jeffmakes/tr20-badge-hw/docs/conn/USB-Connector-TYPE-B-SMT-1-9.jpg

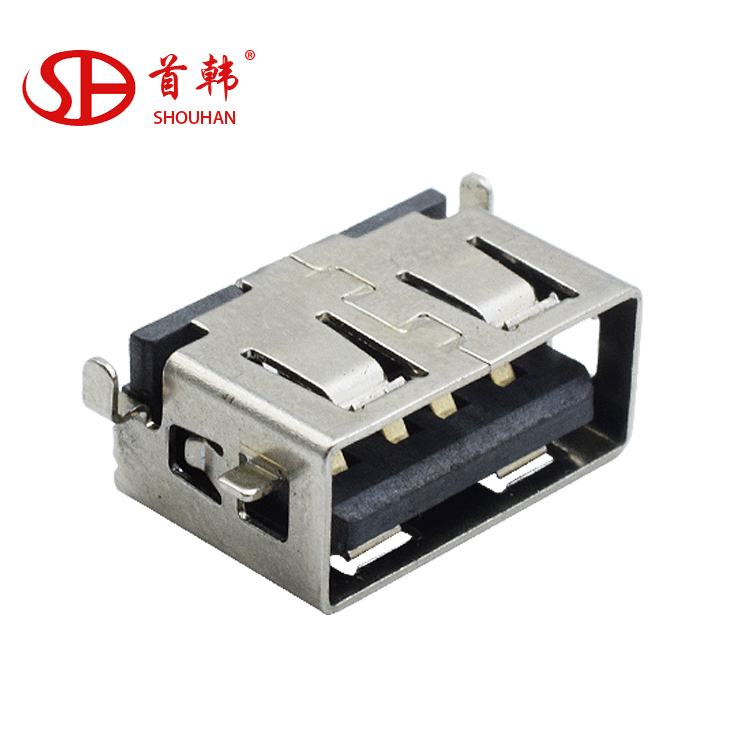
docs/conn/USB-Connector-TYPE-B-SMT-1-9.jpg
