jeffmakes/tr20-badge-hw/r1/graphics/tr20-3d-bottom.jpg

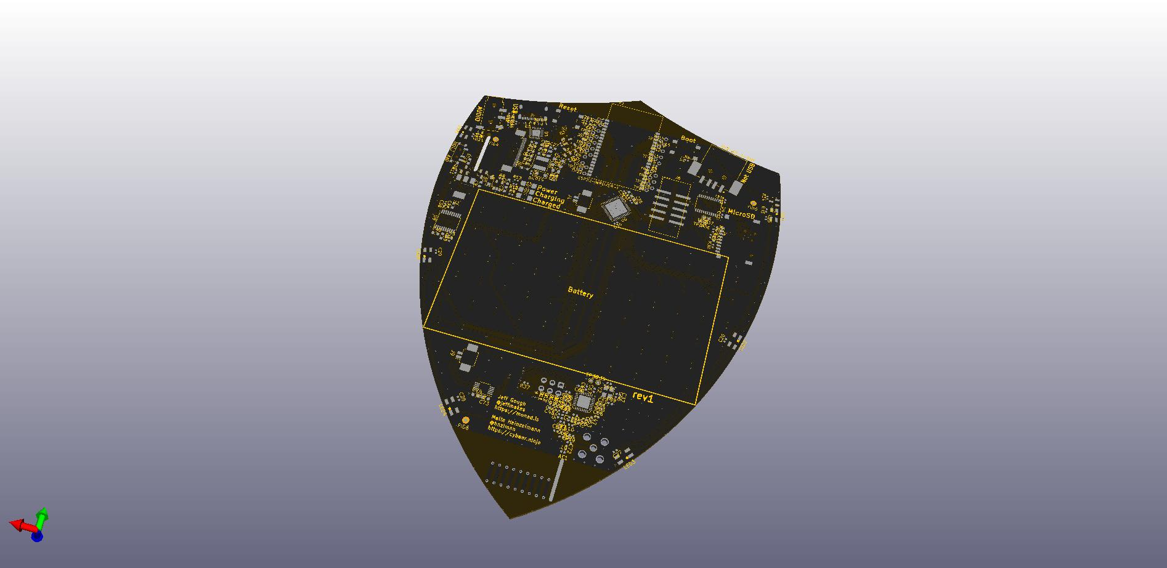
r1/graphics/tr20-3d-bottom.jpg
