jeffmakes/tr20-badge-hw/design/signals.ods

Sheet: ESP32 IO map
Subsystem | Device | Bus | Peripheral | TR20 Signal | ESP32 Signal | ESP32 Mux | GPIO | WROVER | Dir | Notes
External memory bus |  | SPI | SPI0 | nc |  | IO_MUX | 6
 |  | SPI | SPI0 | nc |  | IO_MUX | 7
 |  | SPI | SPI0 | nc |  | IO_MUX | 8
 |  | SPI | SPI0 | nc |  | IO_MUX | 9
 |  | SPI | SPI0 | nc |  | IO_MUX | 10
 |  | SPI | SPI0 | nc |  | IO_MUX | 11
Display | GDEH029A1 | SPI | SPI3 (VSPI) | MOSI | VSPID | IO_MUX | 23 | 37 | o
 |  | SPI | SPI3 (VSPI) | SCK | VSPICLK | IO_MUX | 18 | 30 | o
 |  |  | GPIO? | !DISP_CS | VSPICS0 | GPIO | 19 | 31 | o | Looks like we’re driving this manually in the display driver, not using the SPI peripheral
 |  |  | GPIO | !DC |  | GPIO | 27 | 12 | o
 |  |  | GPIO | DISP_BUSY |  | GPIO | 13 | 16 | i
 |  |  | GPIO | !DISP_RESET |  | GPIO | 0 | 25 | o | !RES reset line on display
Touch | IQS550 | I2C | I2C | SDA | I2CEXT0_SDA | GPIO | 4 | 26 | io
 |  | I2C | I2C | SCL | I2CEXT0_SCL | GPIO | 5 | 29 | o
 |  |  | GPIO | IQ_INT |  | GPIO | 36 | 4 | i
Haptic | ? | I2C
Shitty Add-On |  | I2C
Joystick / Buttons | PCA9555 | I2C | I2C | SDA |  | GPIO | 4 | 26 | io
 |  | I2C | I2C | SCL |  | GPIO | 5 | 29 | o
 |  |  | GPIO | BTN_INT |  | GPIO | 39 | 5 | i
USB-serial | CP2102N | UART | UART0 | TXD0 | U0TXD | IO_MUX | 1 | 35 | o
 |  | UART | UART0 | RXD0 | U0RXD | IO_MUX | 3 | 34 | i
Sound | PCM5100A | I2S | I2S0 | I2S_SD |  | GPIO | 25 | 10 | o | Any pin can be used, but let’s use 25 and 26 because they are the DAC1,2 outputs
 |  | I2S | I2S0 | I2S_SCK |  | GPIO | 26 | 11 | o | so we have the option of switching to internal DAC later…
 |  | I2S | I2S0 | I2S_WS |  | GPIO | 12 | 14 | o
Radio | CC1200 | SPI | SPI2 | MOSI | VSPID | IO_MUX | 23 | 37 | o | Connecting to the same SPI bus as the display, so we have enough pins free for SD card
 |  | SPI | SPI2 | MISO | VSPIQ | GPIO | 35 | 7 | i
 |  | SPI | SPI2 | SCK | VSPICLK | IO_MUX | 18 | 30 | o
 |  | SPI | SPI2 | !CC_CS | VSPICS1 | GPIO | 21 | 33 | o
 |  |  |  | CC_INT |  | GPIO | 34 | 6 | i
SD card |  | SD 1-bit | SD | SD_DAT0 | SD_DATA0 | IO_MUX | 2 | 24 | io
 |  | SD 1-bit | SD | SD_CMD | SD_CMD | IO_MUX | 15 | 23 | o
 |  | SD 1-bit | SD | SD_CLK | SD_CLK | IO_MUX | 14 | 13 | o
32kHz crystal |  | na | RTC | 32K_XN |  |  | 33 | 9 | a
 |  | na | RTC | 32K_XP |  |  | 32 | 8 | a
LED’s | WS2812? |  | ? | LED_DIN |  | GPIO | 22 | 36 | o
ESP usable GPIOS | Input only | Used by | WROVER pin
0 |  | !DISP_RESET | 25
1 |  | TXD0 | 35
2 |  | SD_DAT0 | 24
3 |  | RXD0 | 34
4 |  | SDA | 26
5 |  | SCL | 29
12 |  | I2S_WS | 14
13 |  | DISP_BUSY | 16
14 |  | SD_CLK | 13
15 |  | SD_CMD | 23
18 |  | SCK | 30
19 |  | !DISP_CS | 31
21 |  | !CC_CS | 33
22 |  | LED_DIN | 36
23 |  | MOSI | 37
25 |  | I2S_SD | 10
26 |  | I2S_SCK | 11
27 |  | !DC | 12
32 |  | 32K_XP | 8
33 |  | 32K_XN | 9
34 | y | CC_INT | 6
35 | y | MISO | 7
36 | y | IQ_INT | 4
39 | y | BTN_INT | 5

Sheet: PCA9555 IO map
PCA9555 | TR20 Signal | Notes
P0_0 | JOY_A
P0_1 | JOY_B
P0_2 | JOY_C
P0_3 | JOY_D
P0_4 | JOY_PUSH
P0_5 | BTN_A? | There may not be PCB space for buttons A and B because we need space for the CC1200 PCB antenna…
P0_6 | BTN_B? | There may not be PCB space for buttons A and B because we need space for the CC1200 PCB antenna…
P0_7 | BTN_START
P1_0 | CC_RESET | Hardware reset line for CC1200 is optional, since it supports reset over SPI, but this would be a bonus
P1_1 | IQ_RESET | Hardware reset line for the IQS550 – maybe useful for getting into the bootloader, though a software command exists
P1_2 | SD_DETECT | Presence of SD card
P1_3 | SAO_GPIO2 | Shitty addon GPIO2
P1_4
P1_5
P1_6
P1_7
