jeffmakes/tr20-badge-hw/r1/tr20-r1-mechanical/tr20-r1-coverlay.pdf

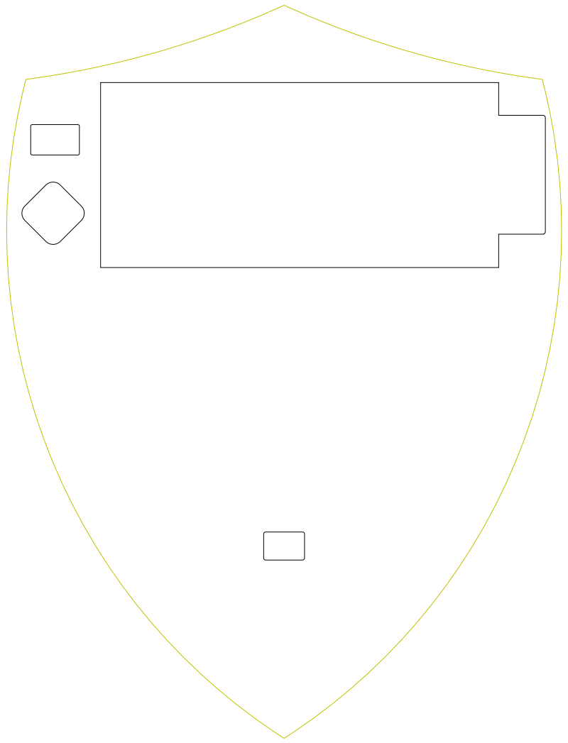
[picture p3: figure]
