jeffmakes/tr20-badge-hw/docs/display/Craft-Data-E-Paper-Product-List.pdf

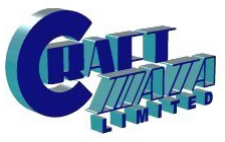
[picture p4: figure]

Craft Data Limited
- 01296 332000 01296 334625 Email: sales@craftdata.co.uk Web: www.craftdata.co.uk

# E-Paper Product List

Picture | Model | Specification

Mass
Production

Interface: SPI
GDEH154D27 Partial refresh | 1.54" (Dot Matrix EPD 200x200 dots) Outline Dimension: 31.8(H)x36.32(V)x1.05(D) mm | Yes
GDEP015OC1 Partial refresh | 1.54" (Dot Matrix EPD 200x200 dots) Outline Dimension: 31.8(H)x36.32(V)x1.05(D) m | Yes
GDEW0154Z17 | 1.54" 3‐color (Dot Matrix EPD 152x152 dots) Outline Dimension: 31.8(H)x37.32(V)x0.98(D) mm | Yes
GDEW154T8 Partial refresh | 1.54" (Dot Matrix EPD 152x152 dots) Outline Dimension: 31.8(H)x37.32(V)x0.98(D) mm | Yes
GDEW0154C39 | 1.54" 3‐color (Dot Matrix EPD 152x152 dots) Outline Dimension: 31.8(H)x37.32(V)x0.98(D) mm | Yes
1.54" Front Light | Outline Dimension: 36.32x31.8mm | Yes

GDE0213B1 Partial refresh | 2.13" (Dot Matrix EPD250x122dots) Outline Dimension: 29.20(H) x59.20 (V)x1.05(D)mm | Yes
GDEW0213Z16 | 2.13" 3‐color (Dot Matrix EPD 212x104 dots ) Outline Dimension: 59.2(H)×29.2 (V) ×0.98(D)mm | Yes
GDEW0213C38 | 2.13" 3‐color (Dot Matrix EPD 212x104 dots ) Outline Dimension: 59.2(H)×29.2 (V) ×0.98(D)mm | Yes
GDEW0213I5F Flexible | 2.13" (Dot Matrix EPD 212x104 dots) Outline Dimension: 59.2(H)×29.2 (V) ×0.3(D)mm | Yes
GDEW026T0 | 2.6" (Dot Matrix EPD 296x152dots) Outline Dimension: 36.30(H) x71.82 (V)x1.18(D)mm | Yes
GDEW027W3 | 2.7" (Dot Matrix EPD 264x176dots) Outline Dimension: 70.42(H) x45.8 (V)x0.98(D)mm | Yes
GDEW027C44 | 2.7" 3‐color(Dot Matrix EPD 264x176dots) Outline Dimension: 70.42(H) x45.8 (V)x0.98(D)mm | Yes
GDEH029A1 Partial refresh | 2.9" (Dot Matrix EPD 296x128 dots) Outline Dimension: 79.0 (H)×36.7 (V) ×1.05(D)mm | Yes

GDEW029Z10 | 2.9" 3‐color (Dot Matrix EPD 296x128 dots) Outline Dimension: 79.0 (H)x36.7 (V) x1.18(D)mm | Yes
GDEW029C32 | 2.9" 3‐color (Dot Matrix EPD 296x128 dots) Outline Dimension: 79.0 (H)x36.7 (V) x1.18(D)mm | Yes

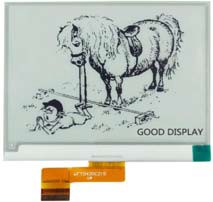
[picture p5: figure]

GDEW042T2 | 4.2" (Dot Matrix EPD 400x300 dots) Outline Dimension: 91.0(H)x77.0(V)x1.18(D)mm | Yes

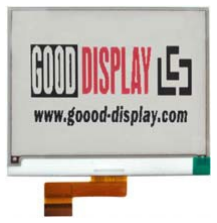
[picture p6: figure]

GDEW042Z15 | 4.2" 3‐color(Dot Matrix EPD 400x300 dots) Outline Dimension: 91.0(H)x77.0(V)x1.18(D)mm | Yes

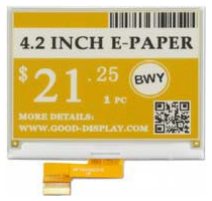
[picture p7: figure]

GDEW042C37 | 4.2" 3‐color(Dot Matrix EPD 400x300 dots) Outline Dimension: 91.0(H)x77.0(V)x1.18(D)mm | Yes

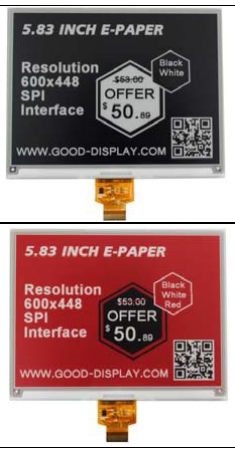
[picture p8: figure]

GDEW0583T7 | 5.83" (Dot Matrix EPD 600x488 dots) Outline Dimension: 125.40(H)*99.50(V)*1.18(D） | Yes
GDEW0583Z21 | 5.83" (Dot Matrix EPD 600x488 dots) Outline Dimension: 125.40(H)*99.50(V)*1.18(D） | Yes

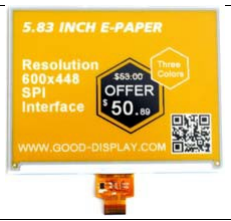
[picture p9: figure]

GDEW0583C64 | 5.83" (Dot Matrix EPD 600x448 dots) Outline Dimension: 125.40(H)*99.50(V)*1.18(D ） | Yes

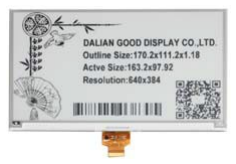
[picture p10: figure]

GDEW075T8 | 7.5" (Dot Matrix EPD 640x384 dots) Outline Dimension: 170.2(W)x111.2(H)x1.18(D)mm | Yes

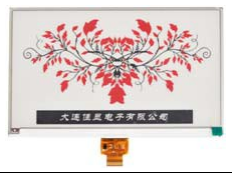
[picture p11: figure]

GDEW075Z09 | 7.5" 3‐color(Dot Matrix EPD 640x384 dots) Outline Dimension: 170.2(W)x111.2(H)x1.18(D)mm | Yes

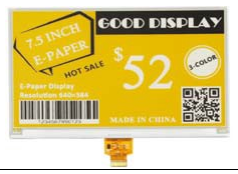
[picture p12: figure]

GDEW075C21 | 7.5" 3‐color(Dot Matrix EPD 640x384 dots) Outline Dimension: 170.2(W)x111.2(H)x1.18(D)mm | Yes
DESPI | Demo kit for above SPI interface E‐paper Matched type: 1.54", 2.13", 2.7", 2.9", 4.2", 7.5" B&W, B&W&R and B&W&Y e‐paper Fuction: normal refresh & fast refresh | N/A

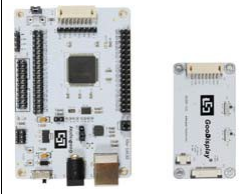
[picture p13: figure]

Interface：8 bits Parallel

GDE043A2 Parallel Grayscales | 4.3" HD interface (Dot Matrix EPD 800x600 dots) Outline Dimension: 74.6(W)x126.5(H)x1.17(D)m | Yes

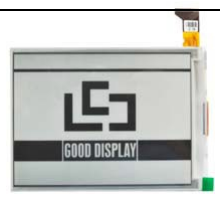
[picture p14: figure]

GDE060BA Parallel Grayscales | 6.0" HD interface (Dot Matrix EPD 800x600 dots) Outline Dimension: 101.8(W)x138.4(H)x2.7(D)mm | Yes

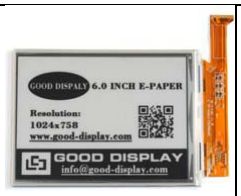
[picture p15: figure]

GDE060F3 High Resolution | 6.0" HD interface (Dot Matrix EPD 1024x758 dots) Outline Dimension: 101.8(W)x138.4(H)x1.18(D)m | Yes

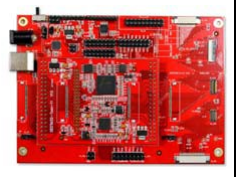
[picture p16: figure]

DESTM32-Tcon | Demo kit for above parallel interface E‐paper Matched type: 4.3" and 6" B&W e‐paper Function: fast refresh | N/A

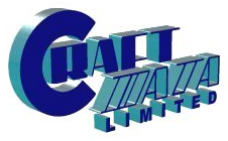
[picture p17: figure]

Craft Data Limited
Unit 4, Carrera House
Merlin Courtyard, Gatehouse Close Gatehouse Ind. Area
Aylesbury, Bucks, HP19 8DP
- 01296 332000 01296 334625
- sales@craftdata.co.uk
- www.craftdata.co.uk
