jeffmakes/tr20-badge-hw/docs/conn/SOFNG-TF-15-15_C111196.pdf

SOFNG-产品技术服务中心（技术支持）Tec nic | Ser ic | nter
內存卡連接器 | MICR SD-CARD SOCKETS

特点

- 按压式带复位 适用于小型机器的单向式；
- LCP 耐熱塑膠可滿足 次回流工藝；
用途
- 应用于移动、视听、汽车电子、多媒体、电器等各类
相关产品。

## SO F N G

開關、連接器

█ 523710 | 中国 • 广东 • 东莞 • 塘厦 • 塘厦大道中 136 号 | phon 40 628 780 | 網址 ww .ci din com (http://www.ciodin.com) Acknowl dgment[承認

# 東莞市碩方電子科技有限公司

「 NGGU | FN | ECTR NI | CHNO OG | o. | TD」
樣 品 承 認 專項 [Sampl Approv | Drawi g]
客戶判定[Custom | Determi e]：

说明[Remnrk]

客戶名稱[Custom r] | 客戶料號[Custom | P/N]
部品型號[Part Model] | TF - 15×15A | 技術參數[Paramet rs] | 環境に優しい材料

承認單位[3 Rese rc Institu e]

工程部 [R＆D] | 品保部 | C] | 采购部 Purchase]
工程部 [R＆D] | 品保部 C] | 采购部 Purchase]
章 承] | [章 承] | [章 承

S O F N G

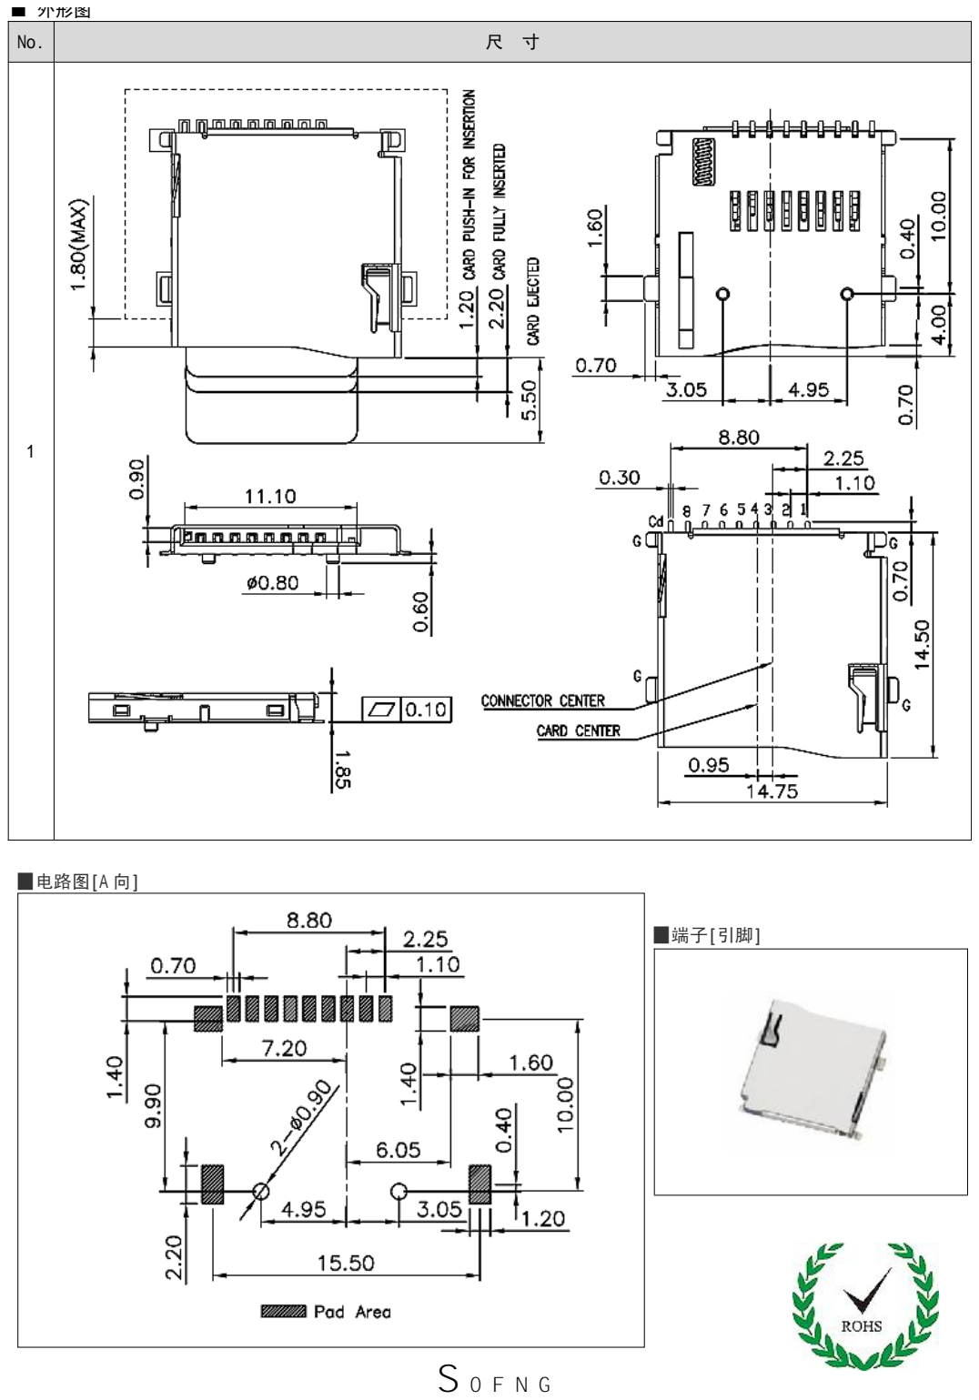
[picture p18: page 3]

S O F NG

No. | 尺寸

▉电路图[A 向

▉端子 引脚

■ 外形图

▉使用参数
╲ 等级 项目 ╲ | 级 产品 | 级 产品 | 级 产品
电气 性能 | 初期接触电阻 | 50mΩ max | 30mΩ max | 30mΩ max.
| 绝缘电阻 | 100mΩ min. 00 Skey/PD：50mΩ min.100 DC
| 耐电压 | 300 fo 1mi | 25 fo 1min
机械 性能 | 端子强度 | fo min | fo 1min.
操作 强度 | 工作方向 | 1200gf ± 2.0N.
| 回弹方向 | Push: 1000gf ±[200gf±0.5N.]
耐振性能 | 10 | N[条件：全振幅 1.5mmX, ,Z 方向 2H]
焊接 耐热 | 手工焊接 | 350±10℃ ﹢¹ | 300±10℃ ﹢¹
浸焊 | 270±10℃ 10﹢³ | 260± ℃ 10﹢³
回流 | 260℃ ma 20 ma | 255℃ ma 10 max
最大额定 电阻负荷 | 50 20m | 30 0.2A
使用温度范围 | -10℃ +60℃
耐久性 能 | 无负荷寿命 | 10,000 Cycles | 6,500 Cycles | 無數據
| 负荷寿命 额定负荷 | 8,500 Cycles 50mΩ max. | 5,000 Cycles 30mΩ max. | 無數據
耐环境 性能 | 耐寒性能 | -40± ℃ fo 96 | -20± ℃ fo 96h
| 耐热性能 | 85± ℃ fo 96 | 75± ℃ fo 96h
| 耐湿性能 | 40± ℃,9 95 fo 96h

▉焊接条件
手焊式

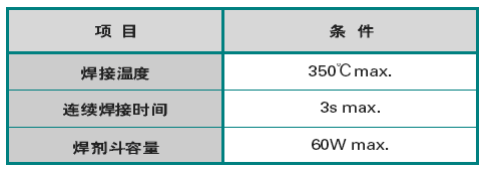
[picture p19: figure]

回流焊
适用表面贴装型产品
1. 加热方式 | 以远红外线上下加热方式。
2. 温度测量 | 用Φ0.1~0.2 的 CA（ ）或 CC（ ）测量位置在焊接连接部（锡 铜箔面）。
3. 固定方式 | 采用耐热胶带。
4. 温度分布 | （图 2.15）

S O F NG

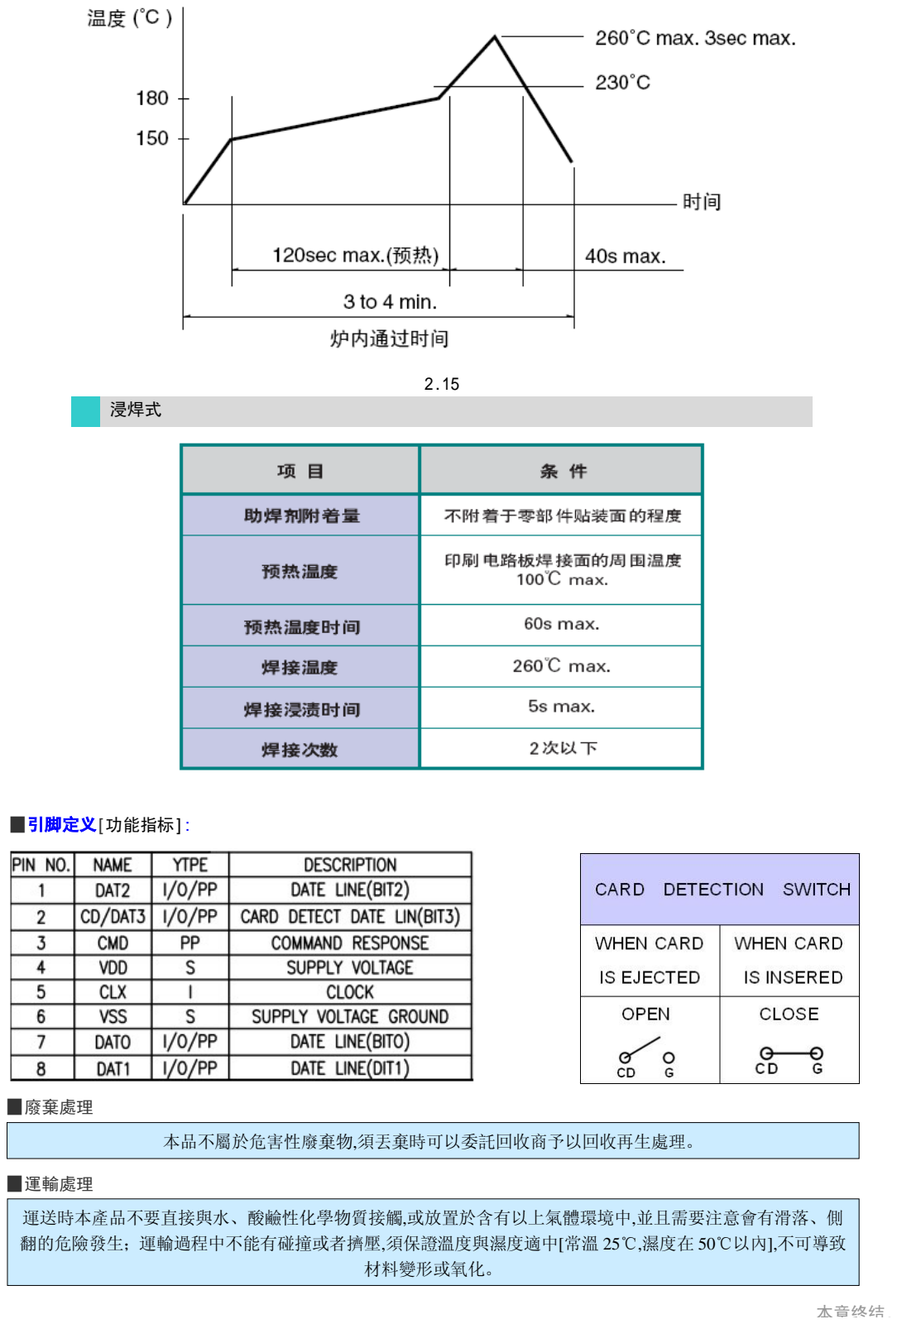
[picture p20: page 5]

2.15
浸焊式

▉引脚定义 功能指标

▉廢棄處理

▉運輸處理

本章终结

本品不屬於危害性廢棄物,須丟棄時可以委託回收商予以回收再生處理。

運送時本產品不要直接與水、酸鹼性化學物質接觸,或放置於含有以上氣體環境中,並且需要注意會有滑落、側 翻的危險發生；運輸過程中不能有碰撞或者擠壓,須保證溫度與濕度適中[常溫 25℃,濕度在 50℃以內],不可導致 材料變形或氧化。
