jeffmakes/tr20-badge-hw/r1/graphics/tr20-3d-top.png

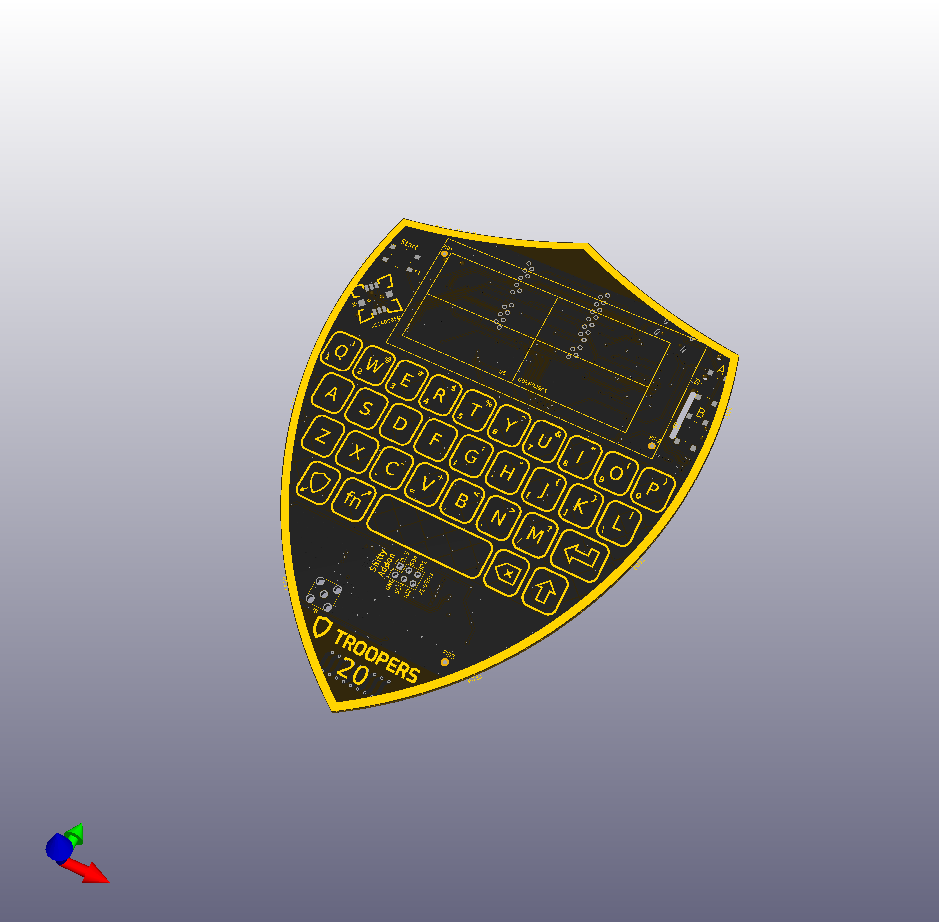
r1/graphics/tr20-3d-top.png
