jeffmakes/tr20-badge-hw/r1/graphics/tr20-silk.kicad_pcb/.svg2shenzhen-cache/images/B.Silk_g6244.png

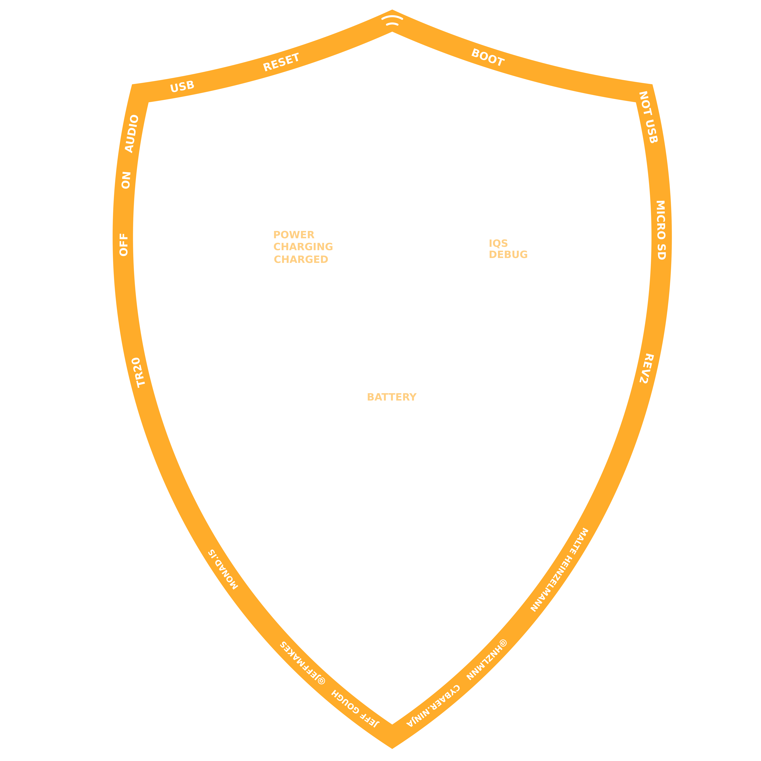
r1/graphics/tr20-silk.kicad_pcb/.svg2shenzhen-cache/images/B.Silk_g6244.png
