jeffmakes/tr20-badge-hw/r1/graphics/tr20-silk.kicad_pcb/.svg2shenzhen-cache/images/F.Cu_g16822.png

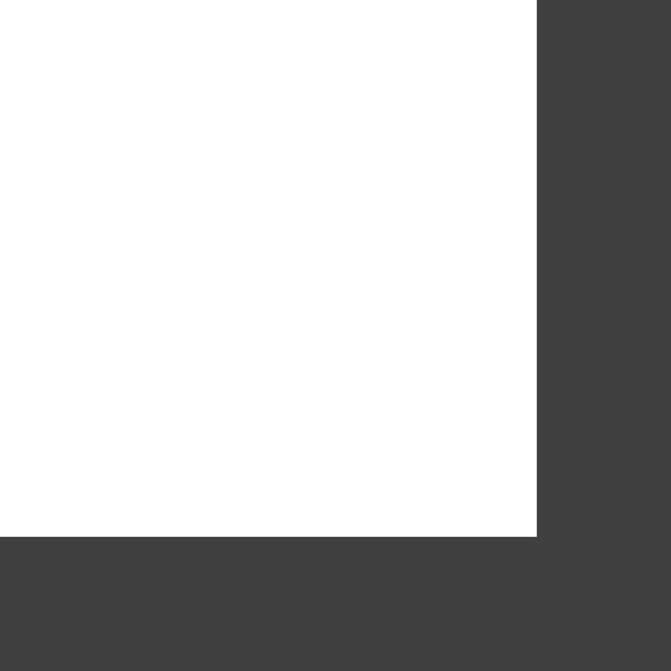
r1/graphics/tr20-silk.kicad_pcb/.svg2shenzhen-cache/images/F.Cu_g16822.png
