jeffmakes/tr20-badge-hw/r1/graphics/tr20-silk.kicad_pcb/.svg2shenzhen-cache/images/F.Silk_g16826.png

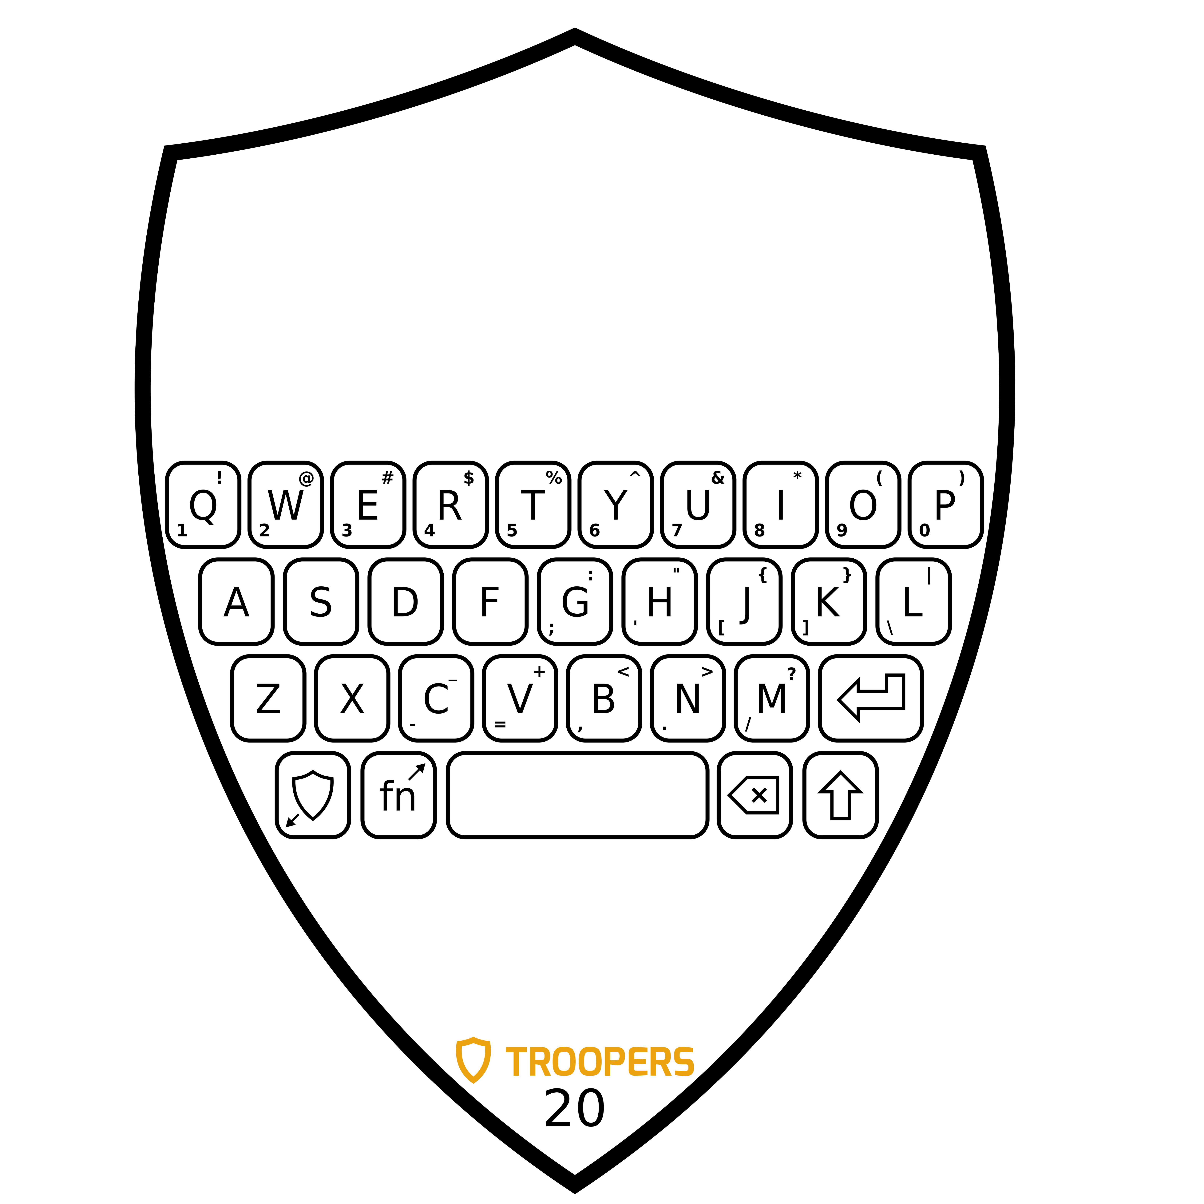
r1/graphics/tr20-silk.kicad_pcb/.svg2shenzhen-cache/images/F.Silk_g16826.png
