jeffmakes/tr20-badge-hw/r1/bom/tr20 (2) materials price.xlsx

Designator | Qty | Value | Manufacturer | Part number | LCSC | Digikey | Price USD | Line price | Substitute | Description | Notes / TODO | Footprint | RMB |  | Exchange rate | 0.14
A1, | 1 | ESP32-WROVER-I | Espressif | ESP32-WROVER-I |  |  | 4.200 | 4.20 |  |  | Expensive | jeffmakes-footprints:ESP32-WROVER-I | 22.425
AE1, | 1 | DNP |  |  |  |  |  |  |  |  |  | jeffmakes-footprints:Antenna_TI_DN038 | 0
C1, C2, C45, C46, C52, | 5 | 15pF |  |  |  |  |  | 0.00 |  | C0G/NP0, 15pF, 50V, -5%/+5% | Critical |  | 0.010925 | 10k/reel
C13, C14, | 2 | 4.7uF |  |  |  |  |  | 0.00 |  |  | 50V Critical | Capacitor_SMD:C_0805_2012Metric | 0.207 | 3k/reel
C3, C5, C11, C25, C26, C27, C28, C29, C30, C31, C34, C41, C42, | 13 | 100nF |  |  |  |  |  |  |  |  |  | Capacitor_SMD:C_0402_1005Metric | 0.010925 | 10k/reel
C32, C35, C49, | 3 | 100pF |  |  |  |  |  | 0.00 |  | C0G/NP0, 100pF, 50V, -5%/+5% | Critical | Capacitor_SMD:C_0402_1005Metric | 0.010925 | 10k/reel
C37, C64, C70, | 3 | DNP |  |  |  |  |  |  |  |  |  | Capacitor_SMD:C_0402_1005Metric | 0
C4, C12, | 2 | 22uF |  |  |  |  |  | 0.00 |  | 10V |  | Capacitor_SMD:C_0603_1608Metric | 0.1127 | 4k/reel
C47, | 1 | 1.5nF |  | GRM1557U1A152JA01D | C162143 |  |  | 0.00 |  | U2J, 1.5nF, 10V, -5%/+5% | Critical – U2J, UJ, C0G only. (X7R is not suitable) | Capacitor_SMD:C_0402_1005Metric | 0.0874 | 10k/reel
C48, C66, | 2 | 10nF |  |  |  |  |  | 0.00 |  | X7R, 10nF, 25V, -10%/+10% |  | Capacitor_SMD:C_0402_1005Metric | 0.010925 | 10k/reel
C50, | 1 | 33pF |  |  |  |  |  | 0.00 |  | C0G/NP0, 33pF, 50V, -5%/+5% | Critical | Capacitor_SMD:C_0402_1005Metric | 0.010925 | 10k/reel
C51, C53, C56, C58, C59, C62, C63, C65, C67, C69, C71, | 11 | 47nF |  |  |  |  |  | 0.00 |  | X5R, 47nF, 25V, -10%/+10% | Critical | Capacitor_SMD:C_0402_1005Metric | 0.0207 | 10k/reel
C54, C60, | 2 | 3.3pF |  |  |  |  |  | 0.00 |  | C0G/NP0, 3.3pF, 50V, -0.25pF/+0.25pF | Critical | Capacitor_SMD:C_0402_1005Metric | 0.010925 | 10k/reel
C55, C72, | 2 | 1pF |  |  |  |  |  | 0.00 |  | C0G/NP0, 1pF, 50V, -0.1pF/+0.1pF | Critical | Capacitor_SMD:C_0402_1005Metric | 0.010925 | 10k/reel
C57, | 1 | 2.2pF |  |  |  |  |  | 0.00 |  | C0G/NP0, 2.2pF, 50V, -0.25pF/+0.25pF | Critical | Capacitor_SMD:C_0402_1005Metric | 0.010925 | 10k/reel
C6, C7, C8, C9, C10, C15, C16, C17, C18, C19, C20, C21, C22, C23, C24, C33, C36, C39, C40, C43, C44, C73, C74, | 23 | 1uF |  |  |  |  |  | 0.00 |  | X5R, 1uF, 50V, -10%/+10% | 50V Critical | Capacitor_SMD:C_0603_1608Metric | 0.04485 | 10k/reel
C61, | 1 | 3pF |  |  |  |  |  | 0.00 |  | C0G/NP0, 3pF, 50V, -0.25pF/+0.25pF | Critical | Capacitor_SMD:C_0402_1005Metric | 0.010925 | 10k/reel
C68, | 1 | 220nF |  |  |  |  |  | 0.00 |  | X5R, 220nF, 10V, -15%/+15% |  | Capacitor_SMD:C_0402_1005Metric | 0.023 | 10k/reel
D1, | 1 | Green |  |  |  |  |  | 0.00 | Y | LED GREEN CLEAR 1206 SMD |  | digikey-footprints:1206 | 0.0368 | 3k/reel
D2, | 1 | Orange |  |  |  |  |  | 0.00 | Y | LED ORANGE CLEAR 1206 SMD |  | digikey-footprints:1206 | 0.0368 | 3k/reel
D3, D8, D9, D10, | 4 | SS13FL | On Semi | SS13FL |  |  | 0.090 | 0.36 | C | Schottky 30V 1A |  | Diode_SMD:D_SOD-123F | 0.4025 | 3k/reel
D4, | 1 | Yellow |  |  |  |  |  | 0.00 | Y | LED YELLOW CLEAR 1206 SMD |  | digikey-footprints:1206 | 0.0368 | 3k/reel
D5, D6, D7, D17, D18, D19, D20, D21, | 8 | ESD5Z6.0T5G |  |  |  |  |  |  |  |  |  | jeffmakes-footprints:SOD-523-numbered-pads | 0.207 | 3k/reel
J1, J9, | 2 | 532610271 | Molex |  |  |  |  |  |  |  |  | Connector_Molex:Molex_PicoBlade_53261-0271_1x02-1MP_P1.25mm_Horizontal | 0.092 | 1.5k/reel
J10, | 1 | PJ-320D | Korean Hroparts | PJ-320D | C95562 |  | 0.050 | 0.05 | C | Audio Jack, 3.5mm SMD |  | Connector_Audio:Jack_3.5mm_PJ320D_Horizontal | 0.23
J2, | 1 | USB-C-12 | Korean Hroparts | TYPE-C-31-M-17 | C283540 |  | 0.012 | 0.01 | C | USB-C connector, 12 pin |  | jeffmakes-footprints:jing-usb-c-lcsc-C167321 | 0.4025
J3, | 1 | UJ2-AH-1-SMT | Jing |  | C46400 |  | 0.025 | 0.03 | C | USB-A connector SMD | Low stock at LCSC | jeffmakes-footprints:jing-lcsc-C46400 | 0.207
J4, | 1 | TF-15x15 | SOFNG |  | C111196 |  | 0.092 | 0.09 | C | MicroSD connector, ejector |  | jeffmakes-footprints:microSD_HC_Sofng_TF-15 | 0.345
J6, | 1 | DNP |  |  |  |  |  |  |  |  |  | Connector_PinHeader_2.54mm:PinHeader_1x05_P2.54mm_Vertical
J7, | 1 | M20-7870246 | Connfly | DS1023-2*2SF11 | C92273 |  | 0.034 | 0.03 | Y |  | Change to 2x3? | jeffmakes-footprints:PinSocket_2x02_P2.54mm_Vertical_mirror_numbering | 0.207
J8, | 1 | DNP |  |  |  |  |  |  |  |  |  | Connector_Coaxial:SMA_Amphenol_132134-10_Vertical
JP1, | 1 | DNP |  |  |  |  |  |  |  |  |  | Connector_PinHeader_2.54mm:PinHeader_1x02_P2.54mm_Vertical
L1, | 1 | 10uH 1A | SXN | SMNR5020-100MT | C135285 |  | 0.050 | 0.05 | Y | 10uH, 1A, 5x5x2mm |  | Inductor_SMD:L_Taiyo-Yuden_MD-5050 | 0.161
L2, | 1 | 10nH | Murata | LQW15AN10NJ00D |  |  | 0.020 | 0.02 | N | Inductor | Critical | Inductor_SMD:L_0402_1005Metric | 0.1495 | 10k/reel
L3, L6, L8, L9, L10, | 5 | 12nH | Murata | LQW15AN12NJ00D |  |  | 0.020 | 0.10 | N | Inductor | Critical | Inductor_SMD:L_0402_1005Metric | 0.1495 | 10k/reel
L4, | 1 | 15nH | Murata | LQW15AN15NJ00D |  |  | 0.020 | 0.02 | N | Inductor | Critical | Inductor_SMD:L_0402_1005Metric | 0.1495 | 10k/reel
L5, | 1 | 7.5nH | Murata | LQW15AN7N5G00D |  |  | 0.020 | 0.02 | N | Inductor | Critical | Inductor_SMD:L_0402_1005Metric | 0.1495 | 10k/reel
L7, | 1 | 18nH | Murata | LQW15AN18NJ00D |  |  | 0.020 | 0.02 | N | Inductor | Critical | Inductor_SMD:L_0402_1005Metric | 0.1495 | 10k/reel
LED1, LED2, LED3, LED4, LED5, LED6, | 6 | SK6812 |  | SK6812 | C114583 |  | 0.0675 | 0.405 | Y | RGB LED with integrated controller |  | jeffmakes-footprints:LED_SK6812MINI_PLCC4_3.5x3.5mm_P1.75mm_no_silk | 0.299
Q1, Q2, Q3, Q7, | 4 | MMBT3904-TP | generic | MMBT3904 | C181119 |  | 0.004 | 0.02 | Y | TRANS NPN 40V 0.2A SOT23 |  | digikey-footprints:SOT-23-3 | 0.0345 | 3k/reel
Q4, Q5, | 2 | DMG2305UX-13 | Diodes Inc. | DMG2305UX-13 | C144153 |  | 0.004 | 0.01 | C | MOSFET P-CH 20V 4.2A SOT23 |  | digikey-footprints:SOT-23-3 | 0.207 | 3k/reel
Q6, | 1 | SSM3K376R | Toshiba | SSM3K376R |  |  | 0.11 | 0.11 | Y | MOSFET N-CH 30V 56mOhm @ 2A, 4.5V |  | Package_TO_SOT_SMD:SOT-23 | 0.345 | 3k/reel
R1, R2, R3, R6, R7, R11, R12, R14, R15, R16, R19, R28, R29, R30, R31, R32, R37, | 17 | 10k |  |  |  |  |  |  |  | +/- 10% |  | Resistor_SMD:R_0402_1005Metric | 0.00184 | 15k/reel
R33, | 1 | 3R |  |  |  |  |  |  |  | +/- 5% |  | Resistor_SMD:R_0402_1005Metric | 0.00253 | 15k/reel
R36, | 1 | 56k |  |  |  |  |  |  |  | +/- 1% |  | Resistor_SMD:R_0402_1005Metric | 0.00184 | 15k/reel
R38, | 1 | 10R |  |  |  |  |  |  |  | +/- 5% |  | Resistor_SMD:R_0402_1005Metric | 0.00184 | 15k/reel
R39, | 1 | DNP |  |  |  |  |  |  |  |  |  | Resistor_SMD:R_0402_1005Metric | 0
R4, R5, R8, R9, R10, R13, R17, R34, R35, | 9 | 1k |  |  |  |  |  |  |  | +/- 10% |  | Resistor_SMD:R_0402_1005Metric | 0.00184 | 15k/reel
R40, | 1 | 0R |  |  |  |  |  |  |  | +/- 10% |  | Resistor_SMD:R_0402_1005Metric | 0.00184 | 15k/reel
S1, S2, S4, S5, S7, | 5 | PTS645SM43SMTR92_LFS |  |  |  |  |  |  |  | SWITCH TACTILE 6x6 SMD | Yellow possible? Pantone 1375C | digikey-footprints:Switch_Tactile_SMD_6x6mm_PTS645 | 0.1725
S3, | 1 | K3-1296S-E1 | Korean Hroparts | K3-1296S-E1 | C128955 |  | 0.050 | 0.05 | Y | SWITCH SLIDE SMD |  | jeffmakes-footprints:SW_JS102011SAQN | 0.207
S6, | 1 | K1-5202UA-03 | Korean Hroparts | K1-5202UA-03 | C145899 |  | 0.277 | 0.28 | C | 5-position tactile switch | Zhejiang Jianfu cheaper? | jeffmakes-footprints:SW_JS1400BFQ-arrows | 1.38
TP1, TP2, TP3, TP4, TP5, TP6, TP7, TP8, TP9, TP10, TP11, TP12, TP13, TP14, TP15, TP16, TP17, TP18, TP19, TP20, TP21, TP22, TP23, TP24, TP25, TP26, TP27, TP28, TP29, TP30, TP31, TP32, TP33, TP33, TP38, TP39, | 36 | DNP |  |  |  |  |  |  |  |  |  | jeffmakes-footprints:test-pad-1.4-TH | 0
U1, | 1 | MCP73831T-2ACI_OT | Microchip Semi | MCP73831T-3ACI/OT | C14879 | MCP73831T-3ACI/OTCT-ND | 0.34 | 0.34 | Y | IC CONTROLLR LI-ION 4.2V SOT23-5 | Is there a Chinese version? | digikey-footprints:SOT-753 | 3.22
U10, | 1 | DRV2605LDGS | Texas Instuments | DRV2605LDGS |  | 296-40032-1-ND | 1.65 | 1.65 | C |  | Expensive | Package_SO:VSSOP-10_3x3mm_P0.5mm | 14.375
U2, | 1 | AP2114H-3_3TRG1 | Diodes Inc. | AP2114H | C150716 |  | 0.060 | 0.06 | C | IC REG LINEAR 3.3V 1A SOT223 |  | digikey-footprints:SOT-223 | 0.6325
U3, | 1 | CP2102N-A01-GQFN24 | Si Labs | CP2102N-A01-GQFN24 |  | 336-4737-1-ND | 1.250 | 1.25 | C | USB to UART master bridge, QFN-24 | Is QFN20 variant easier to get? | Package_DFN_QFN:QFN-24-1EP_4x4mm_P0.5mm_EP2.6x2.6mm | 7.0725
U4, | 1 | PCA9555 | Texas Instuments | PCA9555PW |  | 568-3986-5-ND | 0.98 | 0.98 | C | I2C IO Expander, with internal pull-ups | Is there a Chinese version? | Package_SO:TSSOP-24_4.4x7.8mm_P0.65mm | 3.0475
U5, | 1 | 8.02a0.024200 | Dianwei | 8.02A0.024200 |  |  | 0.15 | 0.15 | Y | Display connector – FFC, 24 pos, 0.5mm pitch |  | jeffmakes-footprints:GDEH029A1 | 0.483
U6, | 1 | IQS550 | Azoteq | IQS550-BL-QNR |  | 1790-1046-1-ND | 1.560 | 1.56 | N |  | Expensive | Package_DFN_QFN:QFN-48-1EP_7x7mm_P0.5mm_EP5.45x5.45mm | 13.8
U8, | 1 | PCM5100A | Texas Instuments | PCM5100APW | C131154 |  | 0.54 | 0.54 | C | 2VRMS DirectPath, 100dB Audio Stereo DAC with 32-bit, 384kHz PCM Interface, TSSOP-20 |  | Package_SO:TSSOP-20_4.4x6.5mm_P0.65mm | 3.5995
U9, | 1 | CC1200 | Texas Instuments | CC1200 |  |  | 3.220 | 3.22 | N | Low-Power, High-Performance RF Transceiver, QFN-32 | Expensive | Package_DFN_QFN:QFN-32-1EP_5x5mm_P0.5mm_EP3.45x3.45mm | 12.075
XY1, | 1 | DNP |  |  |  |  |  |  |  |  |  | jeffmakes-footprints:Touch_Array_TR20 | 0
Y1, | 1 | 32.768kHz | Seiko Epson | Q13FC1350000200 | C48615 |  | 0.095 | 0.10 | C | 32.768kHz, 7pF |  | Crystal:Crystal_SMD_3215-2Pin_3.2x1.5mm | 0.69
Y2, | 1 | 40Mhz | Seiko Epson | X1E000021017700 | C255943 |  | 0.120 | 0.12 | C | 40Mhz, 10ppm, 10ppm, 7pF, 40ohm | Critical | Crystal:Crystal_SMD_3225-4Pin_3.2x2.5mm | 0.69
Linear Resonant Actuator | 1 | 0832 | Ineed Youngsun Technology Co., Ltd. | C0832BE03L15 |  |  | 1.200 | 1.20 |  | Linear Resonant Actuator Ø8x3.2T, 235Hz, 1.8Vrms AC |  |  | 4.14
Batt | 1 | 1500mAh | Blue Taiyang | LP375080 |  |  | 3.1 | 3.1 | C | 1500mAh Lipo with Molex 510210200, 50mm wire length | Expensive |  | 17.94
Earbuds | 1 |  |  |  |  |  | 1 | 1 |  |  |  |  | 0
Display | 1 | GDEH029A1 | Good Display | GDEH029A1 |  |  | 6.000 | 6 | N |  | Expensive |  | 55.2
USB-C cable | 1 |  | San Guan Siyuan |  |  |  | 0.600 | 0.6 |  | Custom, 0.75m
PCB Assembly | 1 |  |  |  |  |  | 15 | 15
PCB Fabrication | 1 |  |  |  |  |  | 5 | 5
 |  |  |  |  |  |  | Total USD | 47.73
 |  |  |  |  |  |  |  |  | Y | Substitution desired
 |  |  |  |  |  |  |  |  | C | Check before substituting
 |  |  |  |  |  |  |  |  | N | Do not substitute
