jeffmakes/tr20-badge-hw/r1/bom/tr20-omg.xlsx

References | Quantity Per PCB | Value | Rating | Manufacturer | MPN | LCSC equiv. | Reel | Reels | Qty | Unit RMB an | Unit USD an | Unit USD jeff | Line RMB | Line USD | Substitute | Description | Package | Notes
A1 | 1 | ESP32-WROVER |  | Espressif | ESP32-WROVER | C129145 |  |  | 550 | 22.425 | 3.14 | 4.20 | 12333.75 | 1726.725 |  |  | ESP32-WROVER | Expensive
C47 | 1 | 1.5nF |  | Murata | GRM1557U1A152JA01D | C162143 | 10000 | 1 | 10000 | 0.0874 | 0.01 |  | 874.00 | 122.36 | C | U2J, 1.5nF, 10V, -5%/+5% | C_0402_1005Metric | Critical – U2J, UJ, C0G only. (X7R is not suitable)
C3 C5 C11 C25 C26 C27 C28 C29 C30 C31 C34 C38 C41 C42 C75 | 15 | 100nF |  | Samsung | CL05B104KO5NNNC |  | 10000 | 1 | 10000 | 0.010925 | 0.0015295 |  | 109.25 | 15.295 |  |  | C_0402_1005Metric
C32 C35 C49 | 3 | 100pF |  | Murata | GRM1555C1H101JA01D |  | 10000 | 1 | 10000 | 0.010925 | 0.0015295 |  | 109.25 | 15.295 |  | C0G/NP0, 100pF, 50V, -5%/+5% | C_0402_1005Metric | Critical
C48 C66 | 2 | 10nF |  | Murata | GRM155R71E103KA01D |  | 10000 | 1 | 10000 | 0.010925 | 0.0015295 |  | 109.25 | 15.295 |  | X7R, 10nF, 25V, -10%/+10% | C_0402_1005Metric
C1 C2 C45 C46 C52 | 5 | 15pF |  | Murata | GRM1555C1H150JA01D |  | 10000 | 1 | 10000 | 0.010925 | 0.0015295 |  | 109.25 | 15.295 |  | C0G/NP0, 15pF, 50V, -5%/+5% | C_0402_1005Metric | Critical
C55 C72 | 2 | 1pF |  | Murata | GRM1555C1H1R0BA01D |  | 10000 | 1 | 10000 | 0.010925 | 0.0015295 |  | 109.25 | 15.295 |  | C0G/NP0, 1pF, 50V, -0.1pF/+0.1pF | C_0402_1005Metric | Critical
C6 C7 C8 C9 C10 C15 C16 C17 C18 C19 C20 C21 C22 C23 C24 C33 C36 C39 C40 C43 C44 C73 C74 | 23 | 1uF | 50V | Samsung | CL10A105KB8NNNC |  | 10000 | 2 | 20000 | 0.04485 | 0.01 |  | 897.00 | 125.58 |  | X5R, 1uF, 50V, -10%/+10% | C_0603_1608Metric | 50V Critical
C57 | 1 | 2.2pF |  | Murata | GRM1555C1H2R2CA01D |  | 10000 | 1 | 10000 | 0.010925 | 0.0015295 |  | 109.25 | 15.295 |  | C0G/NP0, 2.2pF, 50V, -0.25pF/+0.25pF | C_0402_1005Metric | Critical
C68 | 1 | 220nF |  | Samsung | CL05A224KP5NNNC |  | 10000 | 1 | 10000 | 0.023 | 0.00322 |  | 230.00 | 32.2 |  | X5R, 220nF, 10V, -15%/+15% | C_0402_1005Metric
C4 C12 | 2 | 22uF | 10V | Samsung | CL10A226MP8NUNE |  | 4000 | 1 | 4000 | 0.1127 | 0.02 |  | 450.80 | 63.112 |  | X5R, 22uF,10V, 0603, -20%/+20% | C_0603_1608Metric
C54 C60 | 2 | 3.3pF |  | Murata | GRM1555C1H3R3WA01D |  | 10000 | 1 | 10000 | 0.010925 | 0.0015295 |  | 109.25 | 15.295 |  | C0G/NP0, 3.3pF, 50V, -0.25pF/+0.25pF | C_0402_1005Metric | Critical
C50 | 1 | 33pF |  | Murata | GRM1555C1H330JA01D |  | 10000 | 1 | 10000 | 0.010925 | 0.0015295 |  | 109.25 | 15.295 |  | C0G/NP0, 33pF, 50V, -5%/+5% | C_0402_1005Metric | Critical
C61 | 1 | 3pF |  | Murata | GRM1555C1H3R0BA01D |  | 10000 | 1 | 10000 | 0.010925 | 0.0015295 |  | 109.25 | 15.295 |  | C0G/NP0, 3pF, 50V, -0.25pF/+0.25pF | C_0402_1005Metric | Critical
C13 C14 | 2 | 4.7uF | 50V | Samsung | CL21A475KBQNNNE |  | 3000 | 1 | 3000 | 0.207 | 0.03 |  | 621.00 | 86.94 |  | X5R, 4.7uF, 50V, 0805, -10%/+10% | C_0805_2012Metric | 50V Critical
C51 C53 C56 C58 C59 C62 C63 C65 C67 C69 C71 | 11 | 47nF |  | Murata | GRM155R71E473KA88D |  | 10000 | 1 | 10000 | 0.0207 | 0.002898 |  | 207.00 | 28.98 |  | X5R, 47nF, 25V, -10%/+10% | C_0402_1005Metric | Critical
D5 D6 D7 D11 D12 D17 D18 D19 D20 D21 | 10 | ESD5Z6.0T5G | 6V | On Semi | ESD5Z6.0T5G | C261278 | 3000 | 2 | 6000 | 0.207 | 0.03 |  | 1242.00 | 173.88 | Y | Bidirectional transient-voltage-suppression diode 6V | SOD-523-numbered-pads
D1 | 1 | Green |  | Lite-On Inc. | LTST-C150KGKT | C99881 | 3000 | 1 | 3000 | 0.0368 | 0.01 |  | 110.40 | 15.456 | Y | LED GREEN CLEAR 1206 SMD | 1206
D2 | 1 | Orange |  | Lite-On Inc. | LTST-C150KSKT | C130716 | 3000 | 1 | 3000 | 0.0368 | 0.01 |  | 110.40 | 15.456 | Y | LED ORANGE CLEAR 1206 SMD | 1206
D3 D8 D9 D10 | 4 | SS13FL |  | On Semi. | SS13FL | C190475 | 3000 | 1 | 3000 | 0.4025 | 0.06 |  | 1207.50 | 169.05 | Y | Schottky diode 30V, 1A, 500ns | D_SOD-123F
D4 | 1 | Yellow |  | Lite-On Inc. | LTST-C150KSKT | C93094 | 3000 | 1 | 3000 | 0.0368 | 0.01 |  | 110.40 | 15.456 | Y | LED YELLOW CLEAR 1206 SMD | 1206
J6 | 1 | 3020-10-0300-00 |  | CNC Tech | 3020-10-0300-00 |  |  |  | 550 |  | 0.00 |  | 0.00 | 0 | Y |  | IDC-Header_2x05_P2.54mm_Vertical_SMD | Urgent: source for rev1
J1 J9 | 2 | 532610271 |  | Molex | 532610271 | C132528 | 1500 | 1 | 1500 | 0.092 | 0.01 |  | 138.00 | 19.32 | C |  | Molex_PicoBlade_53261-0271_1x02-1MP_P1.25mm_Horizontal
J5 | 1 | AFC07-S24ECA-00 |  | Jushuo | AFC07-S24ECA-00 | C262643 |  |  | 550 | 0.483 | 0.07 |  | 265.65 | 37.191 | C | FFC connector, top contact, 24pos, 0.5mm pitch
J7 | 1 | M20-7870246 |  | Connfly | DS1023-2*3SF11 | C92272 |  |  | 550 | 0.207 | 0.03 | 0.03 | 113.85 | 15.939 | Y |  | PinSocket_2x03_P2.54mm_Vertical
J10 | 1 | PJ-320D |  | Korean Hroparts | PJ-320D-A | C431535 |  |  | 550 | 0.23 | 0.03 | 0.05 | 126.50 | 17.71 | C | Audio Jack, 3.5mm SMD | Jack_3.5mm_PJ320D_Horizontal
J4 | 1 | TF-15x15 |  | SOFNG | TF-15x15 | C111196 |  |  | 550 | 0.345 | 0.05 | 0.09 | 189.75 | 26.565 | C | MicroSD connector, ejector | microSD_HC_Sofng_TF-15
J3 | 1 | U-A-24SS-W-1 |  | Korean Hroparts |  | C283549 |  |  | 550 |  | 0.00 | 0.09 | 0.00 | 0 | C | USB-A connector SMD | jing-lcsc-C46400 | Changed part
J2 | 1 | USB-C-12 |  | Jing | C167321 | C283540 |  |  | 550 | 0.4025 | 0.06 | 0.21 | 221.38 | 30.9925 | C | USB-C connector, 12 pin | jing-usb-c-lcsc-C167321
L2 | 1 | 10nH |  | Murata | LQW15AN10NJ00D | C184029 | 10000 | 1 | 10000 | 0.1495 | 0.02 | 0.02 | 1495.00 | 209.3 | N | Inductor | L_0402_1005Metric | Critical
L1 | 1 | 10uH 1A |  | SXN | SMNR5020-100MT | C135285 |  |  | 550 | 0.161 | 0.02 | 0.05 | 88.55 | 12.397 | Y | 10uH, 1A, 5x5x2mm | L_Taiyo-Yuden_MD-5050
L3 L6 L8 L9 L10 | 5 | 12nH |  | Murata | LQW15AN12NJ00D | C82920 | 10000 | 1 | 10000 | 0.1495 | 0.02 | 0.02 | 1495.00 | 209.3 | N | Inductor | L_0402_1005Metric | Critical
L4 | 1 | 15nH |  | Murata | LQW15AN15NJ00D | C94079 | 10000 | 1 | 10000 | 0.1495 | 0.02 | 0.02 | 1495.00 | 209.3 | N | Inductor | L_0402_1005Metric | Critical
L7 | 1 | 18nH |  | Murata | LQW15AN18NJ00D | C82917 | 10000 | 1 | 10000 | 0.1495 | 0.02 | 0.02 | 1495.00 | 209.3 | N | Inductor | L_0402_1005Metric | Critical
L5 | 1 | 7.5nH |  | Murata | LQW15AN7N5G00D | C82918 | 10000 | 1 | 10000 | 0.1495 | 0.02 | 0.02 | 1495.00 | 209.3 | N | Inductor | L_0402_1005Metric | Critical
LED1 LED2 LED3 LED4 LED5 LED6 | 6 | WS2812B-3535 |  |  | SK6812/WS2812B-Mini | C114583 |  |  | 550 | 0.299 | 0.04 | 0.07 | 164.45 | 23.023 | Y | RGB LED with integrated controller | LED_SK6812MINI_PLCC4_3.5x3.5mm_P1.75mm_no_silk
Q4 Q5 | 2 | DMG2305UX-13 |  | Diodes Incorporated | DMG2305UX-13 | C144153 | 3000 | 1 | 3000 | 0.207 | 0.03 |  | 621.00 | 86.94 |  | MOSFET P-CH 20V 4.2A SOT23 | SOT-23-3
Q1 Q2 Q3 Q7 | 4 | MMBT3904-TP |  | Micro Commercial Co | MMBT3904-TP | C77991 | 3000 | 1 | 3000 | 0.0345 | 0.00483 |  | 103.50 | 14.49 |  | TRANS NPN 40V 0.2A SOT23 | SOT-23-3
Q6 | 1 | SSM3K376R |  | Toshiba | SSM3K376R | C113202 | 3000 | 1 | 3000 | 0.345 | 0.05 | 0.11 | 1035.00 | 144.9 | Y | MOSFET N-CH 30V 56mOhm @ 2A, 4.5V | SOT-23
R40 | 1 | 0R |  |  |  |  | 15000 | 1 | 15000 |  | 0.00 |  | 0.00 | 0 |  | +/- 1% | R_0402_1005Metric | Changed to 1% tolerance
R38 | 1 | 10R |  |  |  |  | 15000 | 1 | 15000 | 0.00184 | 0.0002576 |  | 27.60 | 3.864 |  | +/- 5% | R_0402_1005Metric
R1 R2 R3 R6 R7 R11 R12 R14 R15 R16 R19 R28 R29 R30 R31 R32 R37 | 17 | 10k |  |  |  |  | 15000 | 1 | 15000 | 0.00184 | 0.0002576 |  | 27.60 | 3.864 |  | +/- 10% | R_0402_1005Metric
R4 R5 R8 R9 R10 R13 R17 R34 R35 | 9 | 1k |  |  |  |  | 15000 | 1 | 15000 | 0.00184 | 0.0002576 |  | 27.60 | 3.864 |  | +/- 10% | R_0402_1005Metric
R33 | 1 | 3R |  |  |  |  | 15000 | 1 | 15000 | 0.00253 | 0.0003542 |  | 37.95 | 5.313 |  | +/- 1% | R_0402_1005Metric
R36 | 1 | 56k |  |  |  |  | 15000 | 1 | 15000 | 0.00184 | 0.0002576 |  | 27.60 | 3.864 |  | +/- 1% | R_0402_1005Metric
S6 | 1 | K1-5202UA-03 |  | Korean Hroparts | K1-5202UA-03 | C136710 |  |  | 550 | 1.38 | 0.19 | 0.28 | 759.00 | 106.26 | C | 5-position tactile switch | SW_JS1400BFQ-arrows | Zhejiang Jianfu cheaper?
S3 | 1 | K3-1296S-J1 |  | Korean Hroparts | K3-1296S-J1 | C223848 |  |  | 550 | 0.207 | 0.03 | 0.05 | 113.85 | 15.939 | Y |  | SW_SPDT_PCM12
S1 S2 S4 S5 S7 | 5 | DNP, top side |  | C&K | PTS645SM43SMTR92 LFS | C393947 |  |  | 550 |  | 0.00 |  | 0.00 | 0 | Y | SWITCH TACTILE SPST-NO 0.05A 12V | Switch_Tactile_SMD_6x6mm_PTS645 | Yellow possible? Pantone 1375C
U2 | 1 | AP2114H-3_3TRG1 |  | Diodes Inc. | AP2114H-3.3TRG1 | C150716 |  |  | 550 | 0.632 | 0.09 | 0.06 | 347.88 | 48.7025 | C | IC REG LINEAR 3.3V 1A SOT223 | SOT-223
U9 | 1 | CC1200 |  | Texas Instruments | CC1200 |  |  |  | 550 | 12.075 | 1.69 | 3.22 | 6641.25 | 929.775 | N | Low-Power, High-Performance RF Transceiver, QFN-32 | QFN-32-1EP_5x5mm_P0.5mm_EP3.45x3.45mm
U3 | 1 | CP2102N-A01-GQFN24 |  | Si Labs | CP2102N-A01-GQFN24 |  |  |  | 550 | 7.0725 | 0.99 | 1.25 | 3889.88 | 544.5825 | C | USB to UART master bridge, QFN-24 | QFN-24-1EP_4x4mm_P0.5mm_EP2.6x2.6mm
U10 | 1 | DRV2605LDGS |  | Texas Instruments | DRV2605LDGS |  |  |  | 550 | 14.375 | 2.01 | 1.65 | 7906.25 | 1106.875 | C | I2C haptic driver | VSSOP-10_3x3mm_P0.5mm | HQB source?
U5 | 1 | GDEH029A1 |  | Good Display | GDEH029A1 |  |  |  | 550 | 55.2 | 7.73 | 6.00 | 30360.00 | 4250.4 | N | 2.9” e-paper display |  | Jeff source – HQB seller or factory?
U6 | 1 | IQS550 |  | Azoteq | IQS550-BL-QNR |  |  |  | 550 | 13.8 | 1.93 | 1.12 | 7590.00 | 1062.6 | N | Capacitive touch controller | QFN-48-1EP_7x7mm_P0.5mm_EP5.45x5.45mm | Jeff source – HQB supplier selected
U1 | 1 | MCP73831T-2ACI_OT |  | Microchip Semi | MCP73831T-3ACI/OT | C14879 |  |  | 550 | 3.22 | 0.45 | 0.34 | 1771.00 | 247.94 | Y | IC CONTROLLR LI-ION 4.2V SOT23-5 | SOT-753 | Is there a Chinese version?
U4 | 1 | PCA9555 |  | Texas Instruments | PCA9555PW,112 |  |  |  | 550 | 3.0475 | 0.43 | 0.98 | 1676.12 | 234.6575 | C | I2C IO Expander, with internal pull-ups | TSSOP-24_4.4x7.8mm_P0.65mm | Is there a Chinese version?
U8 | 1 | PCM5100A |  | Texas Instruments | PCM5100APWR | C131154 |  |  | 550 | 3.5995 | 0.50 | 0.54 | 1979.72 | 277.1615 | C | 2VRMS DirectPath, 100dB Audio Stereo DAC with 32-bit, 384kHz PCM Interface, TSSOP-20 | TSSOP-20_4.4x6.5mm_P0.65mm
Y1 | 1 | 32.768kHz |  | Seiko Epson | Q13FC1350000200 | C48615 |  |  | 550 | 0.69 | 0.10 | 0.10 | 379.50 | 53.13 | C | 32.768kHz, 7pF | Crystal_SMD_3215-2Pin_3.2x1.5mm
Y2 | 1 | 40Mhz |  | Seiko Epson | X1E000021017700 | C255943 |  |  | 550 | 0.69 | 0.10 | 0.12 | 379.50 | 53.13 | C | 40Mhz, 10ppm, 10ppm, 7pF, 40ohm | Crystal_SMD_3225-4Pin_3.2x2.5mm | Critical
 |  |  |  |  |  |  |  |  | 550 |  | 0.00 |  | 0.00 | 0
Linear Resonant Actuator | 1 | DNP, user supplied |  | Ineed Youngsun Technology Co., Ltd. | C0832BE03L15 |  |  |  | 550 | 4.14 | 0.58 | 1.30 | 2277.00 | 318.78 | C | Linear Resonant Actuator Ø8x3.2T, 235Hz, 1.8Vrms AC |  | Sample check required
Batt | 1 | DNP, user supplied |  | Blue Taiyang | LP375080 |  |  |  | 550 | 17.94 | 2.51 | 3.10 | 9867.00 | 1381.38 | C | 1500mAh Lipo with Molex 510210200, 50mm wire length |  | Jeff source
Earbuds | 1 | DNP, user supplied |  |  |  |  |  |  | 550 |  | 0.00 | 1.00 | 0.00 | 0
USB-C cable | 1 | DNP, user supplied |  | San Guan Siyuan |  |  |  |  | 550 |  | 0.00 | 0.60 | 0.00 | 0 |  | Custom, 0.75m |  | Yellow possible? Pantone 1375C
Inkjet printing | 1 |  |  |  |  |  |  |  | 550 |  | 0.00 |  | 0.00 | 0
Laser cut coverlay | 1 |  |  | SZ Chong Ming | tr20-coverlay |  | 600 | 1 | 600 | 5.000 | 0.70 |  | 3000.00 | 420
PCB Assembly | 1 |  |  |  |  |  |  |  | 550 | 12.035 | 1.68 |  | 6619.00 | 926.66
PCB Fabrication | 1 |  |  |  |  |  |  |  | 550 | 100.000 | 14.00 |  | 55000.00 | 7700
 |  |  |  |  |  |  |  |  |  |  |  | Total | 170625.425 | 23887.5595
 |  |  |  |  |  |  |  |  |  |  |  | Unit | 310.23 | 43.43
Total parts | 178
 |  |  |  |  |  |  |  |  |  |  |  |  |  |  | Y | Substitution OK
 |  |  |  |  |  |  |  |  | Exchange | 0.14 |  |  |  |  | C | Check before substituting
 |  |  |  |  |  |  |  |  |  |  |  |  |  |  | N | Do not substitute
 |  |  |  |  |  |  |  |  |  |  |  |  |  |  | 550 | Units to build
Attention Allnet
Attention Jeff
Custom colour specification
