jeffmakes/tr20-badge-hw/r1/bom/tr20_materials price.xlsx

Designator | Qty | Value | Manufacturer | Part number | LCSC | Digikey | Price USD | Line price | Substitute | Description | Notes / TODO | Footprint
PCB Assembly | 1 |  |  |  |  |  | 15.000 | 15.00 |  | Two side SMD placement, one THT part (J7) | Placeholder guess
PCB Fabrication | 1 |  |  |  |  |  | 5.000 | 5.00 |  | 4 layer, 1.6mm, 110x150mm, custom legend/resist colour? | Placeholder guess
Earbuds | 1 |  |  |  |  |  | 1.000 | 1.00
USB-C cable | 1 |  |  |  |  |  | 0.600 | 0.60 |  | Custom, 0.75m
DISP1 | 1 | GDEH029A1 | Good Display | GDEH029A1 |  |  | 6.000 | 6.00 | N |  | Negotiate price?
A1, | 1 | ESP32-WROVER-I | Espressif | ESP32-WROVER-I |  |  | 4.200 | 4.20 |  |  | Sponsored part? | jeffmakes-footprints:ESP32-WROVER-I
Batt | 1 | 1500mAh | Blue Taiyang | LP375080 |  |  | 3.100 | 3.10 | C |  | Check supply / substitute?
U9, | 1 | CC1200 | Texas Instuments | CC1200 |  |  | 3.220 | 3.22 | N | Low-Power, High-Performance RF Transceiver, QFN-32 |  | Package_DFN_QFN:QFN-32-1EP_5x5mm_P0.5mm_EP3.45x3.45mm
LRA1 | 1 |  |  |  |  |  | 2.000 | 2.00 |  | Linear Resonant Actuator | Find a supplier, decide mounting and connector
U10, | 1 | DRV2605LDGS | Texas Instuments | DRV2605LDGS |  | 296-40032-1-ND | 1.650 | 1.65 | N |  |  | Package_SO:VSSOP-10_3x3mm_P0.5mm
U6, | 1 | IQS550 | Azoteq | IQS550-BL-QNR |  | 1790-1046-1-ND | 1.560 | 1.56 | N |  |  | Package_DFN_QFN:QFN-48-1EP_7x7mm_P0.5mm_EP5.45x5.45mm
U3, | 1 | CP2102N-A01-GQFN24 | Si Labs | CP2102N-A01-GQFN24 |  | 336-4737-1-ND | 1.250 | 1.25 | C | USB to UART master bridge, QFN-24 | Is QFN20 variant cheaper? | Package_DFN_QFN:QFN-24-1EP_4x4mm_P0.5mm_EP2.6x2.6mm
U4, | 1 | PCA9555 | Texas Instuments | PCA9555PW |  | 568-3986-5-ND | 0.980 | 0.98 | C | I2C IO Expander, with internal pull-ups |  | Package_SO:TSSOP-24_4.4x7.8mm_P0.65mm
U8, | 1 | PCM5100A | Texas Instuments | PCM5100APW | C131154 |  | 0.540 | 0.54 | C | 2VRMS DirectPath, 100dB Audio Stereo DAC with 32-bit, 384kHz PCM Interface, TSSOP-20 |  | Package_SO:TSSOP-20_4.4x6.5mm_P0.65mm
D11, D12, D14, D15, D16, D13, | 6 | WS2812B-3535 |  | WS2812B-Mini / SK6812 | C114583 |  | 0.068 | 0.41 | Y | RGB LED with integrated controller | Substitute SK6812? | jeffmakes-footprints:LED_SK6812MINI_PLCC4_3.5x3.5mm_P1.75mm_no_silk
D3, D10, D9, D8, | 4 | SS13FL | On Semi |  |  |  | 0.090 | 0.36 | C | Schottky 30V 1A |  | Diode_SMD:D_SOD-123F
U1, | 1 | MCP73831T-2ACI_OT | Microchip Semi | MCP73831T-3ACI/OT | C14879 | MCP73831T-3ACI/OTCT-ND | 0.340 | 0.34 | Y | IC CONTROLLR LI-ION 4.2V SOT23-5 | Consider Chinese equivalent | digikey-footprints:SOT-753
S6, | 1 | K1-5202UA-03 | Korean Hroparts | K1-5202UA-03 | C145899 |  | 0.277 | 0.28 | C | 5-position tactile switch | Zhejiang Jianfu cheaper? | jeffmakes-footprints:SW_JS1400BFQ-arrows
Y2, | 1 | 40MHz | Seiko Epson | X1E000021017700 | C255943 |  | 0.120 | 0.12 | C | 40Mhz, 10ppm, 10ppm, 7pF, 40ohm |  | Crystal:Crystal_SMD_3225-4Pin_3.2x2.5mm
Q6, | 1 | SSM3K376R | Toshiba | SSM3K376R |  |  | 0.110 | 0.11 | Y | MOSFET N-CH 30V 56mOhm @ 2A, 4.5V |  | Package_TO_SOT_SMD:SOT-23
J1, | 1 | S2B-PH-SM4-TB | JST | S2B-PH-SM4-TB |  |  | 0.100 | 0.10 | Y | Battery connector |  | Connector_JST:JST_PH_S2B-PH-SM4-TB_1x02-1MP_P2.00mm_Horizontal
U5, | 1 | 8.02a0.024200 | Dianwei | 8.02A0.024200 |  |  | 0.150 | 0.15 | Y | Display connector – FFC, 24 pos, 0.5mm pitch | FPC0.5-XP | jeffmakes-footprints:GDEH029A1
Y1, | 1 | 32.768kHz | Seiko Epson | Q13FC1350000200 | C48615 |  | 0.095 | 0.10 | C | 32.768kHz, 7pF |  | Crystal:Crystal_SMD_3215-2Pin_3.2x1.5mm
L3, L6, L8, L9, | 4 | 12nH | Murata | LQW15AN12NJ00D |  |  | 0.020 | 0.08 | N | Inductor |  | Inductor_SMD:L_0402_1005Metric
U2, | 1 | AP2114H-3_3TRG1 | Diodes Inc. | AP2114H | C150716 |  | 0.060 | 0.06 | C | IC REG LINEAR 3.3V 1A SOT223 |  | digikey-footprints:SOT-223
J10, | 1 | PJ-320D | Korean Hroparts | PJ-320D | C95562 |  | 0.050 | 0.05 | C | Audio Jack, 3.5mm SMD |  | Connector_Audio:Jack_3.5mm_PJ320D_Horizontal
L1, | 1 | 10uH 1A | SXN | SMNR5020-100MT | C135285 |  | 0.050 | 0.05 | Y | 10uH, 1A, 5x5x2mm |  | Inductor_SMD:L_Taiyo-Yuden_MD-5050
S2, S1, S4, S5, S7, | 5 |  |  |  |  |  | 0.010 | 0.05 | Y | SWITCH TACTILE 6x6 SMD | Yellow actuator desired | digikey-footprints:Switch_Tactile_SMD_6x6mm_PTS645 6*6*4.3 black
S3, | 1 |  | Korean Hroparts | K3-1296S-E1 | C128955 |  | 0.050 | 0.05 | Y | SWITCH SLIDE SMD |  | jeffmakes-footprints:SW_JS102011SAQN
J7, | 1 |  | Connfly | DS1023-2*2SF11 | C92273 |  | 0.034 | 0.03 | Y | 2x2 2.54mm pitch female pin socket |  | jeffmakes-footprints:PinSocket_2x02_P2.54mm_Vertical_mirror_numbering
L2, | 1 | 10nH | Murata | LQW15AN10NJ00D |  |  | 0.020 | 0.02 | N | Inductor |  | Inductor_SMD:L_0402_1005Metric
L4, | 1 | 15nH | Murata | LQW15AN15NJ00D |  |  | 0.020 | 0.02 | N | Inductor |  | Inductor_SMD:L_0402_1005Metric
L5, | 1 | 7.5nH | Murata | LQW15AN7N5G00D |  |  | 0.020 | 0.02 | N | Inductor |  | Inductor_SMD:L_0402_1005Metric
L7, | 1 | 18nH | Murata | LQW15AN18NJ00D |  |  | 0.020 | 0.02 | N | Inductor |  | Inductor_SMD:L_0402_1005Metric
Q1, Q2, Q3, Q7, | 4 | MMBT3904-TP | generic | MMBT3904 | C181119 |  | 0.004 | 0.02 | Y | TRANS NPN 40V 0.2A SOT23 |  | digikey-footprints:SOT-23-3
J2, | 1 | USB-C-12 | Korean Hroparts | TYPE-C-31-M-17 | C283540 |  | 0.012 | 0.01 | C | USB-C connector, 12 pin |  | jeffmakes-footprints:jing-usb-c-lcsc-C167321
Q4, Q5, | 2 | DMG2305UX-13 | Diodes Inc. | DMG2305UX-13 | C144153 |  | 0.004 | 0.01 | C | MOSFET P-CH 20V 4.2A SOT23 |  | digikey-footprints:SOT-23-3
C4, C12, | 2 | 22uF （10V） |  |  |  |  |  | 0.00 |  |  |  | Capacitor_SMD:C_0603_1608Metric
C5, C3, C11, C25, C27, C28, C29, C30, C26, C34, C31, C42, C41, | 13 | 100nF |  |  |  |  |  | 0.00 |  |  |  | Capacitor_SMD:C_0603_1608Metric
C13, C14, | 2 | 4.7uF 50V |  |  |  |  |  | 0.00 |  |  | 50V Critical | Capacitor_SMD:C_0805_2012Metric
C7, C9, C6, C8, C10, C33, C36, C44, C43, C40, C39, C74, C73, C16, C17, C18, C19, C20, C21, C22, C23, C24, C15, | 23 | 1uF 50V |  |  |  |  |  | 0.00 |  | X5R, 1uF, 50V, -10%/+10% | 50V Critical | Capacitor_SMD:C_0603_1608Metric
C47, | 1 | 1.5nF |  |  |  |  |  | 0.00 |  | U2J, 1.5nF, 10V, -5%/+5% X7R（no U2J） | Critical | Capacitor_SMD:C_0402_1005Metric
C32, C35, C49, | 3 | 100pF |  |  |  |  |  | 0.00 |  | C0G/NP0, 100pF, 50V, -5%/+5% | Critical | Capacitor_SMD:C_0402_1005Metric
C50, | 1 | 33pF |  |  |  |  |  | 0.00 |  | C0G/NP0, 33pF, 50V, -5%/+5% | Critical | Capacitor_SMD:C_0402_1005Metric
C51, C53, C56, C58, C62, C65, C67, C69, C71, C59, C63, | 11 | 47nF |  |  |  |  |  | 0.00 |  | X5R, 47nF, 25V, -10%/+10% | Critical | Capacitor_SMD:C_0402_1005Metric
C1, C2, C52, C45, C46, | 5 | 15pF |  |  |  |  |  | 0.00 |  | C0G/NP0, 15pF, 50V, -5%/+5% | Critical | Capacitor_SMD:C_0402_1005Metric
C54, C60, | 2 | 3.3pF |  |  |  |  |  | 0.00 |  | C0G/NP0, 3.3pF, 50V, -0.25pF/+0.25pF | Critical | Capacitor_SMD:C_0402_1005Metric
C55, C72, | 2 | 1pF |  |  |  |  |  | 0.00 |  | C0G/NP0, 1pF, 50V, -0.1pF/+0.1pF | Critical | Capacitor_SMD:C_0402_1005Metric
C57, | 1 | 2.2pF |  |  |  |  |  | 0.00 |  | C0G/NP0, 2.2pF, 50V, -0.25pF/+0.25pF | Critical | Capacitor_SMD:C_0402_1005Metric
C61, | 1 | 3pF |  |  |  |  |  | 0.00 |  | C0G/NP0, 3pF, 50V, -0.25pF/+0.25pF | Critical | Capacitor_SMD:C_0402_1005Metric
C64, C70, | 2 | DNP |  |  |  |  |  | 0.00 |  |  |  | Capacitor_SMD:C_0402_1005Metric
C66, C48, | 2 | 10nF |  |  |  |  |  | 0.00 |  | X7R, 10nF, 25V, -10%/+10% |  | Capacitor_SMD:C_0402_1005Metric
C68, | 1 | 220nF |  |  |  |  |  | 0.00 |  | X5R, 220nF, 10V, -15%/+15% |  | Capacitor_SMD:C_0402_1005Metric
D1, | 1 | LTST-C150KGKT |  |  |  |  |  | 0.00 | Y | LED GREEN CLEAR 1206 SMD |  | digikey-footprints:1206
D2, | 1 | LTST-C150KFKT |  |  |  |  |  | 0.00 | Y | LED YELLOW CLEAR 1206 SMD |  | digikey-footprints:1206
D4, | 1 | LTST-C150KSKT |  |  |  |  |  | 0.00 | Y | LED YELLOW CLEAR 1206 SMD |  | digikey-footprints:1206
D5, D6, D7, D17, D18, D19, D21, D20, | 8 | ESD5Z6.0T5G |  |  |  |  |  | 0.00 | Y | Bidirectional transient-voltage-suppression diode |  | jeffmakes-footprints:SOD-523-numbered-pads
J3, | 1 | UJ2-AH-1-SMT | Jing |  | C46400 |  | 0.025 | 0.03 | C | USB-A connector SMD | Low stock at LCSC | jeffmakes-footprints:jing-lcsc-C46400
J4, | 1 | TF-15x15 | SOFNG |  | C111196 |  | 0.092 | 0.09 | C | MicroSD connector, ejector |  | jeffmakes-footprints:microSD_HC_Sofng_TF-15
J6, | 1 | DNP |  |  |  |  |  | 0.00
J8, | 1 | DNP |  |  |  |  |  | 0.00 |  | SMA coax connector |  | digikey-footprints:RF_SMA_Receptical_Vertical_CONSMA001-SMD-G
J9, | 1 | Conn_01x02 |  |  |  |  |  | 0.00 |  |  | TODO: connector to mate with LRA
R4, R5, R9, R10, R8, R13, R17, R35, R34, | 9 | 1k |  |  |  |  |  | 0.00 |  | +/- 10% |  | Resistor_SMD:R_0603_1608Metric
R7, R1, R2, R3, R6, R11, R12, R14, R15, R16, R19, R30, R29, R28, R31, R32, R37, | 17 | 10k |  |  |  |  |  | 0.00 |  | +/- 10% |  | Resistor_SMD:R_0603_1608Metric
R33, | 1 | 3R |  |  |  |  |  | 0.00 |  | +/- 5% |  | Resistor_SMD:R_0603_1608Metric
R36, | 1 | 56k |  |  |  |  |  | 0.00 |  | +/- 1% |  | Resistor_SMD:R_0402_1005Metric
R38, | 1 | 10R |  |  |  |  |  | 0.00 |  | +/- 5% |  | Resistor_SMD:R_0402_1005Metric
R39, | 1 | DNP |  |  |  |  |  | 0.00 |  | +/- 10% |  | Resistor_SMD:R_0402_1005Metric
R40, | 1 | 0R |  |  |  |  |  | 0.00 |  | +/- 10% |  | Resistor_SMD:R_0402_1005Metric
Total parts | 175 |  |  |  |  |  | Total USD | 48.66
 |  |  |  |  |  |  |  |  | Y | Substitution desired
 |  |  |  |  |  |  |  |  | C | Check before substituting
 |  |  |  |  |  |  |  |  | N | Do not substitute
Mark：Green FPC0.5-XP
