jeffmakes/tr20-badge-hw/r2/build/tr20-r2-bom/tr20-r2-alternative-sources.xlsx

References | Quantity / PCB | Value | Manufacturer | MPN | Digikey | Mouser | TME | LCSC equiv. | Reel | Reels | Qty to buy | Qty required | Surplus | Unit GBP | Line GBP | Description | Package | Notes | Sourcing Notes
A1 | 1 | ESP32- WROVER- B(M213DH2864 PC3Q0) | Espressif | ESP32- WROVER- B(M213DH2864 PC3Q0) |  |  |  | C129145 |  |  | 550 | 550 | 0 | 4.20000 | 2310 |  | ESP32-WROVER |  | 16Mb flash part maybe not available. Decision needed. General good availability, though
C47 | 1 | 1.5nF | Murata | GRM1557U1A152JA01D | 490-10690-6-ND |  |  | C162143 | 600 | 1 | 600 | 550 | 50 | 0.15000 | 90 | U2J, 1.5nF, 10V, -5%/+5% | C_0402_1005Metric | Critical – U2J, UJ, C0G only
C3 C5 C11 C25 C26 C27 C28 C29 C30 C31 C34 C38 C41 C42 C75 C77 | 16 | 100nF | Samsung | CL05B104KO5NNNC | 1276-1001-2-ND |  |  |  | 10000 | 1 | 10000 | 8800 | 1200 | 0.00335 | 33.5 |  | C_0402_1005Metric
C32 C35 C49 | 3 | 100pF | Murata | GRM1555C1H101JA01D | 490-5922-2-ND |  |  |  | 10000 | 1 | 10000 | 1650 | 8350 | 0.00448 | 44.8 | C0G/NP0, 100pF, 50V, -5%/+5% | C_0402_1005Metric | Critical
C48 C66 | 2 | 10nF | Murata | GRM155R71E103KA01D | 490-1312-2-ND |  |  |  | 10000 | 1 | 10000 | 1100 | 8900 | 0.00274 | 27.4 | X7R, 10nF, 25V, -10%/+10% | C_0402_1005Metric
C1 C2 C45 C46 C52 | 5 | 15pF | Murata | GRM1555C1H150JA01D | 490-5888-2-ND |  |  |  | 10000 | 1 | 10000 | 2750 | 7250 | 0.00449 | 44.9 | C0G/NP0, 15pF, 50V, -5%/+5% | C_0402_1005Metric | Critical
C55 C72 | 2 | 1pF | Murata | GRM1555C1H1R0BA01D | 490-6206-2-ND |  |  |  | 10000 | 1 | 10000 | 1100 | 8900 | 0.00706 | 70.6 | C0G/NP0, 1pF, 50V, -0.1pF/+0.1pF | C_0402_1005Metric | Critical
C6 C7 C8 C9 C10 C15 C16 C17 C18 C19 C20 C21 C22 C23 C24 C33 C36 C39 C40 C43 C44 C73 C74 C76 C78 C79 C80 C81 C82 C83 C84 C85 C86 C87 | 34 | 1uF | Samsung | CL10A105KB8NNNC | 1276-1860-2-ND |  |  |  | 4000 | 5 | 20000 | 18700 | 1300 | 0.01648 | 329.6 | X5R, 1uF, 50V, -10%/+10% | C_0603_1608Metric | 50V Critical
C57 | 1 | 2.2pF | Murata | GRM1555C1H2R2CA01D | 490-5932-2-ND |  |  |  | 10000 | 1 | 10000 | 550 | 9450 | 0.00448 | 44.8 | C0G/NP0, 2.2pF, 50V, -0.25pF/+0.25pF | C_0402_1005Metric | Critical
C68 | 1 | 220nF | Samsung | CL05A224KP5NNNC | 1276-1049-2-ND |  |  |  | 10000 | 1 | 10000 | 550 | 9450 | 0.00874 | 87.4 | X5R, 220nF, 10V, -15%/+15% | C_0402_1005Metric
C4 C12 | 2 | 22uF | Samsung | CL10A226MP8NUNE | 1276-1274-2-ND |  |  |  | 3000 | 1 | 3000 | 1100 | 1900 | 0.13534 | 406.02 | X5R, 22uF,10V, 0603, -20%/+20% | C_0603_1608Metric
C54 C60 | 2 | 3.3pF | Murata | GRM1555C1H3R3WA01D | 490-7757-2-ND |  |  |  | 10000 | 1 | 10000 | 1100 | 8900 | 0.01222 | 122.2 | C0G/NP0, 3.3pF, 50V, -0.25pF/+0.25pF | C_0402_1005Metric | Critical
C50 | 1 | 33pF | Murata | GRM1555C1H330JA01D | 490-5936-2-ND |  |  |  | 10000 | 1 | 10000 | 550 | 9450 | 0.00446 | 44.6 | C0G/NP0, 33pF, 50V, -5%/+5% | C_0402_1005Metric | Critical
C61 | 1 | 3pF | Murata | GRM1555C1H3R0BA01D | 490-6237-2-ND |  |  |  | 10000 | 1 | 10000 | 550 | 9450 | 0.00706 | 70.6 | C0G/NP0, 3pF, 50V, -0.25pF/+0.25pF | C_0402_1005Metric | Critical
C13 C14 | 2 | 4.7uF | Samsung | CL21A475KBQNNNE | 1276-1248-2-ND |  |  |  | 2000 | 1 | 2000 | 1100 | 900 | 0.07478 | 149.56 | X5R, 4.7uF, 50V, 0805, -10%/+10% | C_0805_2012Metric | 50V Critical
C51 C53 C56 C58 C59 C62 C63 C65 C67 C69 C71 | 11 | 47nF | Murata | GRM155R71E473KA88D | 490-3254-2-ND |  |  |  | 10000 | 1 | 10000 | 6050 | 3950 | 0.00802 | 80.2 | X5R, 47nF, 25V, -10%/+10% | C_0402_1005Metric | Critical
D5 D6 D7 D11 D12 D17 D18 D19 D20 D21 | 10 | ESD5Z6.0T5G | On Semi | ESD5Z6.0T5G | ESD5Z6.0T5GOSTR-ND |  |  | C261278 | 8000 | 1 | 8000 | 5500 | 2500 | 0.02521 | 201.68 | Bidirectional transient-voltage-suppression diode 6V | SOD-523-numbered-pads
D1 | 1 | Green | Lite-On Inc. | LTST-C150KGKT | 160-1404-6-ND |  |  | C99881 | 600 | 1 | 600 | 550 | 50 | 0.07223 | 43.338 | LED GREEN CLEAR 1206 SMD | 1206 |  | Low stock, Digi-Reel
D2 | 1 | Orange | Lite-On Inc. | LTST-C150KSKT | 160-1406-6-ND |  |  | C130716 | 3000 | 1 | 600 | 550 | 50 | 0.07223 | 43.338 | LED ORANGE CLEAR 1206 SMD | 1206 |  | Digi-Reel
D3 D8 D9 D10 | 4 | SS13FL | On Semi. | SS13FL | SS13FLTR-ND |  |  | C190475 | 3000 | 1 | 3000 | 2200 | 800 | 0.04779 | 143.37 | Schottky diode 30V, 1A, 500ns | D_SOD-123F
D4 | 1 | Yellow | Lite-On Inc. | LTST-C150KSKT | 160-1406-6-ND |  |  | C93094 | 3000 | 1 | 600 | 550 | 50 | 0.07223 | 43.338 | LED YELLOW CLEAR 1206 SMD | 1206 |  | Digi-Reel
J7 | 1 | HLE-103-02-L-DV-BE-K-TR | Samtec | HLE-103-02-L-DV-BE-K-TR | SAM13984DKR-ND |  |  | C92272 | 570 | 1 | 570 | 550 | 20 | 1.51670 | 864.519 |  | PinSocket_2x03_P2.54mm_Vertical
J1 J9 | 2 | 532610271 | Molex | 532610271 |  | 538-53261-0271 |  | C132528 | 1200 | 1 | 1200 | 1100 | 100 | 0.18600 | 223.2 |  | Molex_PicoBlade_53261-0271_1x02-1MP_P1.25mm_Horizontal |  | MouseReel
J5 | 1 | SFV24R-2STE1HLF | Amphenol | SFV24R-2STE1HLF | 609-4321-6-ND |  |  | C262643 | 600 | 1 | 600 | 550 | 50 | 0.49000 | 294 | FFC connector, top contact, 24pos, 0.5mm pitch | AFC07x24-1MP_P0.5mm_Horizontal
J10 | 1 | SJ2-3574A-SMT-TR | CUI Devices | SJ2-3574A-SMT-TR | CP-SJ2-3574A-SMT-DKR-ND |  |  | C431535 | 570 | 1 | 570 | 550 | 20 | 0.55352 | 315.5064 | Audio Jack, 3.5mm SMD | Jack_3.5mm_PJ320D_Horizontal
J4 | 1 | 112J-TDAR-R01 | Attend | 112J-TDAR-R01 |  |  | MCC-SDMICRO/3 | C111196 | 1000 | 1 | 1000 | 550 | 450 | 0.57000 | 570 | MicroSD connector, ejector | microSD_HC_Sofng_TF-15
J3 | 1 | 629104190121 | Würth Elektronik | 629104190121 | 732-11179-6-ND |  |  | C283549 | 570 | 1 | 570 | 550 | 20 | 0.77619 | 442.4283 | USB-A connector SMD | jing-lcsc-C46400
J2 | 1 | DX07S016JA1R1500 | JAE | DX07S016JA1R1500 |  | 656-DX07S016JA1R1500 |  | C283540 | 570 | 1 | 570 | 550 | 20 | 0.75900 | 432.63 | USB-C connector, 12 pin | jing-usb-c-lcsc-C167321
L2 | 1 | 10nH | Murata | LQW15AN10NJ00D | 490-1146-6-ND |  |  | C184029 | 600 | 1 | 600 | 550 | 50 | 0.07340 | 44.04 | Inductor | L_0402_1005Metric | Critical | Digi-Reel
L1 | 1 | 10uH 1A | Taiyo Yuden | NRS4018T100MDGJ | 587-2886-6-ND |  |  | C135285 | 570 | 1 | 570 | 550 | 20 | 0.12495 | 71.2215 | 10uH, 1A, 5x5x2mm | L_Taiyo-Yuden_MD-5050
L3 L6 L8 L9 L10 | 5 | 12nH | Murata | LQW15AN12NJ00D | 490-1147-6-ND |  |  | C82920 | 3000 | 1 | 3000 | 2750 | 250 | 0.04894 | 146.82 | Inductor | L_0402_1005Metric | Critical | Digi-Reel
L4 | 1 | 15nH | Murata | LQW15AN15NJ00D | 490-1148-6-ND |  |  | C94079 | 600 | 1 | 600 | 550 | 50 | 0.07340 | 44.04 | Inductor | L_0402_1005Metric | Critical | Digi-Reel
L7 | 1 | 18nH | Murata | LQW15AN18NJ00D | 490-1149-6-ND |  |  | C82917 | 600 | 1 | 600 | 550 | 50 | 0.07340 | 44.04 | Inductor | L_0402_1005Metric | Critical | Digi-Reel
L5 | 1 | 7.5nH | Murata | LQW15AN7N5G00D | 490-6846-6-ND |  |  | C82918 | 600 | 1 | 600 | 550 | 50 | 0.07998 | 47.988 | Inductor | L_0402_1005Metric | Critical
LED1 LED2 LED3 LED4 LED5 LED6 | 6 | WS2812B-3535 |  | SK6812/WS2812B-Mini |  |  | WS2812B-MINI | C114583 | 900 | 4 | 3600 | 3300 | 300 | 0.09830 | 353.88 | RGB LED with integrated controller | LED_SK6812MINI_PLCC4_3.5x3.5mm_P1.75mm_no_silk |  | Hard to fiind, no stock at TME, only hobby products at Digikey, Mouser (Adafruit, Sparkfun, etc)
Q4 Q5 | 2 | DMG2305UX-13 | Diodes Incorporated | DMG2305UX-13 | DMG2305UX-13DIDKR-ND |  |  | C144153 | 1200 | 1 | 1200 | 1100 | 100 | 0.06067 | 72.804 | MOSFET P-CH 20V 4.2A SOT23 | SOT-23-3 |  | Digi-Reel
Q1 Q2 Q3 Q7 | 4 | MMBT3904-TP | Micro Commercial Co | MMBT3904-TP | MMBT3904TPMSTR-ND |  |  | C77991 | 3000 | 1 | 3000 | 2200 | 800 | 0.01801 | 54.03 | TRANS NPN 40V 0.2A SOT23 | SOT-23-3
Q6 | 1 | SSM3K376R | Toshiba | SSM3K376R | SSM3K376RLFDKR-ND |  |  | C113202 | 570 | 1 | 570 | 550 | 20 | 0.10060 | 57.342 | MOSFET N-CH 30V 56mOhm @ 2A, 4.5V | SOT-23
R40 | 1 | 0R | Yageo | RC0402FR-070RL | 311-0.0LRTR-ND |  |  |  | 10000 | 1 | 10000 | 550 | 9450 | 0.00102 | 10.2 | +/- 1% | R_0402_1005Metric
R38 | 1 | 10R | Yageo | RC0402FR-0710RL | 311-10.0LRTR-ND |  |  |  | 10000 | 1 | 10000 | 550 | 9450 | 0.00188 | 18.8 | +/- 5% | R_0402_1005Metric
R1 R2 R3 R6 R7 R11 R12 R14 R15 R16 R19 R28 R29 R30 R31 R32 R37 | 17 | 10k | Yageo | RC0402FR-0710KL | 311-10.0KLRTR-ND |  |  |  | 10000 | 1 | 10000 | 9350 | 650 | 0.00125 | 12.5 | +/- 10% | R_0402_1005Metric
R4 R5 R8 R9 R10 R13 R17 R35 | 8 | 1k | Yageo | RC0402FR-071KL | 311-1.00KLRTR-ND |  |  |  | 10000 | 1 | 10000 | 4400 | 5600 | 0.00125 | 12.5 | +/- 10% | R_0402_1005Metric
R33 | 1 | 3R | Yageo | RC0402FR-073RL | RC0402FR-073RL-ND |  |  |  | 10000 | 1 | 10000 | 550 | 9450 | 0.00188 | 18.8 | +/- 1% | R_0402_1005Metric
R18 R20 | 2 | 5.1k | Yageo | RC0402JR-075K1L |  | 603-RC0402JR-075K1L |  |  | 10000 | 1 | 10000 | 1100 | 8900 | 0.00200 | 20 | +/- 5% | R_0402_1005Metric |  | Already in hand | R_0402_1005Metric
R36 | 1 | 56k | Yageo | RC0402FR-0756KL | 311-56.0KLRTR-ND |  |  |  | 10000 | 1 | 10000 | 550 | 9450 | 0.00125 | 12.5 | +/- 1% | R_0402_1005Metric
S6 | 1 | JS1400BFQ | NINIGI | MICRO-JOY-A | EG5858-ND |  | MICRO-JOY-A | C136710 | 570 | 1 | 570 | 550 | 20 | 0.68000 | 387.6 | 5-position tactile switch | SW_JS1400BFQ-arrows |  | Unknown packaging
S3 | 1 | CUS-12TB | Nidec Copal | CUS-12TB | 563-1102-6-ND |  |  | C223848 | 570 | 1 | 570 | 550 | 20 | 0.36467 | 207.8619 | Slide switch, SPDT | SW_SPDT_PCM12 |  | Digi-Reel
S1 S2 S4 S5 S7 | 5 | 6x6mm tact swich | C&K | PTS645SM50SMTR92 LFS | CKN10889TR-ND |  |  | C393947 | 1000 | 3 | 3000 | 2750 | 250 | 0.10728 | 321.84 | SWITCH TACTILE SPST-NO 0.05A 12V | Switch_Tactile_SMD_6x6mm_PTS645
U2 | 1 | AP2114H-3_3TRG1 | Diodes Inc. | AP2114H-3.3TRG1 | AP2114H-3.3TRG1DIDKR-ND |  |  | C150716 | 570 | 1 | 570 | 550 | 20 | 0.11363 | 64.7691 | IC REG LINEAR 3.3V 1A SOT223 | SOT-223 |  | Digi-Reel
U9 | 1 | CC1200 | Texas Instruments | CC1200RHBR | 296-38892-6-ND |  |  |  | 570 | 1 | 570 | 550 | 20 | 2.46846 | 1407.0222 | Low-Power, High-Performance RF Transceiver, QFN-32 | QFN-32-1EP_5x5mm_P0.5mm_EP3.45x3.45mm |  | Digi-Reel
U3 | 1 | CP2102N-A02-GQFN24R | Si Labs | CP2102N-A02-GQFN24R | 336-5888-6-ND |  |  |  | 570 | 1 | 570 | 550 | 20 | 0.96609 | 550.6713 | USB to UART master bridge, QFN-24 | QFN-24-1EP_4x4mm_P0.5mm_EP2.6x2.6mm |  | Digi-Reel
U10 | 1 | DRV2605LDGS | Texas Instruments | DRV2605LDGSR | 296-40032-6-ND |  |  |  | 570 | 1 | 570 | 550 | 20 | 1.27058 | 724.2306 | I2C haptic driver | VSSOP-10_3x3mm_P0.5mm |  | Digi-Reel
U5 | 1 | GDEH029A1 | Good Display | GDEH029A1 |  |  |  |  | 560 | 1 | 560 | 550 | 10 | 6.00000 | 3360 | 2.9” e-paper display |  |  | Unlikely that these exist outside China
U6 | 1 | IQS550 | Azoteq | IQS550-BL-QNR |  |  |  |  | 570 | 1 | 570 | 550 | 20 | 0.00000 | 0 | Capacitive touch controller | QFN-48-1EP_7x7mm_P0.5mm_EP5.45x5.45mm |  | Already in hand
U1 | 1 | MCP73831T-2ACI_OT | Microchip Semi | MCP73831T-3ACI/OT | MCP73831T-3ACI/OTDKR-ND |  |  | C14879 | 570 | 1 | 570 | 550 | 20 | 0.32870 | 187.359 | IC CONTROLLR LI-ION 4.2V SOT23-5 | SOT-753 |  | Digi-Reel
U7 | 1 | PAM8908 | Diodes, Inc. | PAM8908JER |  | 621-PAM8908JER |  |  | 570 | 1 | 570 | 550 | 20 | 0.35600 | 202.92 | 25mW STEREO TRUE CAP FREE HEADPHONE AMP | QFN-16-1EP_3x3mm_P0.5mm_EP1.7x1.7mm |  | Already in hand
U4 | 1 | PCA9555 | Texas Instruments | PCA9555PW,112 | 568-3986-5-ND |  |  |  | 570 | 1 | 570 | 550 | 20 | 0.77898 | 444.0186 | I2C IO Expander, with internal pull-ups | TSSOP-24_4.4x7.8mm_P0.65mm |  | Digi-Reel
U8 | 1 | PCM5100A | Texas Instruments | PCM5100APWR | 296-36705-6-ND |  |  | C131154 | 570 | 1 | 570 | 550 | 20 | 1.12612 | 641.8884 | 2VRMS DirectPath, 100dB Audio Stereo DAC | TSSOP-20_4.4x6.5mm_P0.65mm |  | Digi-Reel
Y1 | 1 | 32.768kHz | Seiko Epson | Q13FC1350000200 | SER4103DKR-ND |  |  | C48615 | 570 | 1 | 570 | 550 | 20 | 0.20747 | 118.2579 | 32.768kHz, 7pF | Crystal_SMD_3215-2Pin_3.2x1.5mm |  | Digi-Reel
Y2 | 1 | 40Mhz | Seiko Epson | NX3225SA 40MHz EXS00A-CS03880 | 644-1249-1-ND |  |  | C255943 | 570 | 1 | 570 | 550 | 20 | 0.40872 | 232.9704 | 40Mhz, 10ppm, 10ppm, 7pF, 40ohm | Crystal_SMD_3225-4Pin_3.2x2.5mm | Critical | Digi-Reel
 |  |  |  |  |  |  |  |  |  |  | 550 | 0 | 550 |  | 0
` | 1 |  | Precision Microdrives | C08-00A | C08-00A |  |  |  | 570 | 1 | 570 | 550 | 20 | 2.97000 | 1692.9 | Linear Resonant Actuator Ø8x3.2T, 235Hz, 1.8Vrms AC |  |  | UK manufacturer. Expensive, not enough stock, but might be able to produce more
Batt | 1 |  | Blue Taiyang | LP375080 |  |  |  |  |  |  | 550 | 550 | 0 | 3.10000 | 1705 | 1500mAh Lipo with Molex 510210200, 50mm wire length |  |  | OMG I hate UPS
Earbuds | 1 |  |  |  |  |  |  |  |  |  | 550 | 550 | 0 | 1.00000 | 550 |  |  |  | Double check with Kerstin
USB-C cable | 1 |  | San Guan Siyuan? |  |  |  |  |  |  |  | 550 | 550 | 0 | 0.60000 | 330 | Custom, 0.75m |  |  | Waiting to hear from Sally, Abby (CN)
Inkjet printing | 1 |  | Peerless Coatings? |  |  |  |  |  |  |  | 550 | 550 | 0 |  | 0 |  |  |  | RFQ out to Peerless Coatings Ltd.
Laser cut coverlay | 1 |  | Peerless Coatings? |  |  |  |  |  | 600 | 1 | 600 | 550 | 50 |  | 0 |  |  |  | RFQ out to Peerless Coatings Ltd.
PCB Fabrication | 1 |  | Unknown vendor, EU |  |  |  |  |  |  |  | 550 | 550 | 0 |  | 0 |  |  |  | In progress
PCB Assembly | 1 |  | HCD |  |  |  |  |  |  |  | 550 | 550 | 0 |  | 0 |  |  |  | Need components from around 22/2
 |  |  |  |  |  |  |  |  |  |  |  |  |  | Total GBP | 21744.3426
 |  |  |  |  |  |  |  |  |  |  |  |  |  | Unit | 39.53516836
Total parts | 191
 |  |  |  |  |  |  |  |  |  |  | Exchange |  |  | 1.20000
 |  | TODO: re-reel some of the more expensive lines |  |  |  |  |  |  |  |  |  |  |  | Total EUR | 26093.21112
Happy |  |  |  |  |  |  |  |  |  |  |  |  |  | EUR unit | 47.44220204 | 550 | Units to build
Question / Note
Attention
Critical / Problem
Ignore – Part not required
