jeffmakes/tr20-badge-hw/r1/tr20-r1-mechanical/tr20-r1-coverlay.dxf

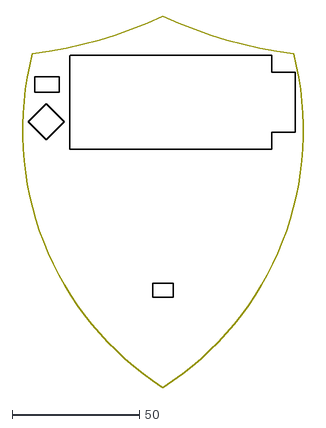
[picture p25: CAD file, 2019-12-24]
r1/tr20-r1-mechanical/tr20-r1-coverlay.dxf
115.2 x 145.8
