jeffmakes/tr20-badge-hw/r1/tr20-r1-assembly/tr20-r1-bottom-assembly.pdf

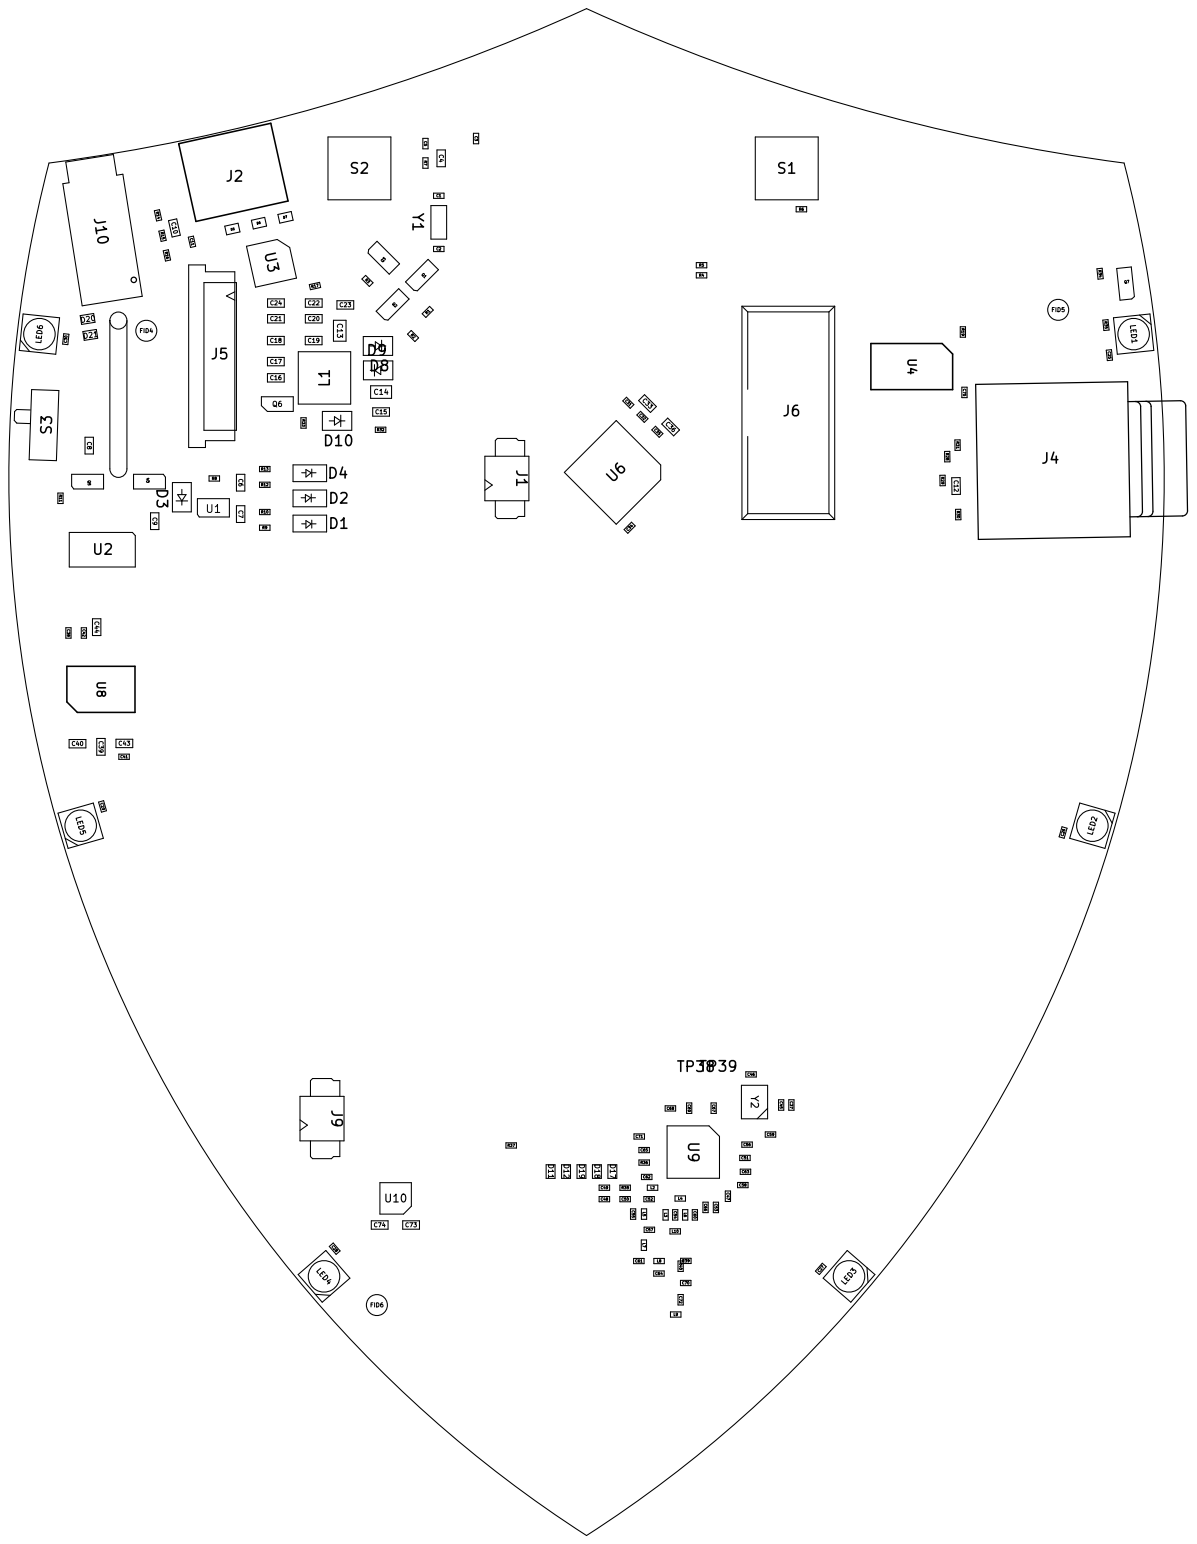
[picture p29: page 1]
