jeffmakes/tr20-badge-hw/r1/tr20-r1-assembly/tr20-r1-top-assembly.pdf

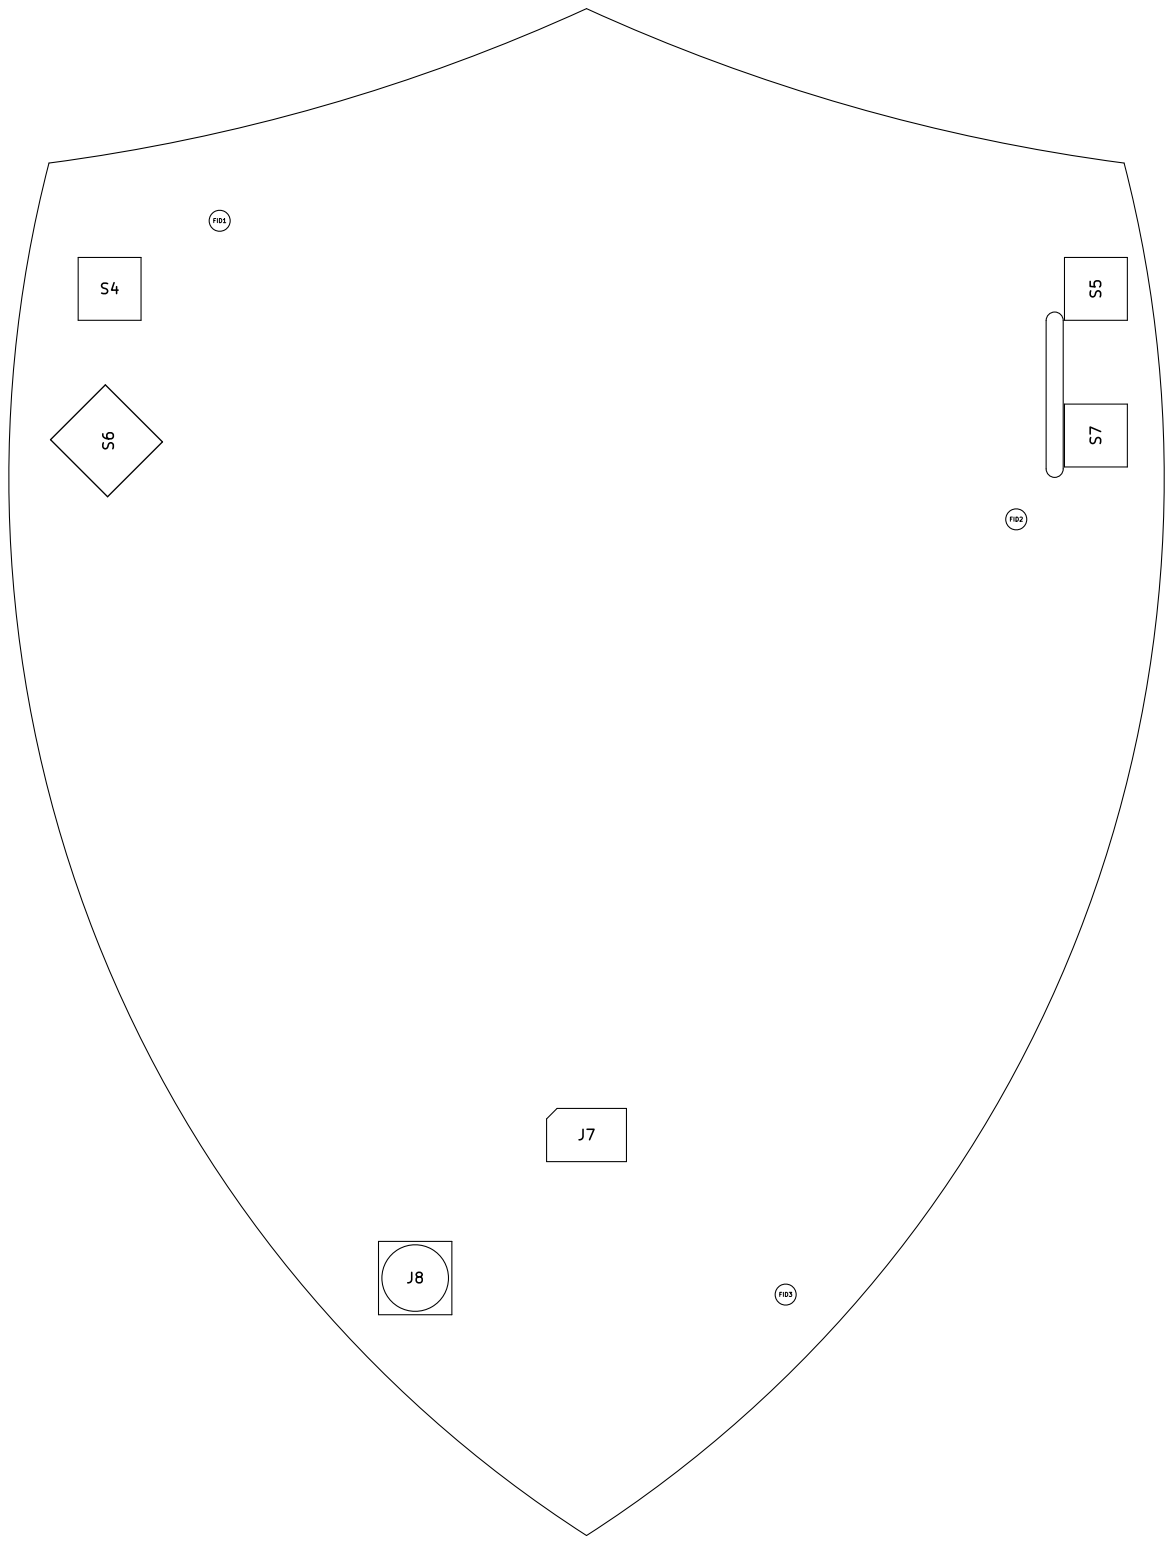
[picture p30: page 1]
