jeffmakes/tr20-badge-hw/r2/build/tr20-r2-assembly/r2-bottom-assy.pdf

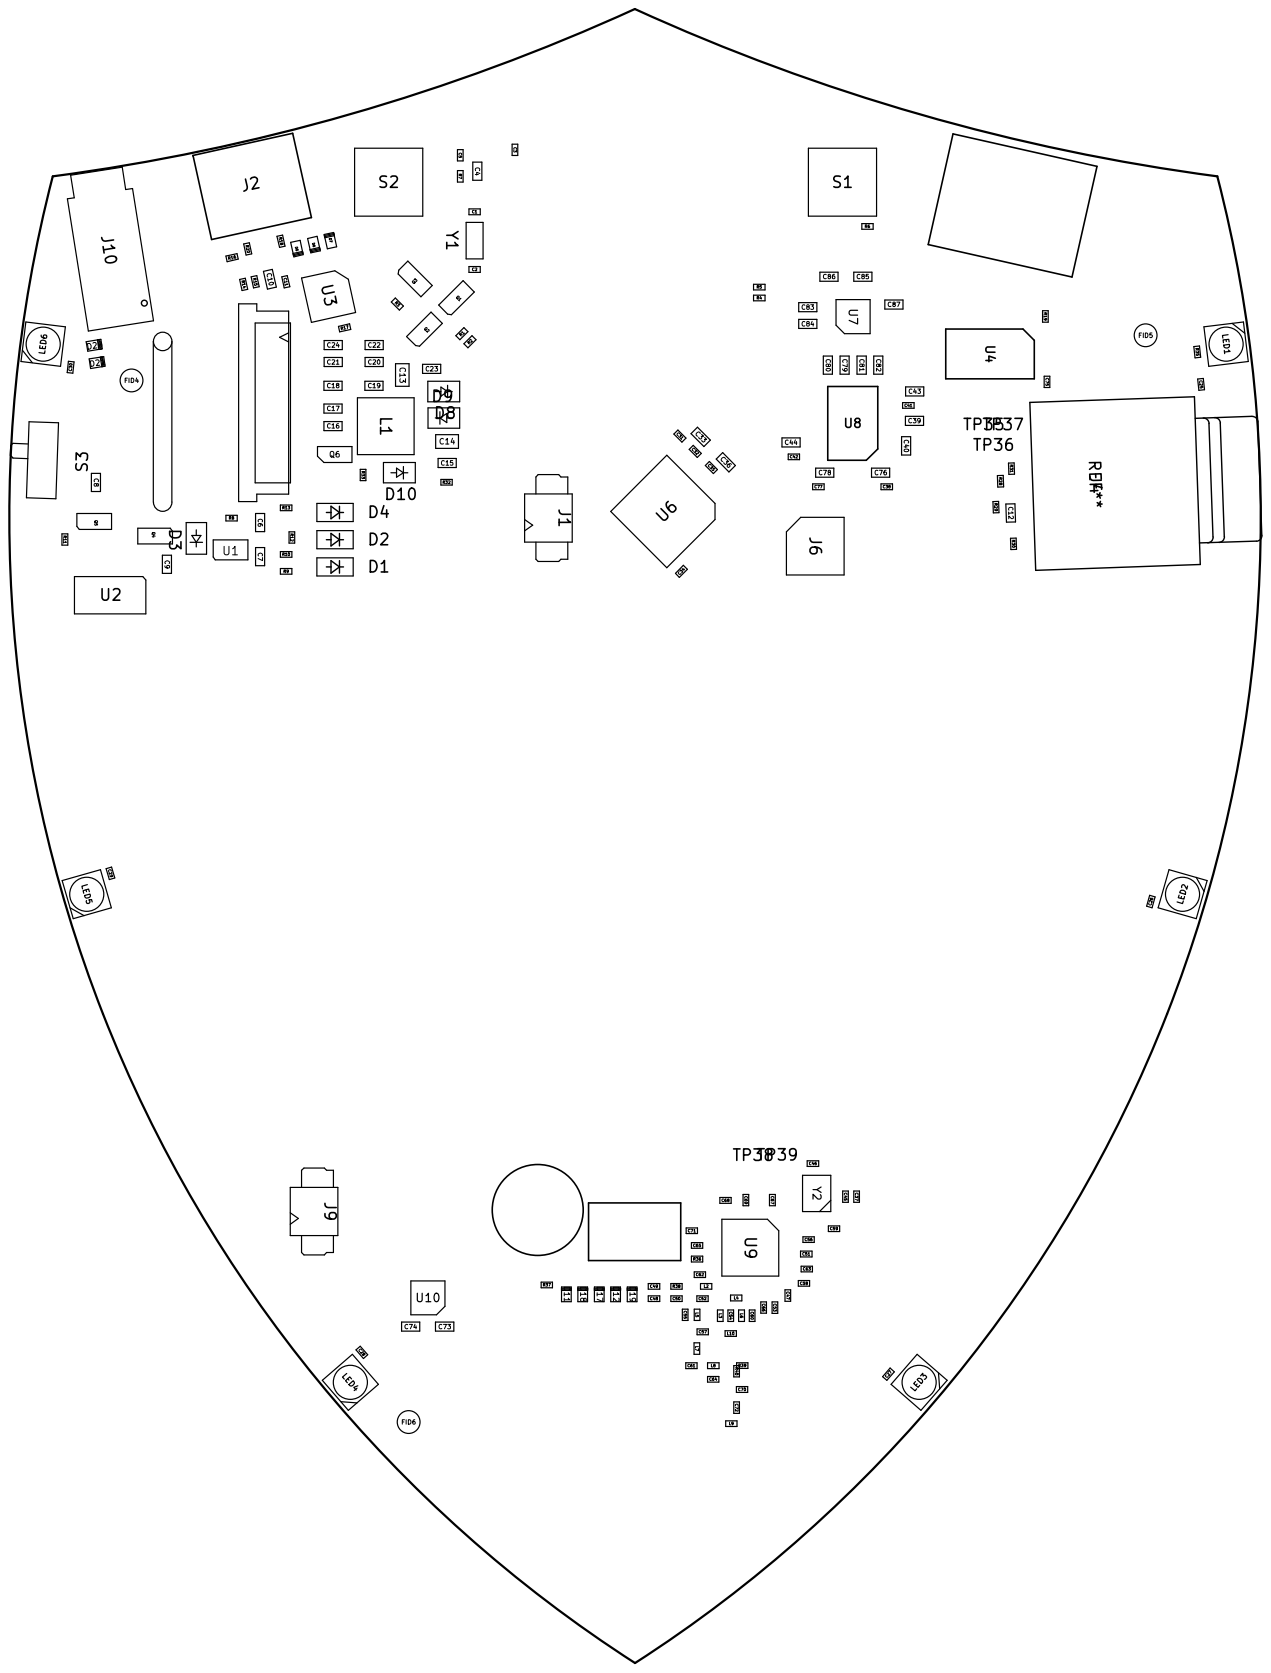
[picture p31: page 1]
