jeffmakes/tr20-badge-hw/r2/build/tr20-r2-assembly/r2-top-assy.pdf

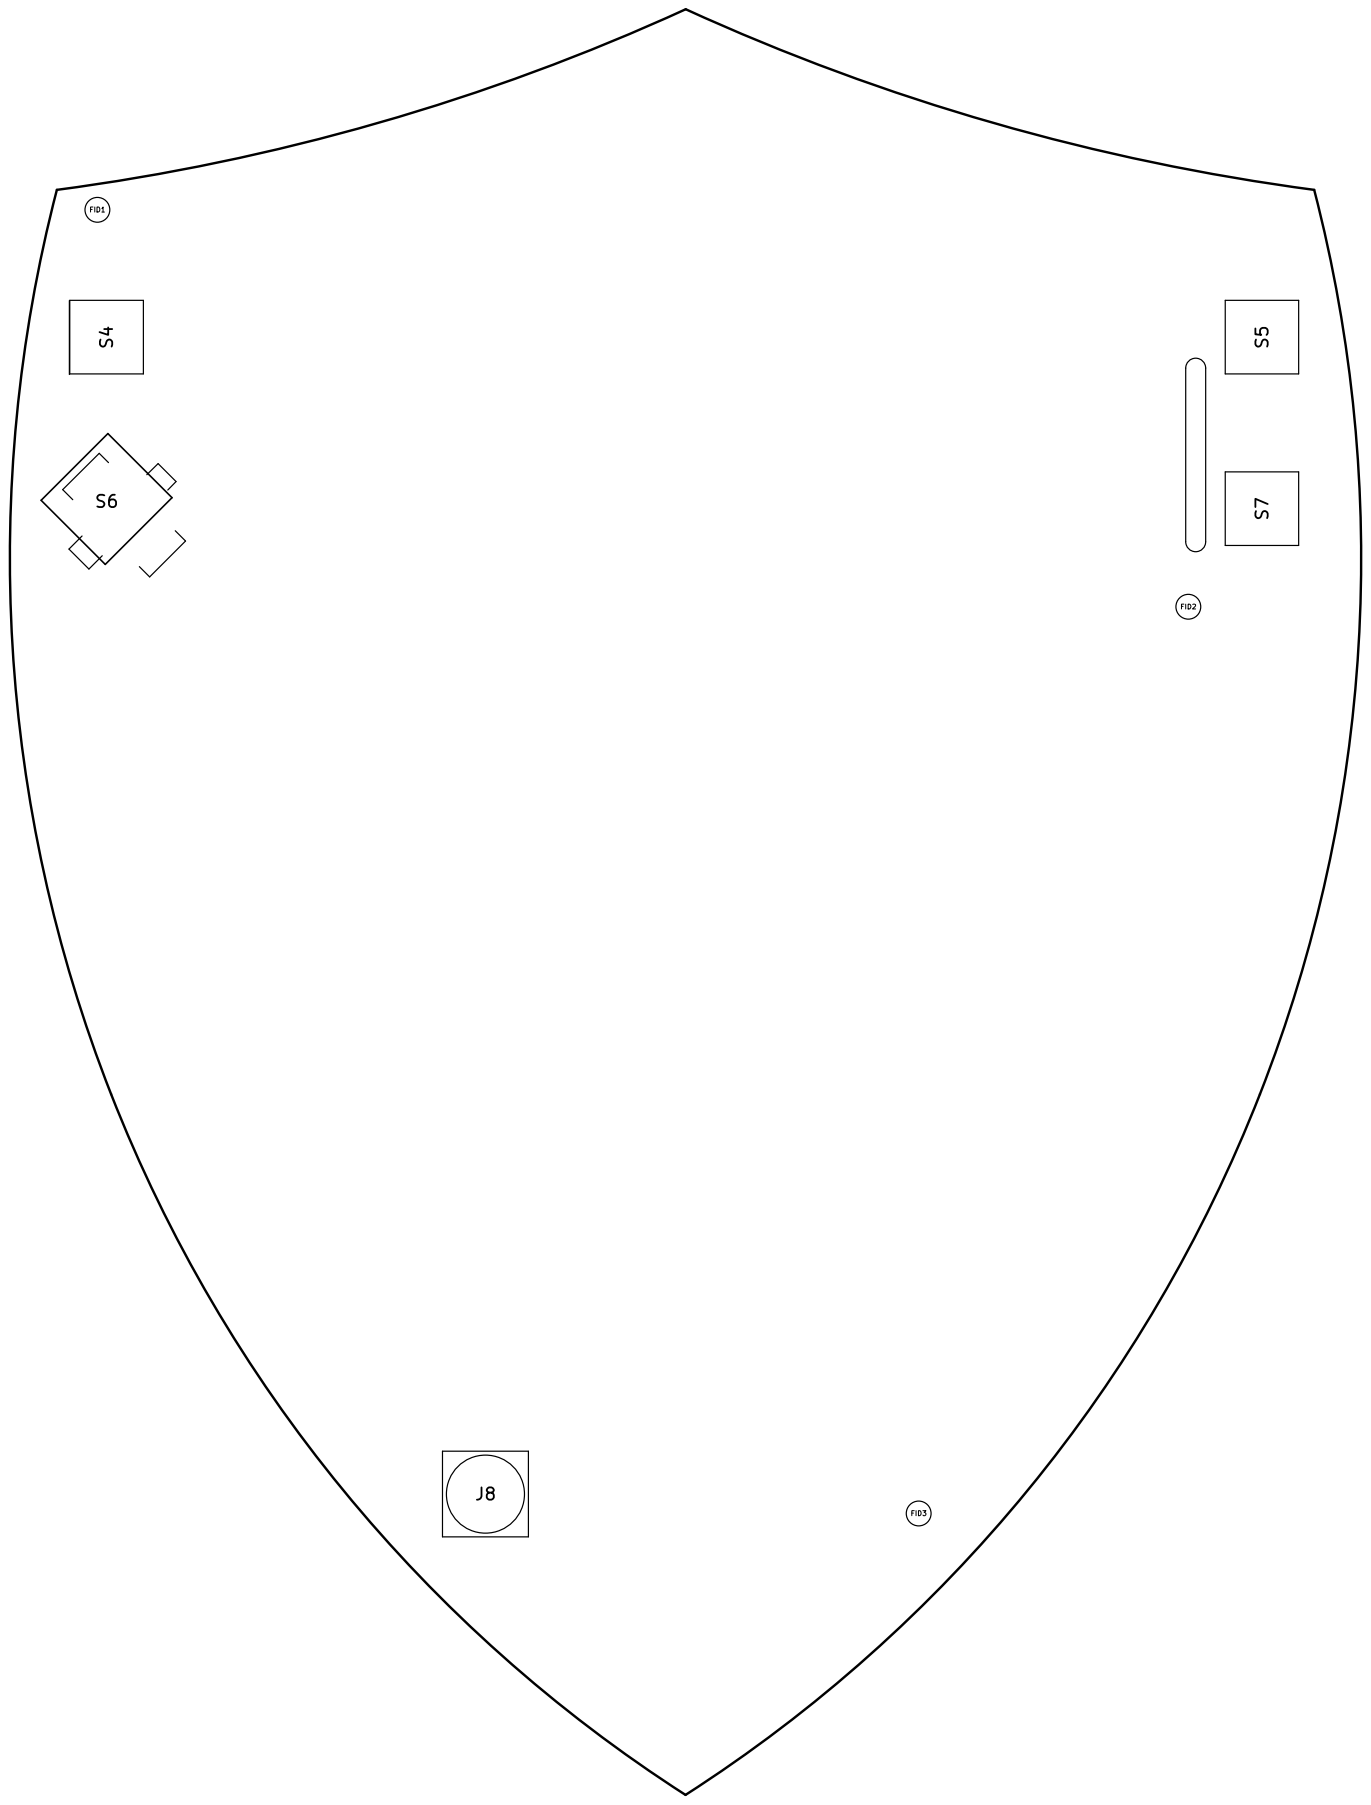
[picture p32: page 1]
