jeffmakes/tr20-badge-hw/r1/graphics/t20-bottom.pdf

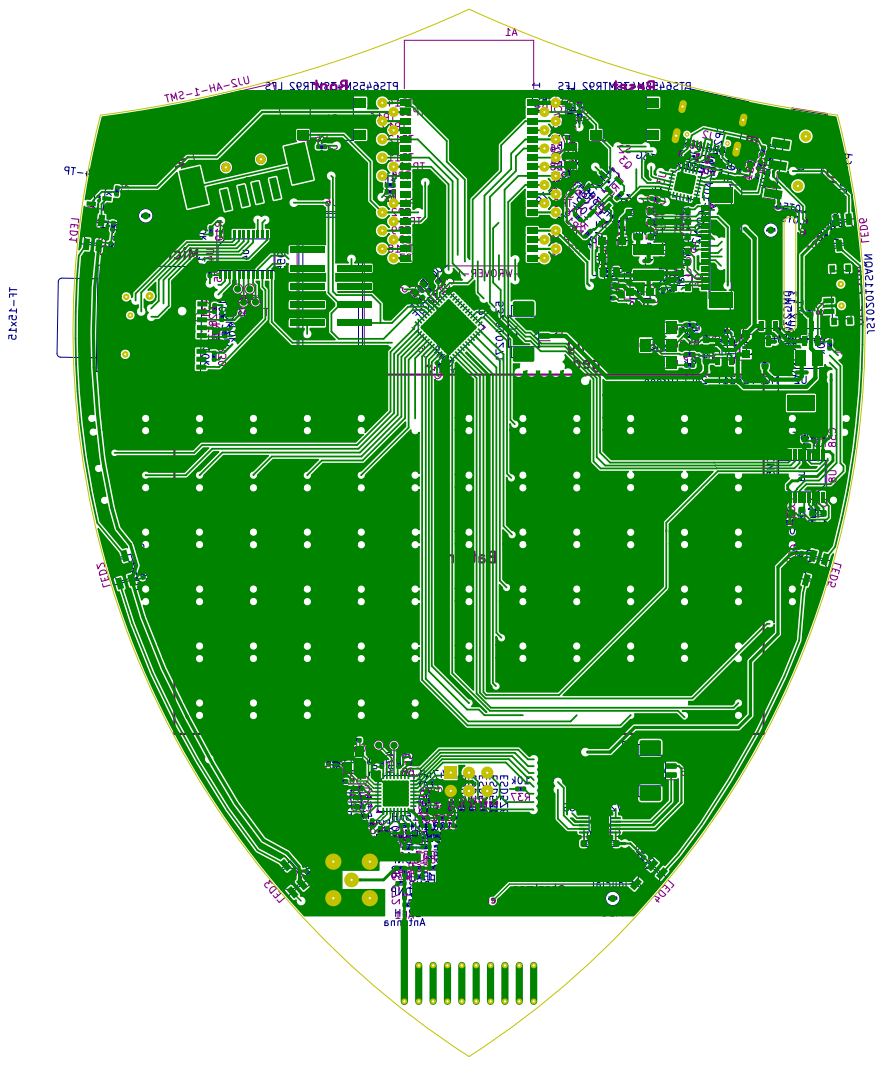
[picture p33: page 1]
