jeffmakes/tr20-badge-hw/r1/graphics/t20-top.pdf

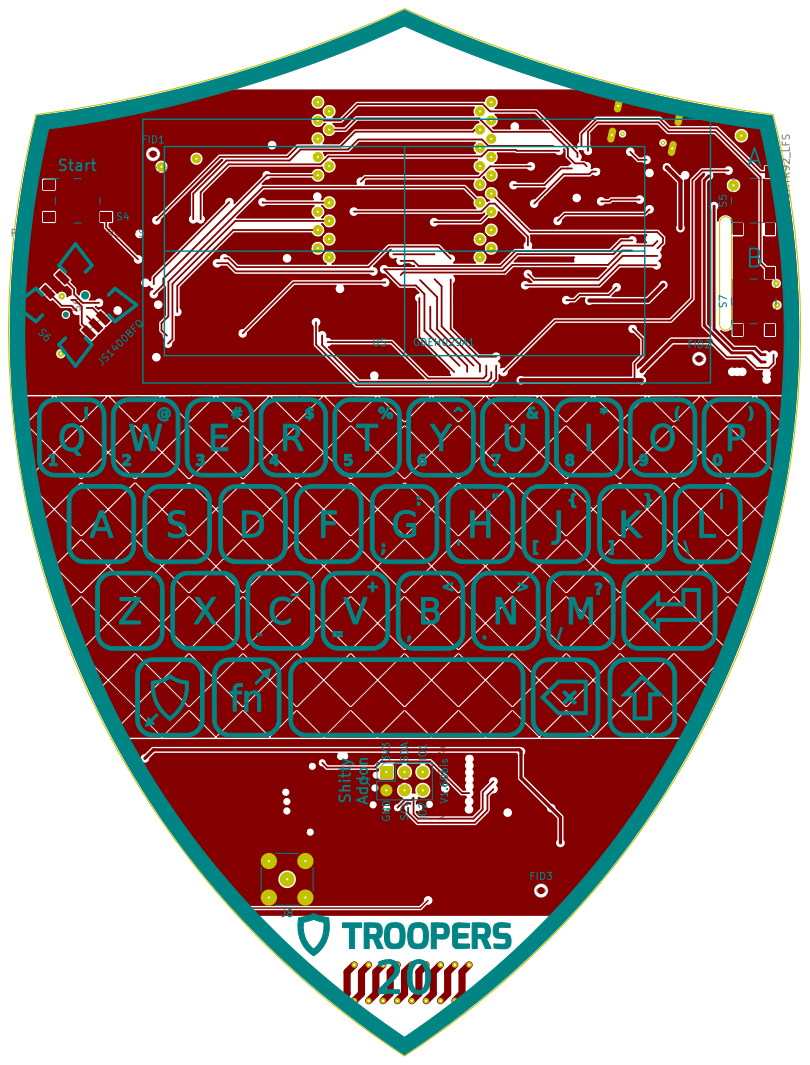
[picture p34: page 1]
