jeffmakes/tr20-badge-hw/r1/tr20/t20.pdf

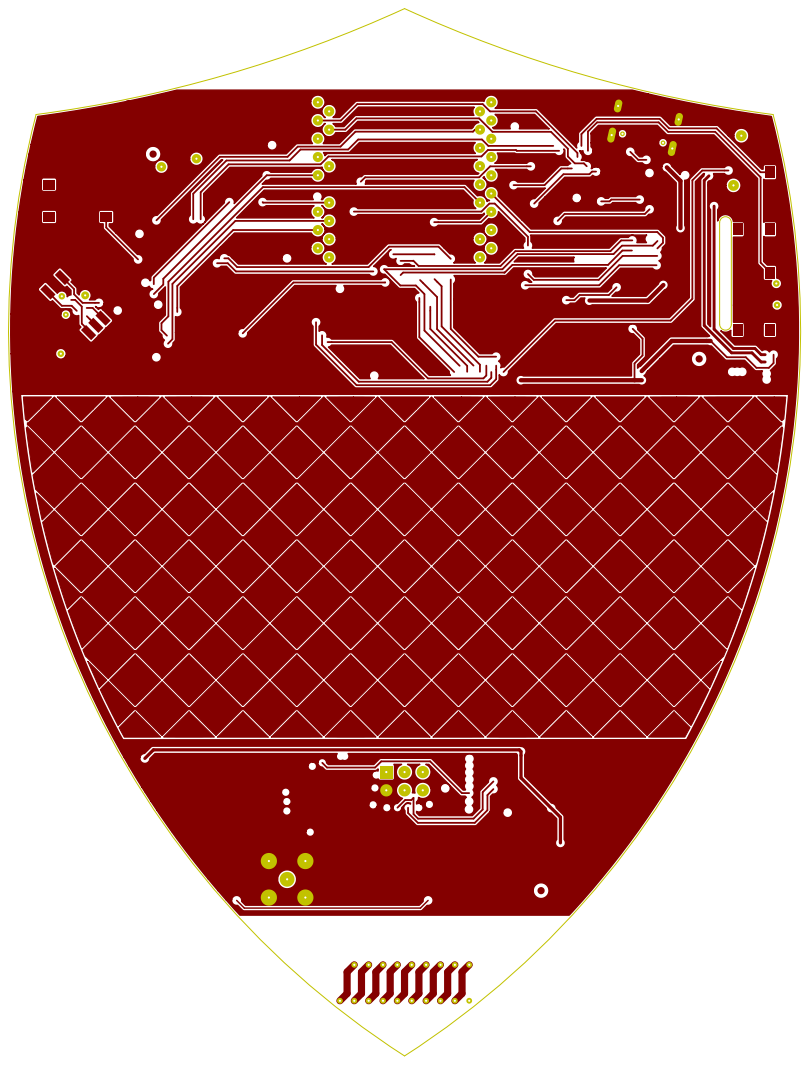
[picture p35: page 1]
