jeffmakes/tr20-badge-hw/docs/conn/Korean-Hroparts-Elec-PJ-320D-4A_C95562.pdf

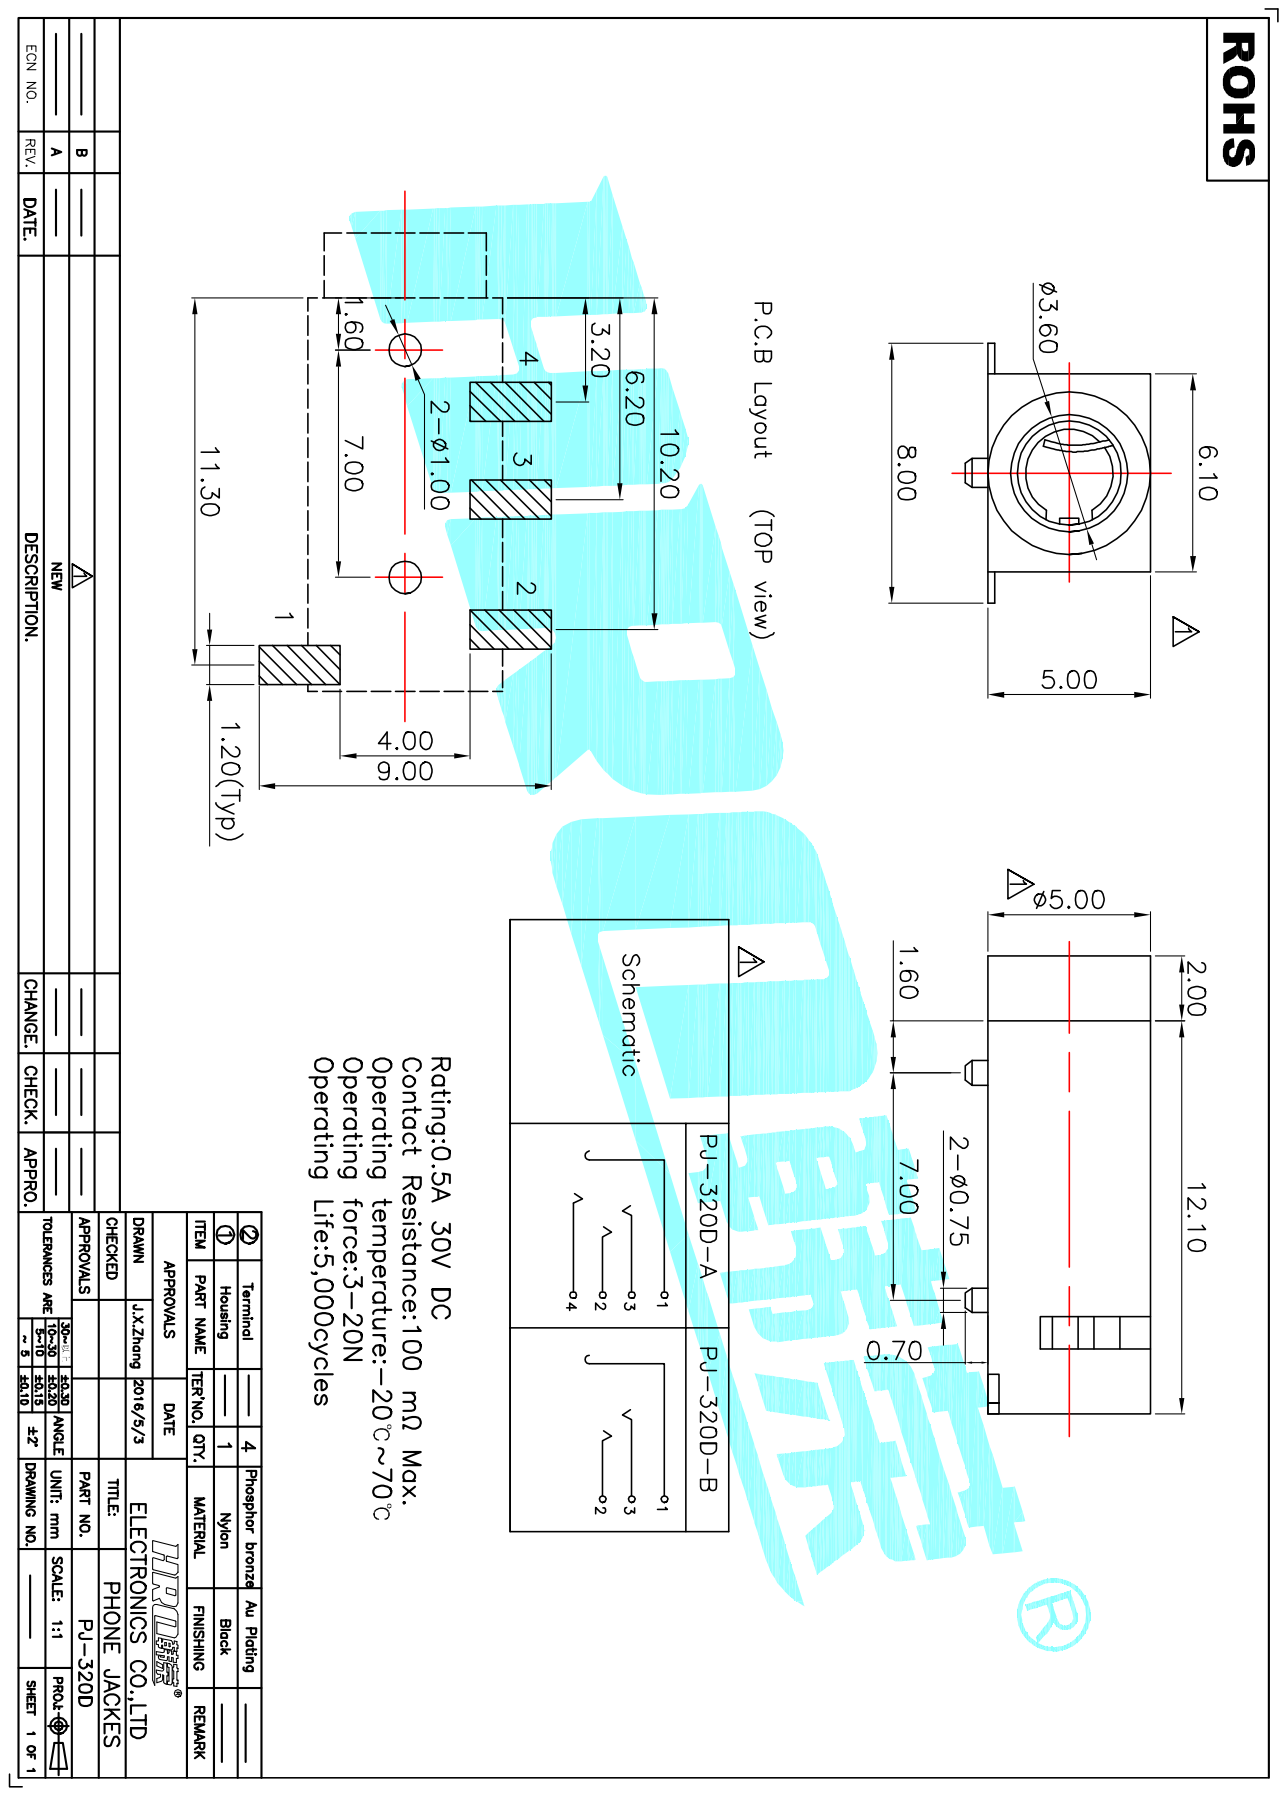
[picture p36: page 1]
