jeffmakes/tr20-badge-hw/docs/conn/usb-a-短体全贴直边6.3.pdf

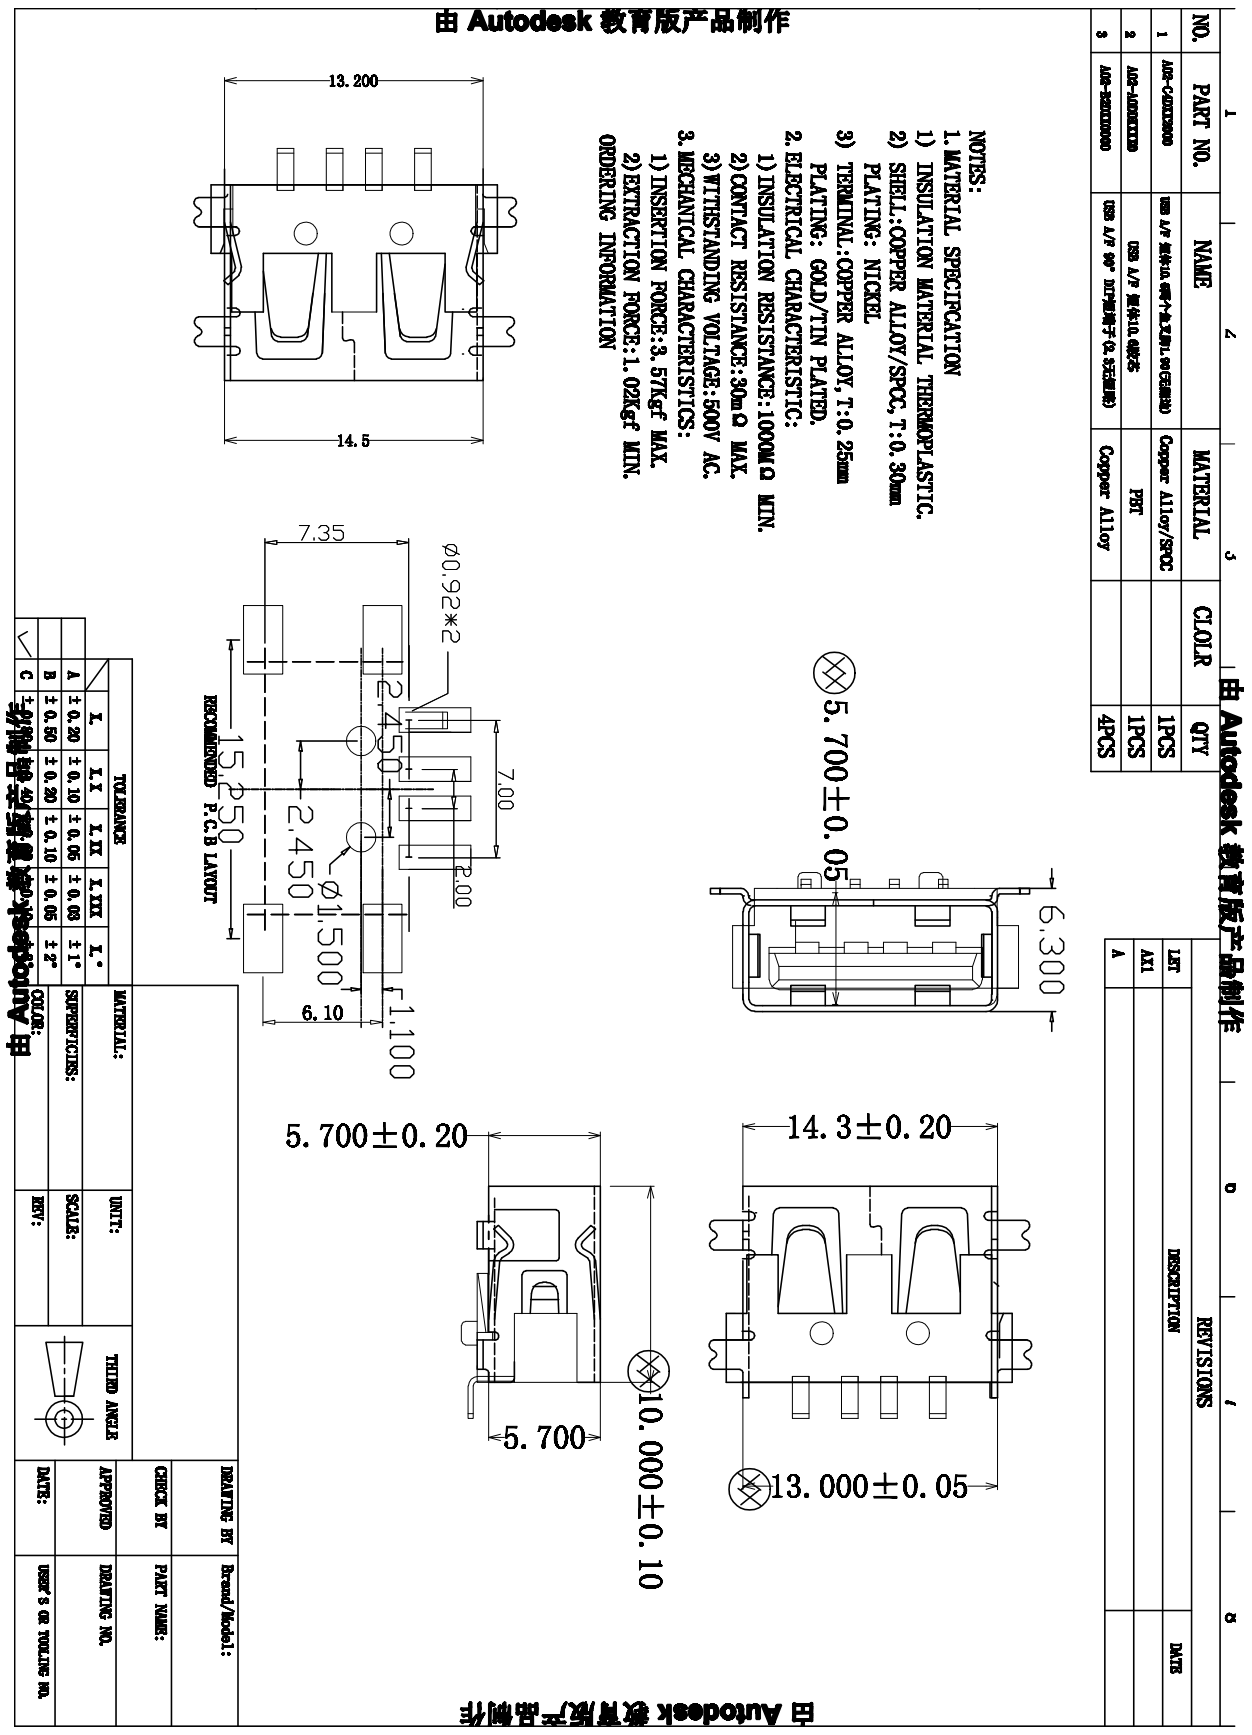
[picture p37: page 1]
