jeffmakes/tr20-badge-hw/docs/conn/Jing-YJ-USB-AF-SMT-01_C8328.pdf

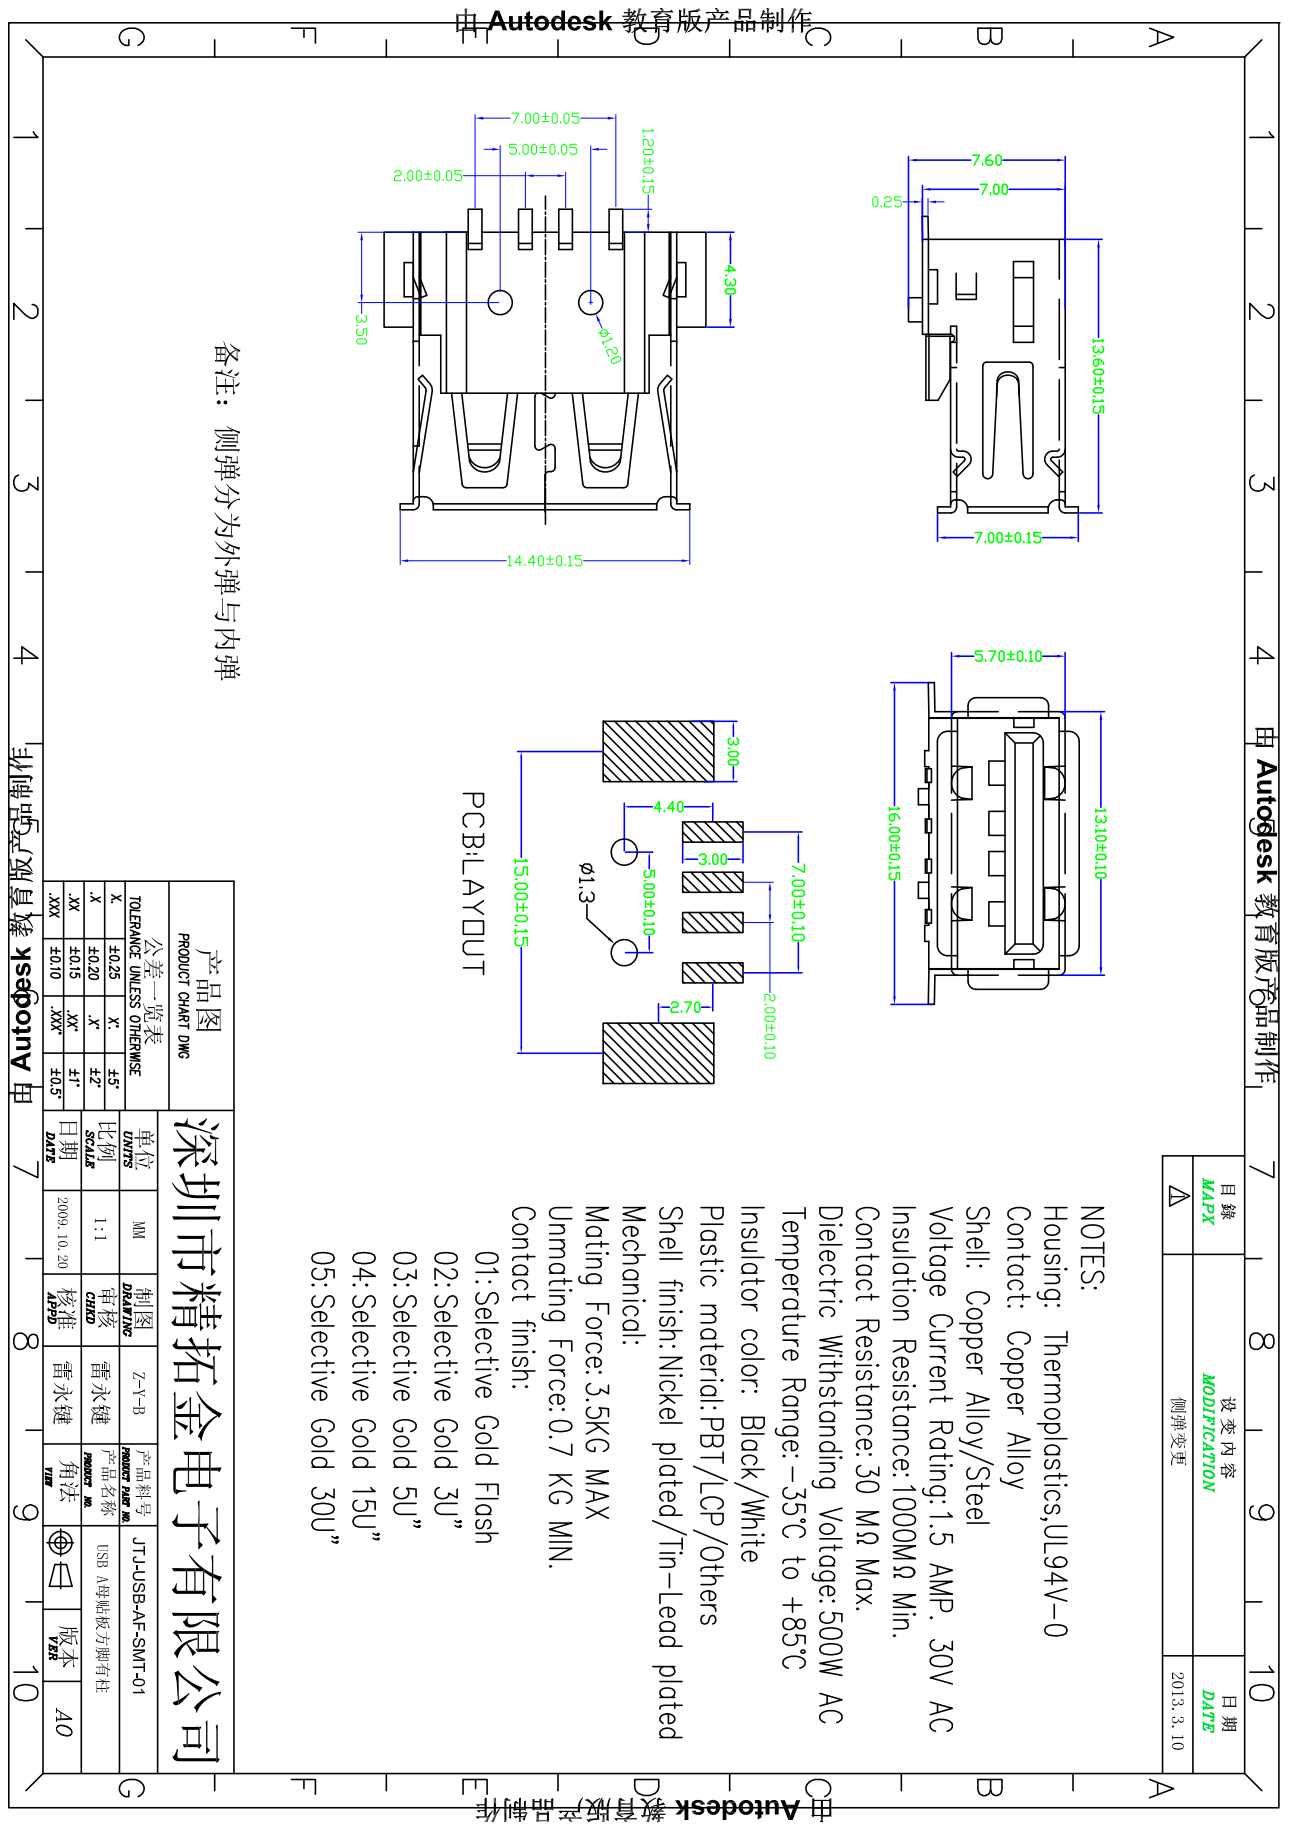
[picture p38: page 1]
