jeffmakes/tr20-badge-hw/docs/misc/zhejiang-jianfu-joystick-TMHU13-050.pdf

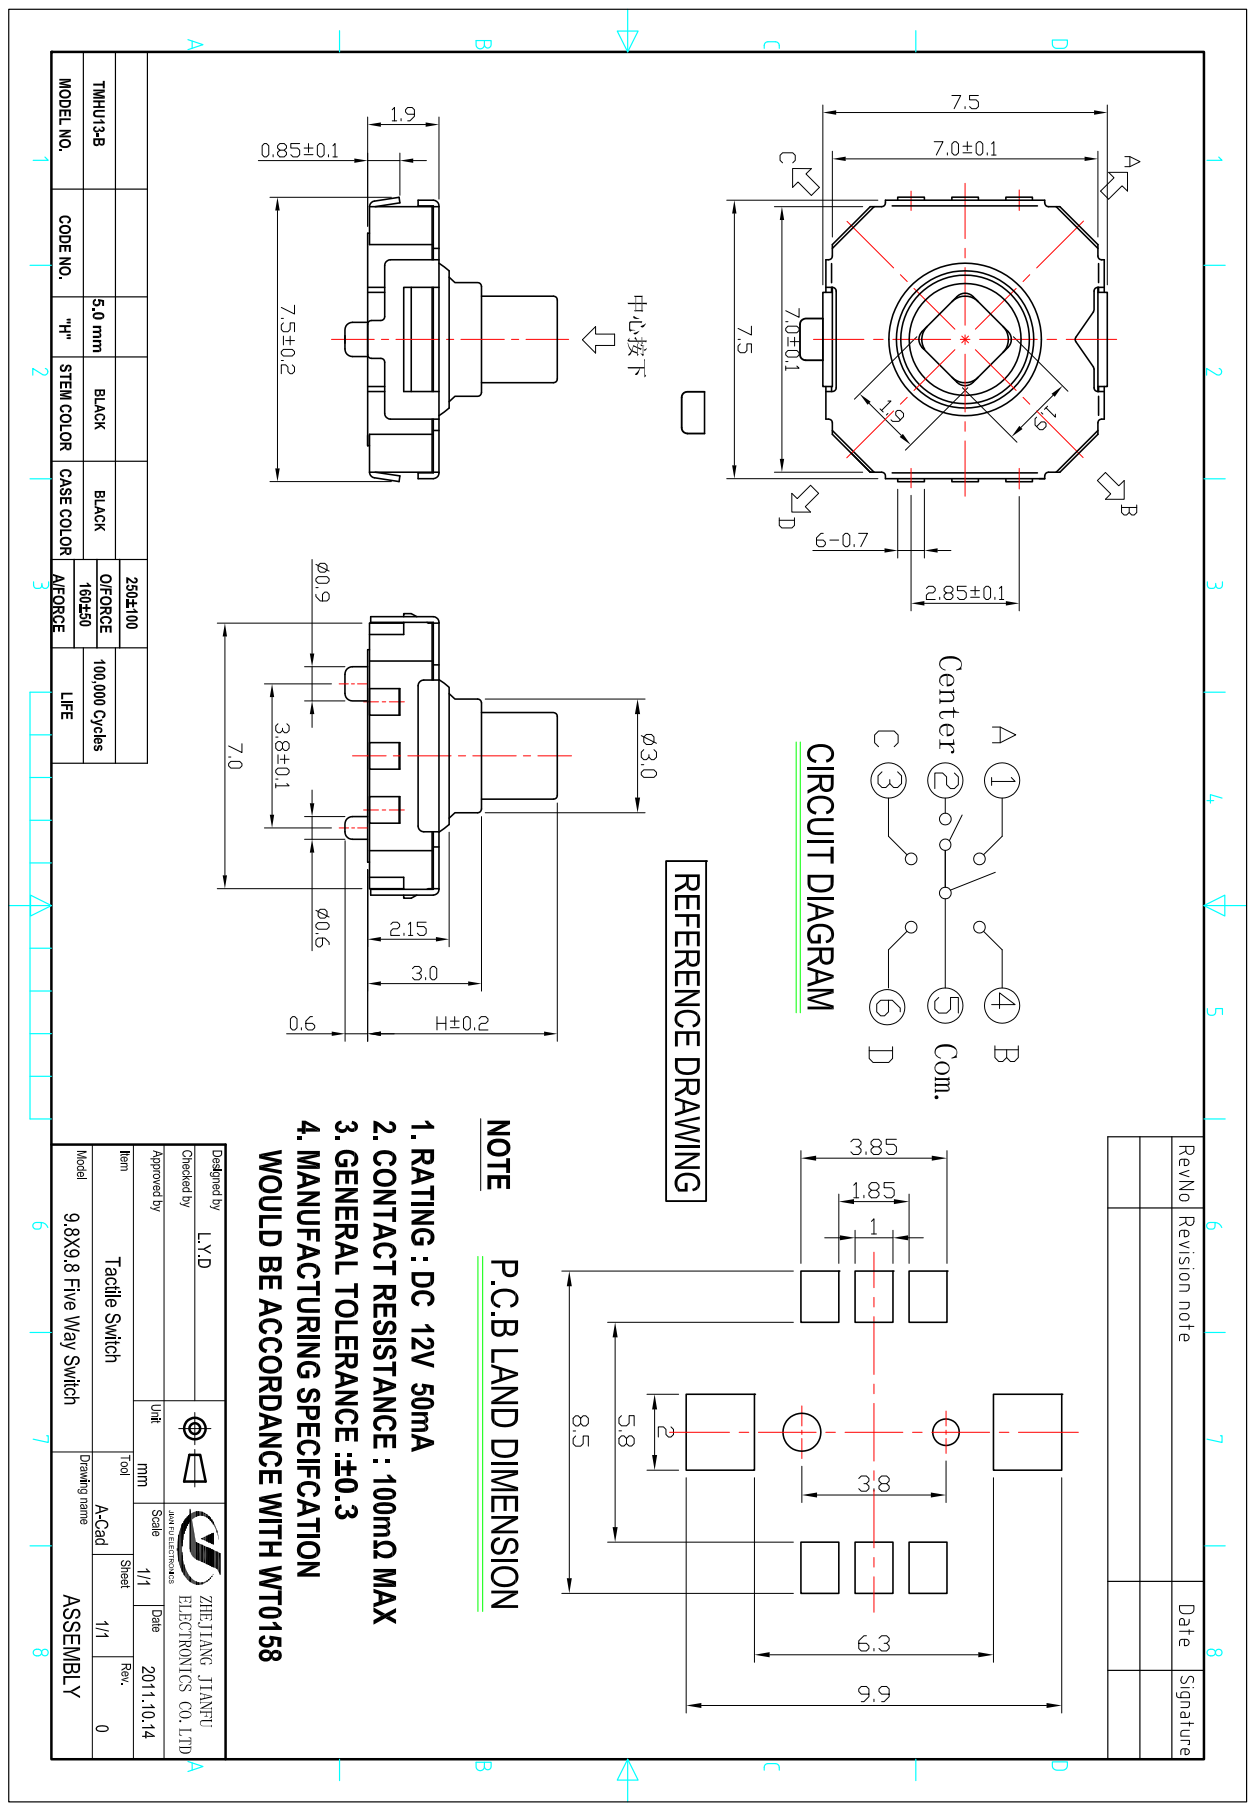
[picture p39: page 1]
