jeffmakes/tr20-badge-hw/docs/radio/swwr121-cc1200_em_868_930/plot.pdf

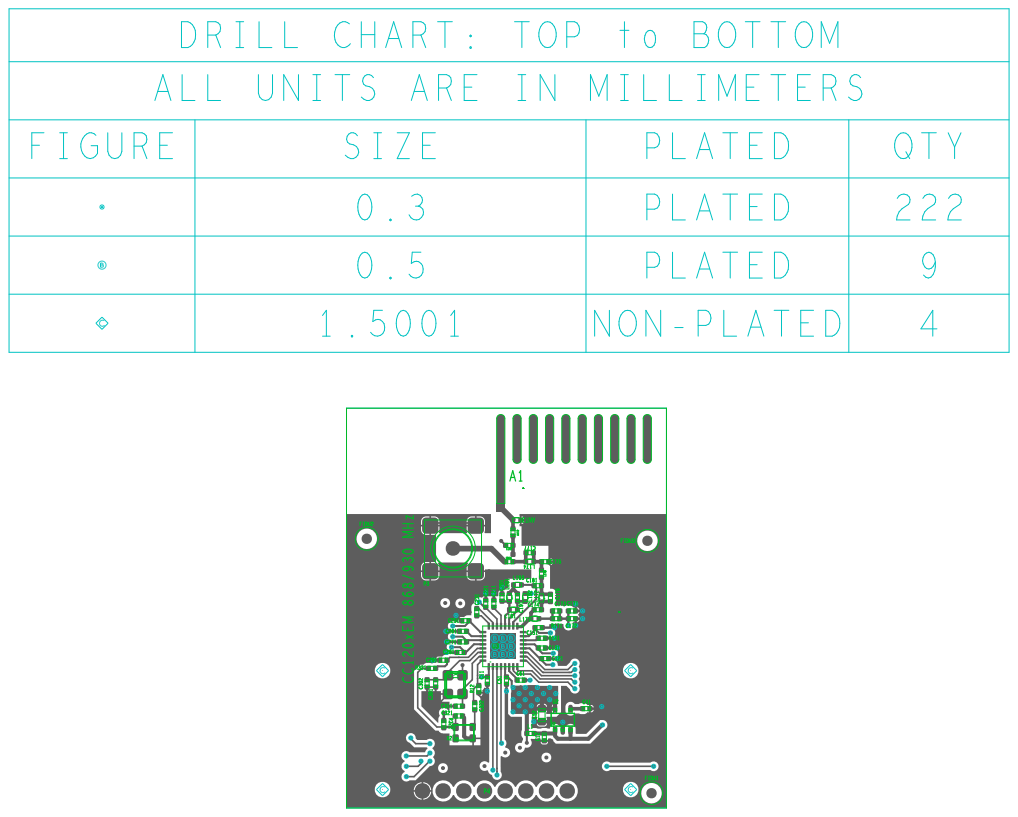
[picture p40: page 1]
