jeffmakes/tr20-badge-hw/r2/src/r2.kicad_pcb

## KiCad design r2/src/r2.kicad_pcb (2020-02-09)

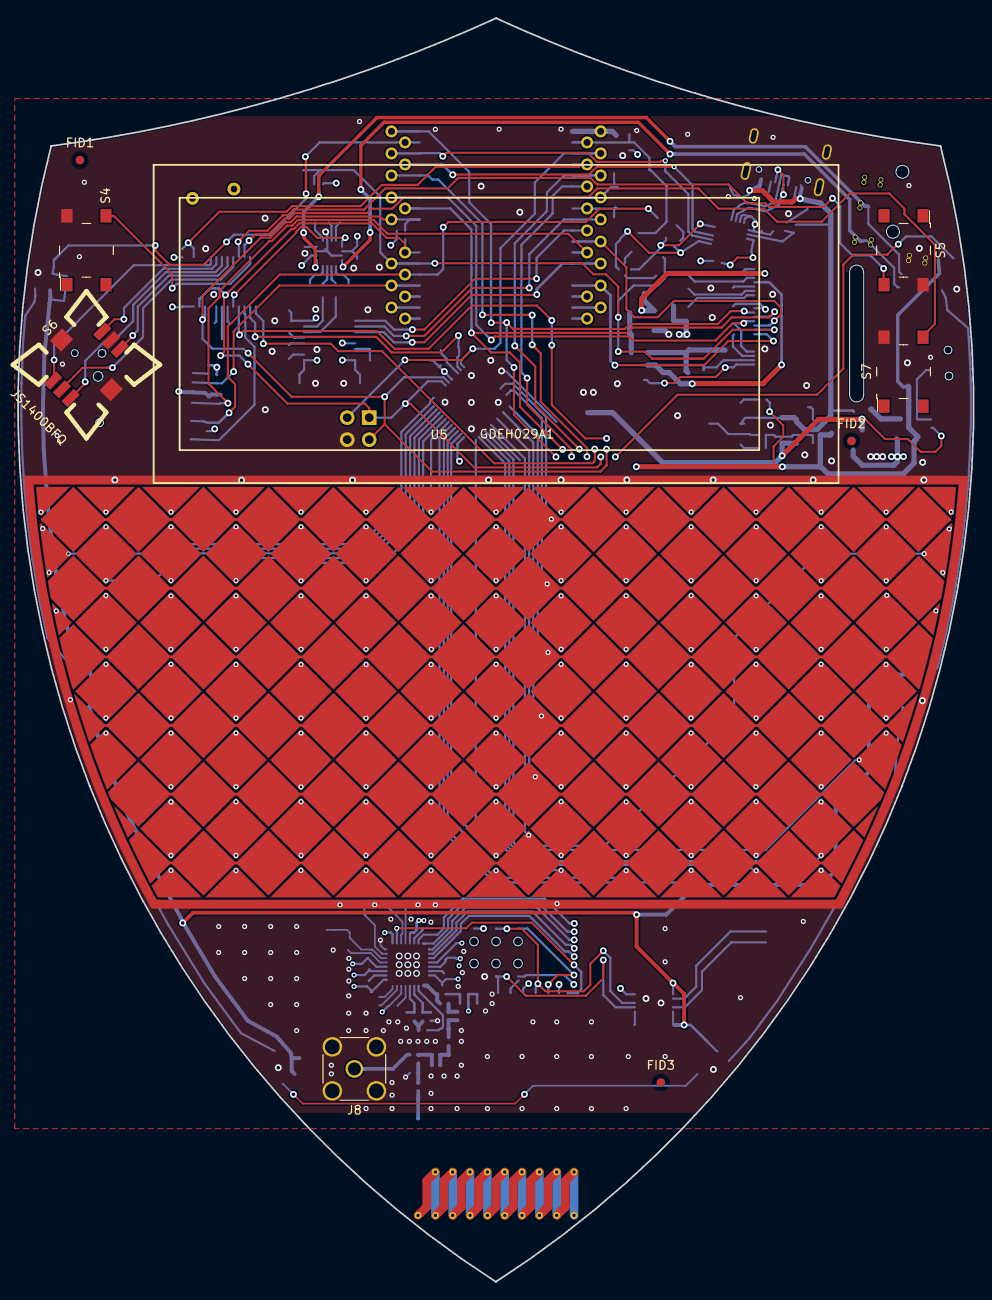
[picture p41: board r2.kicad_pcb from above]

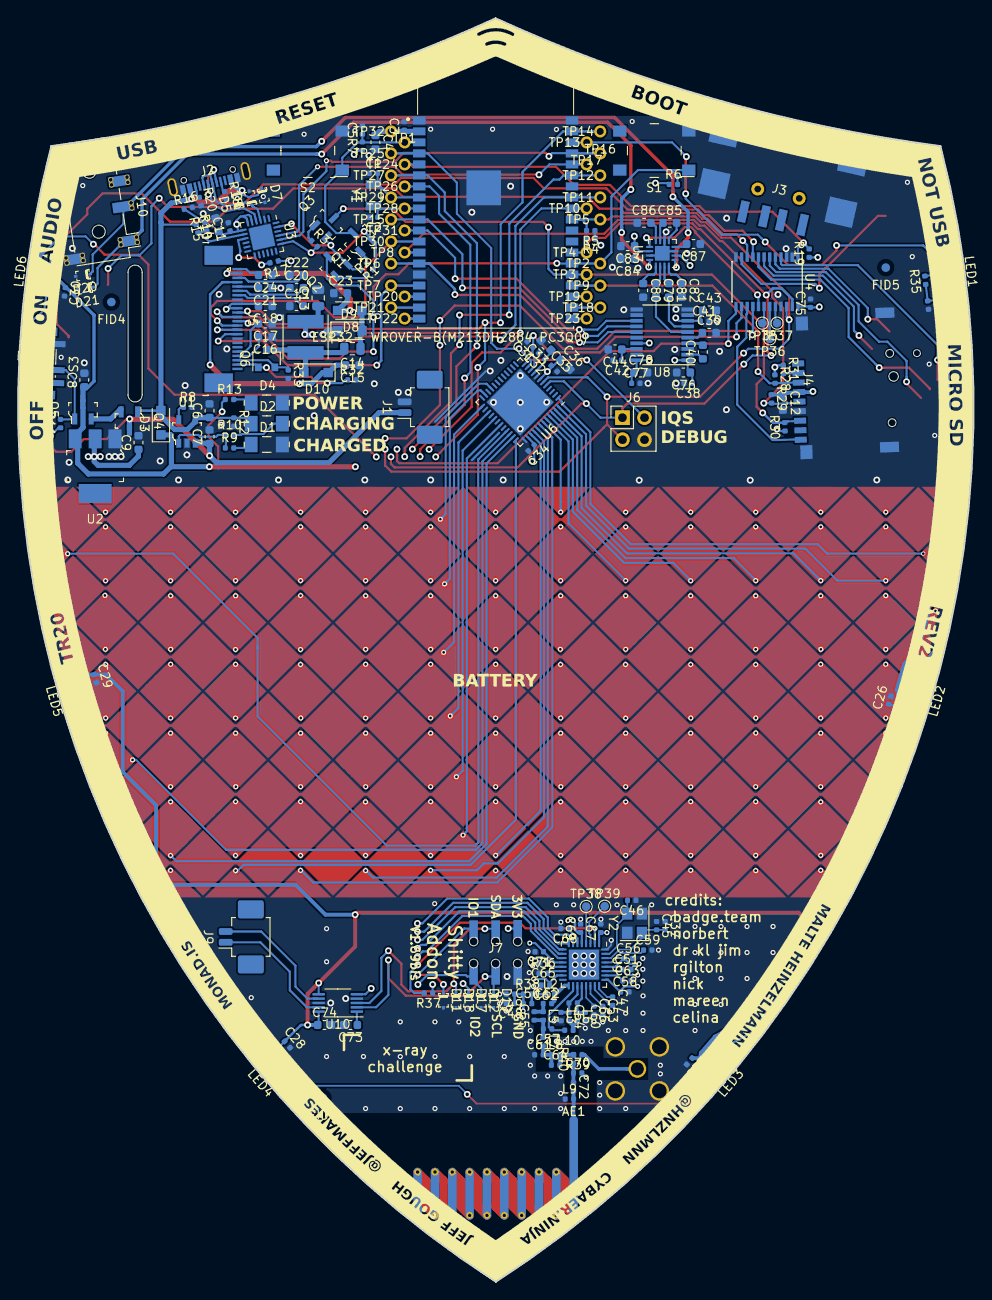
[picture p42: board r2.kicad_pcb from below]

Board: 4 copper layers, 110.2 x 145.8 mm, 233 parts (223 on the bottom side), 156 nets.

Parts:
A1: ESP32- WROVER-B(M213DH2864 PC3Q0); ESP32-WROVER-I
AE1: Antenna; Antenna_TI_DN038
C1, C2, C45, C46, C52: 15pF; C_0402_1005Metric
C3, C5, C11, C25, C26, C27, C28, C29, C30, C31, C34, C38, C41, C42, C75, C77: 100nF; C_0402_1005Metric
C4, C12: 22uF; C_0603_1608Metric
C6, C7, C8, C9, C10, C15, C16, C17, C18, C19, C20, C21, C22, C23, C24, C33, C36, C39, C40, C43, C44, C73, C74, C76, C78, C79, C80, C81, C82, C83, C84, C85, C86, C87: 1uF; C_0603_1608Metric
C13, C14: 4.7uF; C_0805_2012Metric
C32, C35, C49: 100pF; C_0402_1005Metric
C37, C64, C70: DNP; C_0402_1005Metric
C47: 1.5nF; C_0402_1005Metric
C48, C66: 10nF; C_0402_1005Metric
C50: 33pF; C_0402_1005Metric
C51, C53, C56, C58, C59, C62, C63, C65, C67, C69, C71: 47nF; C_0402_1005Metric
C54, C60: 3.3pF; C_0402_1005Metric
C55, C72: 1pF; C_0402_1005Metric
C57: 2.2pF; C_0402_1005Metric
C61: 3pF; C_0402_1005Metric
C68: 220nF; C_0402_1005Metric
D1: Green; D-1206
D2: Orange; D-1206
D3, D8, D9, D10: SS13FL; D_SOD-123F
D4: Yellow; D-1206
D5, D6, D7, D11, D12, D17, D18, D19, D20, D21: ESD5Z6.0T5G; SOD-523-numbered-pads
FID1, FID2, FID3, FID4, FID5, FID6: Fiducial; Fiducial_1mm_Mask2mm
J1, J9: 532610271; Molex_PicoBlade_53261-0271_1x02-1MP_P1.25mm_Horizontal
J2: USB-C-12; jing-usb-c-lcsc-C167321
J3: USB-A-10mm-flangeless; USB-A-short-body
J4: TF-15x15; microSD_HC_Sofng_TF-15
J5: AFC07-S24ECA-00; AFC07x24-1MP_P0.5mm_Horizontal
J6: DNP; PinHeader_2x02_P2.54mm_Vertical
J7: 2x03-socket-2.54-through-board; PinSocket_2x03_P2.54mm_Through-Board-Mating
J8: DNP; SMA_Amphenol_132291-12_Vertical
J10: PJ-320D; Jack_3.5mm_PJ320D_Horizontal_strengthening-vias
L1: 10uH 1A; L_Taiyo-Yuden_MD-5050
L2: 10nH; L_0402_1005Metric
L3, L6, L8, L9, L10: 12nH; L_0402_1005Metric
L4: 15nH; L_0402_1005Metric
L5: 7.5nH; L_0402_1005Metric
L7: 18nH; L_0402_1005Metric
LED1, LED2, LED3, LED4, LED5, LED6: SK6812; LED_SK6812MINI_PLCC4_3.5x3.5mm_P1.75mm_no_silk
Q1, Q2, Q3: MMBT3904-TP; SOT-23-3
Q4, Q5: DMG2305UX-13; SOT-23-3
Q6: SSM3K376R; SOT-23
R1, R2, R3, R6, R7, R11, R12, R14, R15, R16, R19, R28, R29, R30, R31, R32, R37: 10k; R_0402_1005Metric
R4, R5, R8, R9, R10, R13, R17, R35: 1k; R_0402_1005Metric
R18, R20: 5.1k; R_0402_1005Metric
R33: 3R; R_0402_1005Metric
R36: 56k; R_0402_1005Metric
R38: 10R; R_0402_1005Metric
R39: DNP; R_0402_1005Metric
R40: 0R; R_0402_1005Metric
S1, S2, S4, S5, S7: PTS645SM43SMTR92_LFS; Switch_Tactile_SMD_6x6mm_PTS645
S3: JS102011SAQN; SW_SPDT_PCM12
S6: JS1400BFQ; SW_JS1400BFQ-arrows
TP1, TP2, TP3, TP4, TP5, TP6, TP7, TP8, TP9, TP10, TP11, TP12, TP13, TP14, TP15, TP16, TP17, TP18, TP19, TP20, TP21, TP22, TP23, TP24, TP25, TP26, TP27, TP28, TP29, TP30, TP31, TP32: test-pad-1.4-TH
TP35, TP36, TP37, TP38, TP39: TestPoint_Pad_D1.0mm
U1: MCP73831T-2ACI_OT; SOT-753
U2: AP2114H-3_3TRG1; SOT-223
U3: CP2102N-A01-GQFN24; QFN-24-1EP_4x4mm_P0.5mm_EP2.6x2.6mm
U4: PCA9555; TSSOP-24_4.4x7.8mm_P0.65mm
U5: GDEH029A1
U6: IQS550; QFN-48-1EP_7x7mm_P0.5mm_EP5.45x5.45mm
U7: PAM8908; QFN-16-1EP_3x3mm_P0.5mm_EP1.7x1.7mm
U8: PCM5100A; TSSOP-20_4.4x6.5mm_P0.65mm
U9: CC1200; QFN-32-1EP_5x5mm_P0.5mm_EP3.45x3.45mm
U10: DRV2605LDGS; VSSOP-10_3x3mm_P0.5mm
XY1: tr20_touch_array; Touch_Array_TR20
Y1: 32.768kHz; Crystal_SMD_3215-2Pin_3.2x1.5mm
Y2: 40Mhz; Crystal_SMD_3225-4Pin_3.2x2.5mm

Connections:
+3V3: A1.2, C3.1, C4.1, C9.1, C10.1, C11.1, C12.1, C13.1, C18.2, C34.1, C35.1, C36.1, C38.1, C41.1, C43.1, C48.1, C49.1, C50.1, C51.1, C53.1, C56.1, C58.1, C62.1, C65.1, C67.1, C69.1, C71.1, C75.1, C76.1, C77.1, C78.1, C83.1, C84.1, D17.1, J4.4, J5.9, J5.10, J7.1, L1.1, R4.1, R5.1, R6.1, R7.1, R17.1, R19.1, R28.1, R29.1, R30.1, R31.1, R37.1, R38.1, TP32.1, U2.2, U3.5, U3.6, U3.7, U4.24, U6.7, U6.38, U7.6, U7.14, U8.1, U8.8, U8.17, U8.20, U9.1, U9.5, U9.12, U9.13, U9.15, U9.22, U9.25, U9.27, U9.28, U10.5
+BATT: C7.1, J1.1, Q4.3, R11.1, U1.3
+VSW: C8.1, C25.1, C26.1, C27.1, C28.1, C29.1, C30.1, C74.1, D3.1, LED1.3, LED2.3, LED3.3, LED4.3, LED5.3, LED6.3, Q5.3, R13.1, R35.1, U2.3, U10.6, U10.10
/32K_XN: A1.9, C2.1, TP28.1, Y1.2
/32K_XP: A1.8, C1.2, TP29.1, Y1.1
/AMP_EN: U4.17, U7.13
/BTN_INT: A1.5, R19.2, TP24.1, U4.1
/CC_INT: A1.6, TP27.1, U9.10
/CC_RESET: R37.2, U4.13, U9.2
/DISP_BUSY: A1.16, J5.16, TP7.1
/DTR: Q2.2, Q3.2, R1.2, U3.23
/EN: A1.3, C5.1, Q1.3, R7.2, S2.1, TP1.1
/I2S_SCK: A1.11, TP31.1, U8.13
/I2S_SD: A1.10, TP15.1, U8.14
/I2S_WS: A1.14, TP6.1, U8.15
/IO0: A1.25, J5.15, Q2.3, R6.2, S1.1, TP2.1
/IQ_RDY: A1.4, J6.2, TP25.1, U6.11
/IQ_RESET: C31.1, U4.14, U6.10
/LED_DIN: A1.36, LED1.2, R35.2, TP13.1
/LED_DOUT: D11.1, J7.5, LED6.4
/MISO: A1.7, TP26.1, U9.9
/MOSI: A1.37, J5.11, TP14.1, U9.7
/P1_5: TP35.1, U4.18
/P1_6: TP36.1, U4.19
/P1_7: TP37.1, U4.20
/RTS: Q1.2, R2.2, R3.2, U3.19
/RXD0: A1.34, TP17.1, U3.21
/SAO_GPIO2: D12.1, J7.6, U4.16
/SCK: A1.30, J5.12, TP10.1, U9.8
/SCL: A1.29, D19.1, J6.3, J7.4, R5.2, TP5.1, U4.22, U6.6, U10.2
/SDA: A1.26, D18.1, J6.1, J7.3, R4.2, TP4.1, U4.23, U6.5, U10.3
/SD_CLK: A1.13, J4.5, R29.2, TP8.1
/SD_CMD: A1.23, J4.3, R28.2, TP9.1
/SD_DAT0: A1.24, J4.7, Q3.3, R30.2, TP3.1
/SD_DETECT: J4.CD, U4.15
/TXD0: A1.35, TP16.1, U3.20
/_reserved6: A1.20, TP23.1
/_reserved7: A1.21, TP18.1
/_reserved8: A1.22, TP19.1
/_reserved9: A1.17, TP20.1
/_reserved10: A1.18, TP21.1
/_reserved11: A1.19, TP22.1
/audio/DAC_OUTL: C79.2, U8.6
/audio/DAC_OUTR: C81.2, U8.7
/audio/LDO0: C42.1, C44.1, U8.18
/audio/OUTL: D21.1, J10.T, U7.16
/audio/OUTR: D20.1, J10.R1, U7.5
/display/GDR: J5.23, Q6.1, R32.1
/display/PREVGH: C15.2, D10.1, J5.4
/display/PREVGL: C23.2, D8.2, J5.2
/display/RESE: J5.22, Q6.2, R33.1
/display/d_VCOM: C24.2, J5.1
/display/d_VDD: C19.2, J5.7
/display/d_VGH: C17.2, J5.20
/display/d_VGL: C16.2, J5.21
/display/d_VPP: C20.2, J5.6
/display/d_VSH: C21.2, J5.5
/display/d_VSL: C22.2, J5.3
/io_expander/BTN_A: S5.4, U4.9
/io_expander/BTN_B: S7.4, U4.10
/io_expander/BTN_START: S4.4, U4.11
/io_expander/JOY_A: S6.1, U4.4
/io_expander/JOY_B: S6.4, U4.5
/io_expander/JOY_C: S6.3, U4.6
/io_expander/JOY_D: S6.6, U4.7
/io_expander/JOY_PUSH: S6.2, U4.8
/power/~PWR_EN~: Q5.1, R11.2, S3.2
/touchpad/Rx4A: U6.21, XY1.RX0
/touchpad/Rx5A: U6.23, XY1.RX1
/touchpad/Rx6A: U6.25, XY1.RX2
/touchpad/Rx7A: U6.27, XY1.RX3
/touchpad/Rx8A: U6.29, XY1.RX4
/touchpad/Rx9A: U6.31, XY1.RX5
/touchpad/Tx0: U6.33, XY1.TX14
/touchpad/Tx1: U6.34, XY1.TX13
/touchpad/Tx2: U6.35, XY1.TX12
/touchpad/Tx3: U6.36, XY1.TX11
/touchpad/Tx4: U6.39, XY1.TX7
/touchpad/Tx5: U6.40, XY1.TX8
/touchpad/Tx6: U6.41, XY1.TX9
/touchpad/Tx7: U6.42, XY1.TX10
/touchpad/Tx8: U6.43, XY1.TX6
/touchpad/Tx9: U6.44, XY1.TX5
/touchpad/Tx10: U6.45, XY1.TX4
/touchpad/Tx11: U6.46, XY1.TX3
/touchpad/Tx12: U6.47, XY1.TX2
/touchpad/Tx13: U6.48, XY1.TX1
/touchpad/Tx14: U6.1, XY1.TX0
/usb/USB_DN: D5.1, J2.A7, J2.B7, U3.4
/usb/USB_DP: D6.1, J2.A6, J2.B6, U3.3
/~CC_CS~: A1.33, TP12.1, U9.11
/~DC~: A1.12, J5.14, TP30.1
/~DISP_CS~: A1.31, J5.13, TP11.1
GND: A1.1, A1.15, A1.38, A1.39, C1.1, C2.2, C3.2, C4.2, C5.2, C6.2, C7.2, C8.2, C9.2, C10.2, C11.2, C12.2, C13.2, C15.1, C16.1, C17.1, C18.1, C19.1, C20.1, C21.1, C22.1, C23.1, C24.1, C25.2, C26.2, C27.2, C28.2, C29.2, C30.2, C31.2, C32.2, C33.2, C34.2, C35.2, C36.2, C37.1, C38.2, C39.2, C41.2, C42.2, C43.2, C44.2, C45.1, C46.1, C48.2, C49.2, C51.2, C53.2, C56.2, C58.2, C59.2, C60.2, C61.1, C62.2, C63.2, C65.2, C66.2, C67.2, C68.2, C69.2, C70.2, C71.2, C73.2, C74.2, C75.2, C76.2, C77.2, C78.2, C80.2, C82.2, C83.2, C84.2, C86.1, C87.1, D1.2, D4.2, D5.2, D6.2, D7.2, D9.1, D11.2, D12.2, D17.2, D18.2, D19.2, D20.2, D21.2, J1.2, J2.A1, J2.B1, J2.SH, J3.5, J4.6, J4.G, J5.8, J5.17, J6.4, J7.2, J8.2, J10.S, L3.2, L9.1, LED1.1, LED2.1, LED3.1, LED4.1, LED5.1, LED6.1, R8.2, R12.2, R16.2, R18.2, R20.2, R32.2, R33.2, R36.1, S1.3, S2.3, S3.1, S4.2, S5.2, S6.5, S6.SH1, S6.SH2, S7.2, U1.2, U2.1, U3.2, U3.25, U4.2, U4.3, U4.12, U4.21, U6.8, U6.37, U6.49, U7.7, U7.10, U7.15, U7.17, U8.3, U8.9, U8.10, U8.11, U8.12, U8.16, U8.19, U9.32, U9.33, U10.4, U10.8, XY1.GND, Y2.2, Y2.4
unnamed: AE1.1, C72.2, L9.2
unnamed: C14.1, D8.1, D9.2
unnamed: C14.2, D10.2, L1.2, Q6.3
unnamed: C32.1, C33.1, U6.9
unnamed: C37.2, C45.2, U9.30, Y2.1
unnamed: C39.1, U8.5
unnamed: C40.1, U8.2
unnamed: C40.2, U8.4
unnamed: C46.2, U9.31, Y2.3
unnamed: C47.1, U9.24
unnamed: C47.2, U9.23
unnamed: C50.2, L2.1, R38.2
unnamed: C52.1, C55.2, L5.1
unnamed: C52.2, L2.2, U9.17
unnamed: C54.1, L3.1, L4.2, U9.19
unnamed: C54.2, L6.2, L10.1
unnamed: C55.1, C57.2, L5.2, L7.1
unnamed: C57.1, L10.2, U9.18
unnamed: C59.1, U9.29
unnamed: C60.1, L4.1, L6.1, U9.20
unnamed: C61.2, C64.1, L7.2, L8.1
unnamed: C63.1, U9.26
unnamed: C64.2, L8.2, R39.2, R40.2
unnamed: C66.1, U9.21
unnamed: C68.1, U9.6
unnamed: C70.1, C72.1, R40.1
unnamed: C73.1, U10.1
unnamed: C79.1, U7.2
unnamed: C80.1, U7.1
unnamed: C81.1, U7.3
unnamed: C82.1, U7.4
unnamed: C85.1, U7.11
unnamed: C85.2, U7.9
unnamed: C86.2, U7.12
unnamed: C87.2, U7.8
unnamed: D1.1, R9.2
unnamed: D2.2, R10.2
unnamed: D4.1, R13.2
unnamed: J2.A5, R18.1
unnamed: J2.B5, R20.1
unnamed: J4.2, R31.2
unnamed: J8.1, R39.1
unnamed: J9.1, U10.9
unnamed: J9.2, U10.7
unnamed: LED1.4, LED2.2
unnamed: LED2.4, LED3.2
unnamed: LED3.4, LED4.2
unnamed: LED4.4, LED5.2
unnamed: LED5.4, LED6.2
unnamed: Q1.1, R1.1
unnamed: Q2.1, R2.1
unnamed: Q3.1, R3.1
unnamed: Q4.2, Q5.2
unnamed: R8.1, U1.5
unnamed: R9.1, R10.1, U1.1
unnamed: R14.2, R15.1, U3.8
unnamed: R15.2, R16.1
unnamed: R17.2, U3.9
unnamed: R36.2, U9.14
unnamed: TP38.1, U9.4
unnamed: TP39.1, U9.3
VBUS: C6.1, D2.1, D3.2, D7.1, J2.A4, J2.B4, Q4.1, R12.1, R14.1, U1.4
