jeffmakes/tr20-badge-hw/tr20.ini

[IC]
Device=IQS5XX-B000
[Streaming]
Setup=63
[GUI]
Setup0=0
Setup1=0
Setup2=0
Setup3=1300
Setup4=10
Setup5=1
[Memory Map]
MM0=0
MM1=0
MM2=0
MM3=0
MM4=12
MM5=255
MM6=255
MM7=255
MM8=255
MM9=255
MM10=255
MM11=255
MM12=255
MM13=255
MM14=40
MM15=43
MM16=0
MM17=0
MM18=0
MM19=0
MM20=0
MM21=0
MM22=0
MM23=0
MM24=154
MM25=186
MM26=165
MM27=136
MM28=26
MM29=0
MM30=0
MM31=0
MM32=0
MM33=0
MM34=153
MM35=185
MM36=166
MM37=169
MM38=202
MM39=144
MM40=0
MM41=0
MM42=0
MM43=0
MM44=153
MM45=184
MM46=168
MM47=170
MM48=204
MM49=169
MM50=173
MM51=105
MM52=0
MM53=0
MM54=150
MM55=184
MM56=166
MM57=171
MM58=202
MM59=169
MM60=172
MM61=157
MM62=133
MM63=0
MM64=150
MM65=184
MM66=166
MM67=172
MM68=202
MM69=168
MM70=170
MM71=156
MM72=164
MM73=52
MM74=150
MM75=184
MM76=165
MM77=169
MM78=202
MM79=166
MM80=171
MM81=156
MM82=164
MM83=50
MM84=152
MM85=181
MM86=166
MM87=169
MM88=202
MM89=168
MM90=172
MM91=160
MM92=165
MM93=52
MM94=152
MM95=182
MM96=165
MM97=169
MM98=202
MM99=168
MM100=172
MM101=160
MM102=166
MM103=52
MM104=152
MM105=184
MM106=165
MM107=168
MM108=204
MM109=169
MM110=172
MM111=160
MM112=168
MM113=52
MM114=153
MM115=184
MM116=166
MM117=170
MM118=204
MM119=169
MM120=172
MM121=156
MM122=134
MM123=0
MM124=149
MM125=182
MM126=166
MM127=170
MM128=203
MM129=169
MM130=170
MM131=104
MM132=0
MM133=0
MM134=149
MM135=181
MM136=165
MM137=172
MM138=204
MM139=146
MM140=0
MM141=0
MM142=0
MM143=0
MM144=153
MM145=181
MM146=165
MM147=137
MM148=28
MM149=0
MM150=0
MM151=0
MM152=0
MM153=0
MM154=37
MM155=41
MM156=0
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
MM636=0
MM637=0
MM638=0
MM639=0
MM640=0
MM641=0
MM642=0
MM643=0
MM644=0
MM645=0
MM646=63
MM647=15
MM648=0
MM649=100
MM650=0
MM651=25
MM652=1
MM653=44
MM654=0
MM655=150
MM656=1
MM657=44
MM658=0
MM659=0
MM660=7
MM661=208
MM662=23
MM663=0
MM664=50
MM665=37
MM666=0
MM667=50
MM668=0
MM669=25
MM670=0
