jeffmakes/tr20-badge-hw/(commit log)

2019-09-30 ESP32 IO signal mapping
    [signals.ods]
2019-09-30 Add PCA9555 signal mapping
    [signals.ods]
2019-10-30 Add CC and IQS reset lines to PCA9555
    [signals.ods]
2019-10-30 Add jeffmakes-kicad-library as a submodule
2019-10-31 Add digikey-kicad-library as a submodule
2019-10-31 Add official kicad libs as submodules
2019-10-31 Create empty kicad project
    [tr20.kicad_pcb, tr20.sch]
2019-11-03 Update official kicad libs
2019-11-03 Split design into hierarchical modules.
    [_display.sch, _io_expander.sch, _leds.sch, _micro_sd.sch, _power.sch, _usb.sch, tr20.sch]
2019-11-03 Footprint library path table. Use only local libraries from submodules in ../../lib
2019-11-03 Fix broken refdeses
    [_display.sch, _io_expander.sch, _leds.sch, _micro_sd.sch, _power.sch, _usb.sch, tr20.kicad_pcb]
2019-11-03 Fix broken component timestamps
    [_display.sch, _io_expander.sch, _leds.sch, _power.sch, _usb.sch, tr20.kicad_pcb]
2019-11-03 SD card detect line
    [signals.ods]
2019-11-04 Import touchpad schematic and layout from TR19
    [_display.sch, _io_expander.sch, _leds.sch, _micro_sd.sch, _power.sch, _touchpad.sch, _usb.sch, tr20.kicad_pcb]
2019-11-04 Remove unwanted parts, including mechanical keyboard. Move touchpad parts into place
    [_display.sch, _io_expander.sch, _leds.sch, _micro_sd.sch, _power.sch, _touchpad.sch, _usb.sch, tr20.sch]
2019-11-04 Touchpad placed
    [tr20.kicad_pcb]
2019-11-04 Reorganise ESP32 pins
    [tr20.sch]
2019-11-06 Connect all signals to ESP32
    [_io_expander.sch, tr20.kicad_pcb, tr20.sch]
2019-11-06 Move accel and shitty addon to separate sheets. Create audio sheet.
    [_display.sch, _io_expander.sch, _leds.sch, _micro_sd.sch, _power.sch, _touchpad.sch, _usb.sch, accelerometer.sch]
2019-11-06 Tidy signal names, add accel_int line to io expander
    [signals.ods]
2019-11-06 I2S connections
    [audio.sch, tr20.sch]
2019-11-22 Rename modues to consistent _scheme, add cc1200 circuit
    [_accelerometer.sch, _audio.sch, _display.sch, _io_expander.sch, _leds.sch, _micro_sd.sch, _power.sch, _radio.sch]
2019-11-22 Set directions on IQ/CC_RESET signals
    [_io_expander.sch, _radio.sch]
2019-11-22 Remove renamed file
    [accelerometer.sch]
2019-11-22 IQ_RESET signal naming
    [signals.ods]
2019-11-22 Connect CC1200 signals
    [tr20.sch]
2019-11-22 Fix reset line direction
    [_touchpad.sch]
2019-11-22 Tidy up block placement
    [tr20.sch]
2019-11-23 Update lib to include haptic driveR
2019-11-23 Add haptic circuit. Add level translation on WS2812 data line
    [_accelerometer.sch, _audio.sch, _display.sch, _haptic.sch, _io_expander.sch, _leds.sch, _micro_sd.sch, _power.sch]
2019-11-23 Add haptic driver datasheet
2019-11-23 Annotate components
    [_accelerometer.sch, _audio.sch, _display.sch, _haptic.sch, _io_expander.sch, _leds.sch, _micro_sd.sch, _power.sch]
2019-11-23 Add missing CC_INT line
    [_radio.sch, tr20.sch]
2019-11-23 Switch to PCA9555 with active-low signals, removing pulldowns
    [_accelerometer.sch, _io_expander.sch, _power.sch, _radio.sch, _usb.sch, tr20.sch]
2019-11-23 Audio jack
    [_audio.sch]
2019-11-23 Remove accelerometer. ERC pass
    [_display.sch, _haptic.sch, _io_expander.sch, _leds.sch, _micro_sd.sch, _power.sch, _radio.sch, _shitty_addon.sch]
2019-11-23 Assign footprints
    [_audio.sch, _haptic.sch, _io_expander.sch, _micro_sd.sch, _radio.sch, _touchpad.sch, tr20.sch]
2019-11-23 Add audio jack
    [_audio.sch]
2019-11-23 Add correct microSD connector
    [_micro_sd.sch]
2019-11-23 Assign footprint for microsd
    [_micro_sd.sch]
2019-11-23 Add antenna
    [_radio.sch]
2019-11-23 Remove LED header
    [_leds.sch]
2019-11-23 Resize touch array
    [_touchpad.sch, tr20.kicad_pcb]
2019-11-25 Add +3V3 mesh
    [tr20.kicad_pcb]
2019-11-25 Change to 0402 100nF
    [_audio.sch, _display.sch, _haptic.sch, _io_expander.sch, _leds.sch, _micro_sd.sch, _power.sch, _radio.sch]
2019-11-25 Rip up a load of stuff
    [tr20.kicad_pcb]
2019-11-25 Rename LEDs
    [_leds.sch]
2019-11-25 Part placement
    [tr20.kicad_pcb]
2019-11-25 Add missing parts in radio circuit
    [_radio.sch]
2019-11-25 Radio circuit routed
    [tr20.kicad_pcb]
2019-11-26 Radio circuit fixes
    [_radio.sch]
2019-11-26 Remove test points on usb
    [_radio.sch, _usb.sch, tr20.kicad_pcb]
2019-11-26 Schematic cleanup
    [_display.sch, _haptic.sch, _power.sch, _shitty_addon.sch, _touchpad.sch]
2019-11-26 Touchpad routed
    [tr20.kicad_pcb]
2019-11-27 Upgrade to Shitty Addon v1.69bis. (SAO.69). SAO_GPIO1 is connected to the end of the SK6812 bus, SAO_GPIO2 is connected to one of the PCA9555 IO's
    [_io_expander.sch, _leds.sch, _power.sch, _shitty_addon.sch, _usb.sch, tr20.sch]
2019-11-27 Replace original IQS debug header
    [_touchpad.sch, tr20.kicad_pcb]
2019-11-27 SD, IO expander routing
    [tr20.kicad_pcb]
2019-11-27 DAC routed
    [_audio.sch, _touchpad.sch, tr20.kicad_pcb]
2019-11-27 Audio jack wired
    [tr20.kicad_pcb]
2019-11-27 TVS diodes, power switch
    [_leds.sch, _power.sch, _shitty_addon.sch, tr20.kicad_pcb]
2019-11-27 I2C routed
    [_io_expander.sch, tr20.kicad_pcb]
2019-11-27 more routing
    [tr20.kicad_pcb]
2019-11-27 Add inner layer connections across trackpad
    [tr20.kicad_pcb]
2019-11-27 Most long range connections routed
    [tr20.kicad_pcb]
2019-11-28 LED routing, bottom ground plane
    [tr20.kicad_pcb]
2019-11-28 Via stitching
    [tr20.kicad_pcb]
2019-11-28 Ground joystick shell
    [_io_expander.sch, tr20.kicad_pcb, tr20.sch]
2019-11-28 Remove current measurement cut-trace header
    [_power.sch]
2019-11-28 All signals routed!
    [tr20.kicad_pcb]
2019-11-28 DRC pass
    [tr20.kicad_pcb]
2019-11-28 Clean up routing of touchpad on ground layer for new via spacing
    [tr20.kicad_pcb]
2019-11-28 Make RX signal names less confusing
    [_touchpad.sch]
2019-11-28 Remove netlist file - not necessary in modern Kicad
2019-11-28 BoM cleanup - fix weird duplicated diode, set voltage rating on a cap
    [_display.sch, _power.sch, _radio.sch]
2019-11-28 Clean up silk
    [tr20.kicad_pcb]
2019-12-01 Rename layers
    [tr20.kicad_pcb]
2019-12-01 Fix via tenting in touchpad
    [tr20.kicad_pcb]
2019-12-01 Change LED symbol to SK6812 with more sensible pin numbers
    [_leds.sch]
2019-12-01 Update LED footprints
    [tr20.kicad_pcb]
2019-12-01 Tweak switch position
    [tr20.kicad_pcb]
2019-12-01 TH SMA connector, SAO silkscreen
    [_radio.sch, tr20.kicad_pcb]
2019-12-02 Split display out into two parts - display and connector
    [_display.sch]
2019-12-02 Move display up 2mm
    [tr20.kicad_pcb]
2019-12-02 Set display value
    [_display.sch]
2019-12-02 Reroute USB and nudge buttons to accommodate new display position
    [tr20.kicad_pcb]
2019-12-02 Nudge shitty addon connector downwards
    [tr20.kicad_pcb]
2019-12-02 Nudge buttons inward
    [tr20.kicad_pcb]
2019-12-02 Add F.silk art
    [tr20.kicad_pcb]
2019-12-17 Update schematic to reflect BoM changes
    [_display.sch, _usb.sch, tr20.sch]
2019-12-17 As fabricated
    [tr20.kicad_pcb]
2019-12-17 Fabrication data
    [signals.ods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]
2019-12-17 Starting r2
    [_accelerometer.sch, _audio.sch, _display.sch, _haptic.sch, _io_expander.sch, _leds.sch, _micro_sd.sch, _power.sch]
2019-12-18 Add headphone amp. DAC is just being abused too much driving headphones directly
    [_audio.sch]
2019-12-19 Flip LRA connector wiring
    [_haptic.sch]
2019-12-19 remove LED level translation BJT - saturation recovery time is too slow
    [_leds.sch]
2019-12-19 New SAO connector - throughboard type
    [_shitty_addon.sch]
2019-12-19 Switch to smaller debug connector for IQS debug
    [_touchpad.sch]
2019-12-19 Add CC resistors for USB-C power
    [_usb.sch]
2019-12-19 Move display down by 1.5mm, correct slot position. Import new connectivity.
    [tr20.kicad_pcb]
2019-12-19 Routed USB-C
    [tr20.kicad_pcb]
2019-12-19 Move audio onto 3.3V rail
    [_audio.sch]
2019-12-19 Route all IO pins out of hierarchy block
    [_io_expander.sch]
2019-12-19 Change footprint on IQS debug header
    [_touchpad.sch]
2019-12-19 Create enable signal for amp
    [tr20.sch]
2019-12-19 New parts placed
    [tr20.kicad_pcb]
2019-12-19 Connect amp ground pad
    [_audio.sch]
2019-12-19 Audio nearly routed
    [tr20.kicad_pcb]
2019-12-19 Audio full routed
    [tr20.kicad_pcb]
2019-12-19 SAO routed
    [tr20.kicad_pcb]
2019-12-19 All nets routed
    [tr20.kicad_pcb]
2019-12-19 Badass silkscreen design
    [tr20.kicad_pcb]
2019-12-19 Move stitching vias out of the silkscreen. DRC pass
    [tr20.kicad_pcb]
2019-12-19 Make IQS debug header DNP
    [_audio.sch, _radio.sch, _shitty_addon.sch, _touchpad.sch]
2019-12-19 Add wrover part number
    [tr20.sch]
2019-12-19 Moved top LED's up to allow space for ON text
    [tr20.kicad_pcb]
2019-12-21 x-ray challenge.
    [tr20.kicad_pcb]
2019-12-21 Display nearly moved centrally
    [tr20.kicad_pcb]
2019-12-21 Move display to centerline, move microsd in a bit
    [tr20.kicad_pcb]
2019-12-21 All signals routed
    [tr20.kicad_pcb]
2019-12-21 Working on DRC bugs
    [tr20.kicad_pcb]
2019-12-23 Change to cutout-type USB connector
    [_usb.sch]
2019-12-24 Add strengthening vias to audio jack
    [_audio.sch]
2019-12-24 Rename kicad project folder... Let's see what this breaks :D
    [_accelerometer.sch, _audio.sch, _display.sch, _haptic.sch, _io_expander.sch, _leds.sch, _micro_sd.sch, _power.sch]
2019-12-24 Rename kicad project folder... Right name, this time!
    [_accelerometer.sch, _audio.sch, _display.sch, _haptic.sch, _io_expander.sch, _leds.sch, _micro_sd.sch, _power.sch]
2019-12-24 Update footprints, DRC items
    [tr20.kicad_pcb]
2019-12-24 Rename kicad project folder... better name
    [_accelerometer.sch, _audio.sch, _display.sch, _haptic.sch, _io_expander.sch, _leds.sch, _micro_sd.sch, _power.sch]
2019-12-24 Rename project again
    [_accelerometer.sch, _audio.sch, _display.sch, _haptic.sch, _io_expander.sch, _leds.sch, _micro_sd.sch, _power.sch]
2019-12-24 more docs
    [CC1200EM_868_930_partlist_1_1_0.xlsx, art_param.txt, nc_param.txt, top.kicad_pcb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]
2019-12-24 r1 fabrication data as manufactured
    [t20-kicad.kicad_pcb, t20.kicad_pcb, tr20 (2) materials price.xlsx, tr20-omg.xlsx, tr20-r1-bottom.csv, tr20-r1-bottom.xlsx, tr20-r1-coverlay.dxf, tr20-r1-top.csv]
2019-12-24 graphics is a total fuckup as usual
    [1.dxf, 2.dxf, edge-cuts.kicad_pcb, edge-flat-distort.dxf, edge-flat.dxf, r3.kicad_pcb, tr20-Edge_Cuts.dxf, tr20-r2-bsilk-subtract.kicad_pcb]
2019-12-25 keep fucking renaming this nonsense
    [r2.kicad_pcb]
2019-12-25 RENAME YOU FUCK JUST RENAME
    [r2.sch]
2019-12-25 Fabricate. End of history
    [r2.kicad_pcb]
2019-12-25 create fab data
    [r2-B_Cu.gbr, r2-B_Mask.gbr, r2-Edge_Cuts.gbr, r2-F_Cu.gbr, r2-F_Mask.gbr, r2-In1_Cu.gbr, r2-In2_Cu.gbr, r2-job.gbrjob]
2019-12-25 release frozen
    [tr20-r2-frozen.kicad_pcb]
2019-12-25 Create drill data
    [tr20-r2-frozen-NPTH-drl_map.gbr, tr20-r2-frozen-NPTH.drl, tr20-r2-frozen-PTH-drl_map.gbr, tr20-r2-frozen-PTH.drl]
2019-12-25 Create gerber
    [tr20-r2-frozen-B_Cu.gbr, tr20-r2-frozen-B_Mask.gbr, tr20-r2-frozen-Edge_Cuts.gbr, tr20-r2-frozen-F_Cu.gbr, tr20-r2-frozen-F_Mask.gbr, tr20-r2-frozen-In1_Cu.gbr, tr20-r2-frozen-In2_Cu.gbr, tr20-r2-frozen-job.gbrjob]
2020-02-05 Remove frozen gerbers
    [tr20-r2-frozen-B_Cu.gbr, tr20-r2-frozen-B_Mask.gbr, tr20-r2-frozen-Edge_Cuts.gbr, tr20-r2-frozen-F_Cu.gbr, tr20-r2-frozen-F_Mask.gbr, tr20-r2-frozen-In1_Cu.gbr, tr20-r2-frozen-In2_Cu.gbr, tr20-r2-frozen-NPTH-drl_map.gbr]
2020-02-05 Remove stackup definition which was preventing file from opening in my version of kicad, for some unexplained reason
    [r2.kicad_pcb]
2020-02-05 Remove frozen modules
    [tr20-r2-frozen.kicad_pcb]
2020-02-05 Some noise in the CommentN "" fields
    [_audio.sch, _display.sch, _haptic.sch, _io_expander.sch, _leds.sch, _micro_sd.sch, _power.sch, _radio.sch]
2020-02-05 Change USB-A footprint back to on-board type rather than in-board type
    [_usb.sch]
2020-02-05 Updated USB-A footprint, board edge corrected to match
    [r2.kicad_pcb]
2020-02-05 DRC pass, silk for SAO
    [r2.kicad_pcb]
2020-02-05 Add credits
    [r2.kicad_pcb]
2020-02-05 Tweak x-ray challenge
    [r2.kicad_pcb]
2020-02-08 Update value for USB-A connector
    [_usb.sch, tr20_bom_.csv]
2020-02-08 Sync bom to schematic
    [tr20-r2.xlsx]
2020-02-08 PCB sent for fabrication. Move all names and values to Degs.User layer so we can exclude from assembly drawings
    [r2.kicad_pcb]
2020-02-09 Replace D1, D2, D4 to include diode direction marker for assembly drawing
    [_power.sch, r2.kicad_pcb]
2020-02-09 Some noise about library cache
    [_audio.sch, _display.sch, _haptic.sch, _io_expander.sch, _leds.sch, _micro_sd.sch, _radio.sch, _shitty_addon.sch]
2020-02-09 Assembly data - placement files and assembly drawings
2020-02-09 Fabrication data as issued to board house
    [r2-B_Cu.gbr, r2-B_Mask.gbr, r2-B_Paste.gbr, r2-B_SilkS.gbr, r2-Edge_Cuts.gbr, r2-F_Cu.gbr, r2-F_Mask.gbr, r2-F_Paste.gbr]
2020-02-09 Move bom into repo
    [r2_bom_.csv, tr20-r2.xlsx, tr20_final quote_191218.xlsx]
2020-02-17 Working on alternative BoM contingency in case we need to switch to western suppliers
    [tr20-r2-alternative-sources.xlsx]
2020-02-17 Sourced all the switches
    [tr20-r2-alternative-sources.xlsx]
2020-02-18 All parts researched, most parts sourced, total price estimate probably a decent estimate
    [tr20-r2-alternative-sources.xlsx]
2020-02-18 Remove space-wasting column, add some TODO's
    [tr20-r2-alternative-sources.xlsx]
2020-02-18 Corrected colour highlighting
    [tr20-r2-alternative-sources.xlsx]
2020-02-18 Sync with main bom. Add surplus column to check all lines have enough spare parts
    [tr20-r2-alternative-sources.xlsx]
2020-02-19 Remove highlighting from parts that have arrived
    [tr20-r2.xlsx]
2020-02-19 Docs for connectors from alternative, western, vendors
2020-02-23 Update submodule url for kicad-symbols
2020-02-25 Tidy up duplicated bom files
    [tr20-r2-alternative-sources.xlsx, tr20-r2.xlsx]
2020-06-01 Add assembly release zip
    [test.ods]
2020-06-01 Kicad file noise
    [tr20.kicad_pcb]
2020-06-01 BoM file noise
    [tr20-r2.xlsx]
2020-12-18 Set submodule jeffmakes-kicad-library remote as github rather than monad.
